hwan94877103-cloud/Re-Cell/images/process/공정1_팩입고_최종.png

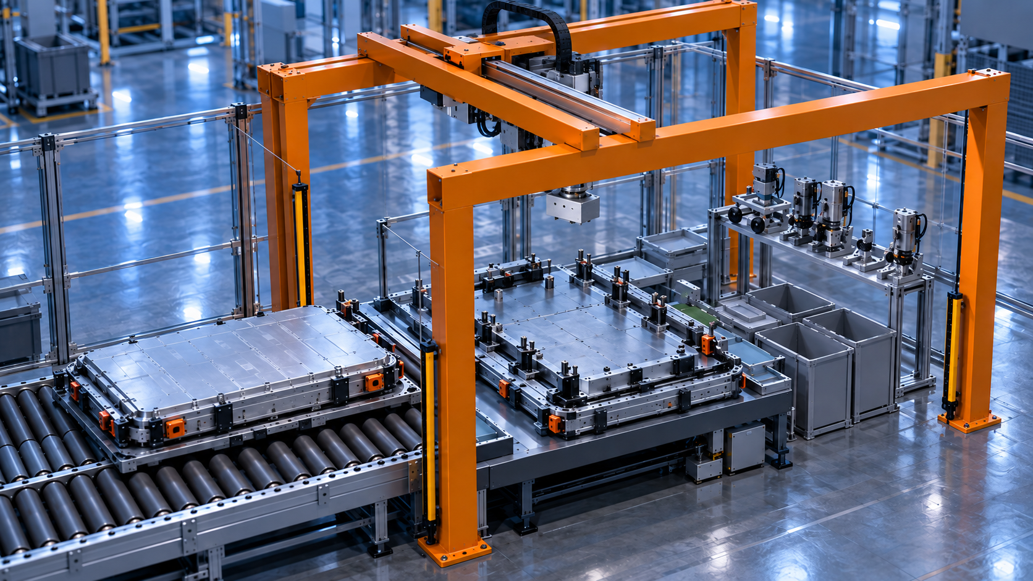
images/process/공정1_팩입고_최종.png
