hwan94877103-cloud/Re-Cell/images/process/공정2_커버제거_최종.png

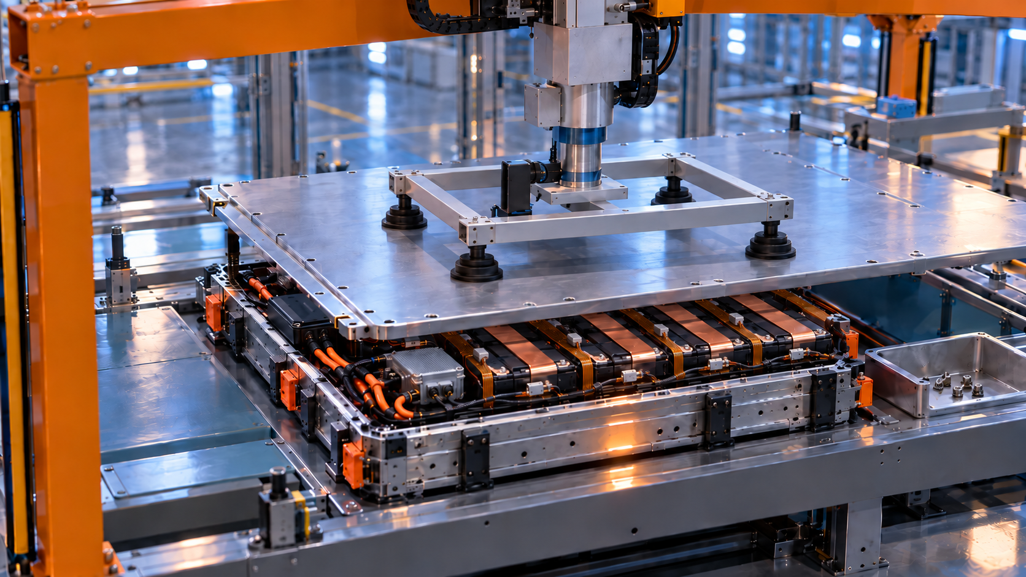
images/process/공정2_커버제거_최종.png
