hwan94877103-cloud/Re-Cell/images/process/공정3_버스바절단_최종.png

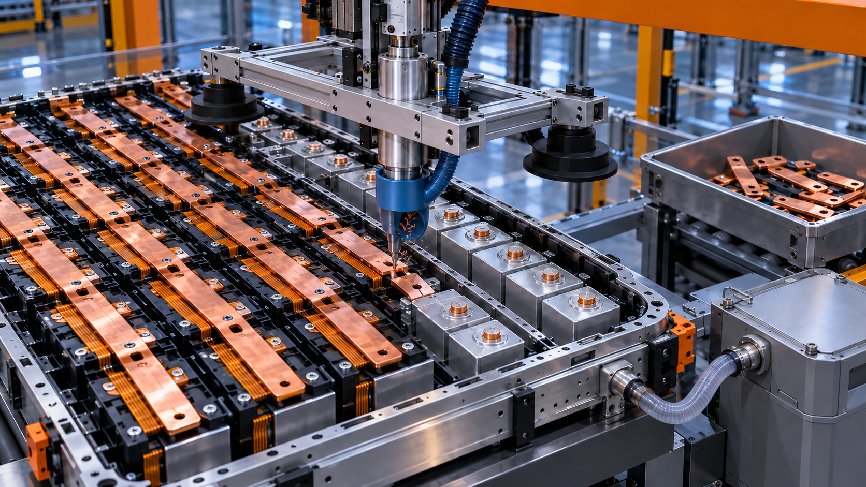
images/process/공정3_버스바절단_최종.png
