hwan94877103-cloud/Re-Cell/images/process/공정4_구역가열_최종.png

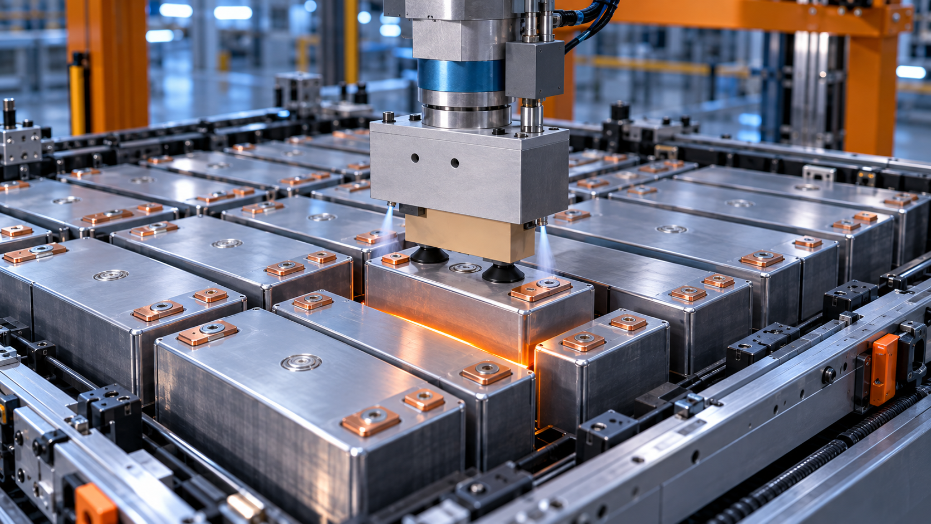
images/process/공정4_구역가열_최종.png
