hwan94877103-cloud/Re-Cell/images/process/공정5_셀들기_최종.png

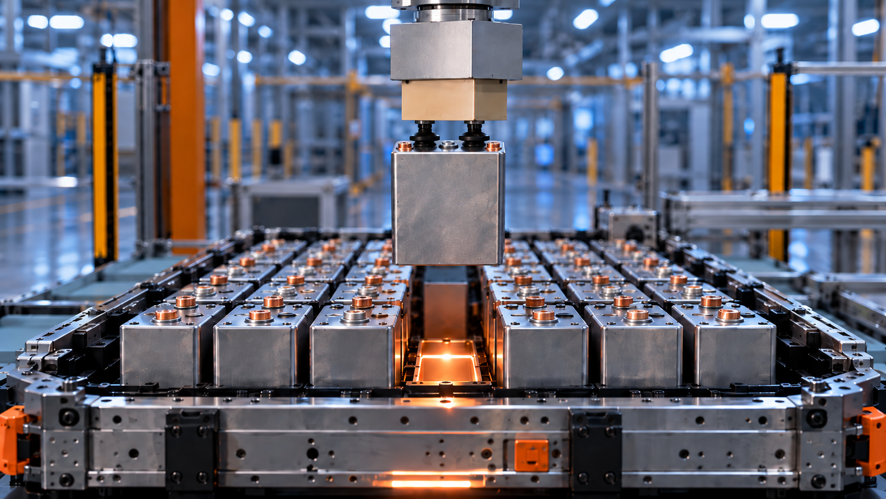
images/process/공정5_셀들기_최종.png
