hwan94877103-cloud/Re-Cell/images/process/공정6_측정분류_최종.png

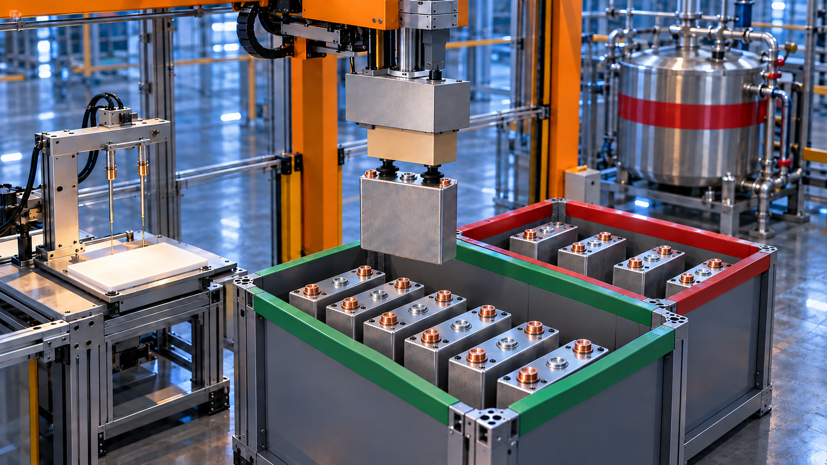
images/process/공정6_측정분류_최종.png
