hwan94877103-cloud/Re-Cell/images/renders/TOOL02_tool02_below.png

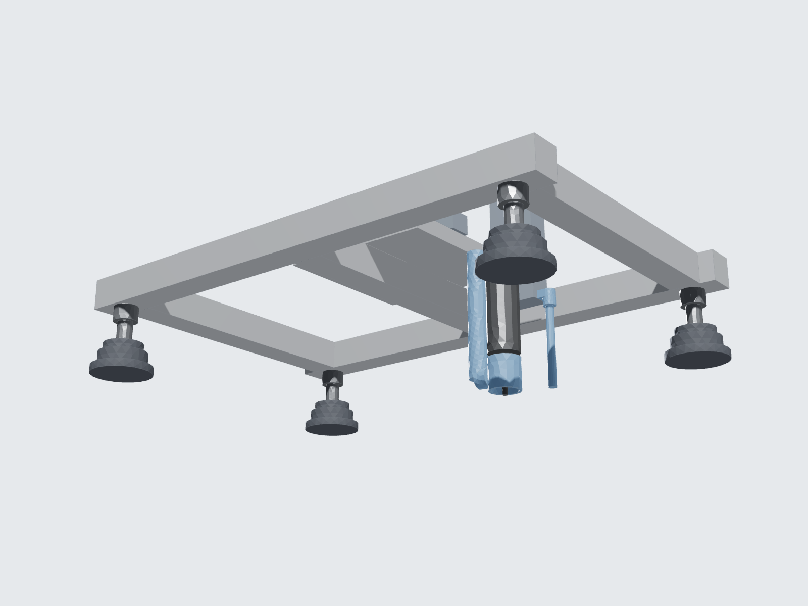
images/renders/TOOL02_tool02_below.png
