hwan94877103-cloud/Re-Cell/images/renders/TOOL03_등각_가장자리음영_크롭.png

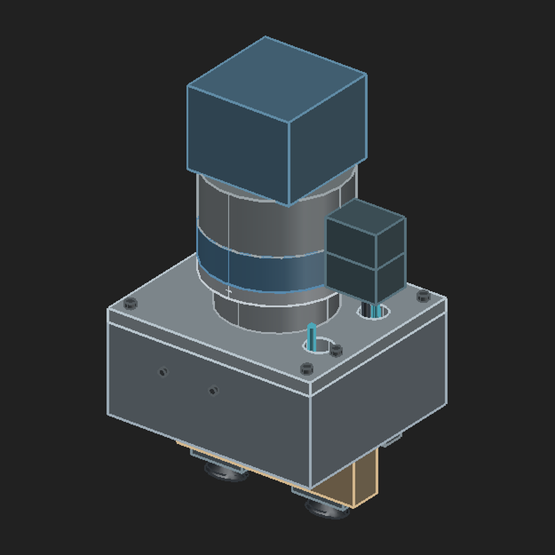
images/renders/TOOL03_등각_가장자리음영_크롭.png
