hwan94877103-cloud/Re-Cell/images/renders/TOOL03_아래에서_현실적_크롭.png

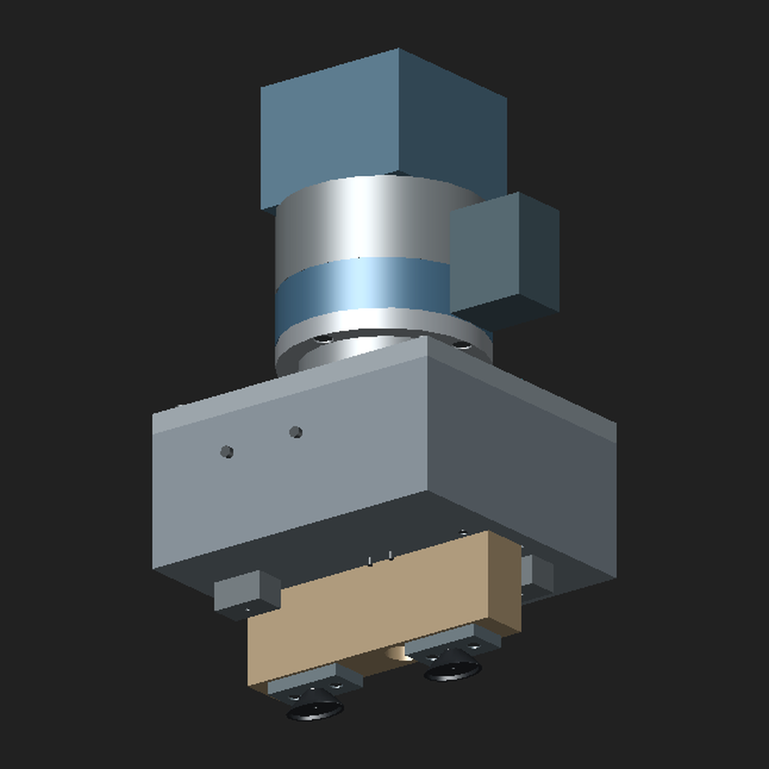
images/renders/TOOL03_아래에서_현실적_크롭.png
