hwan94877103-cloud/Re-Cell/3d/TOOL03_R03_assembly.step

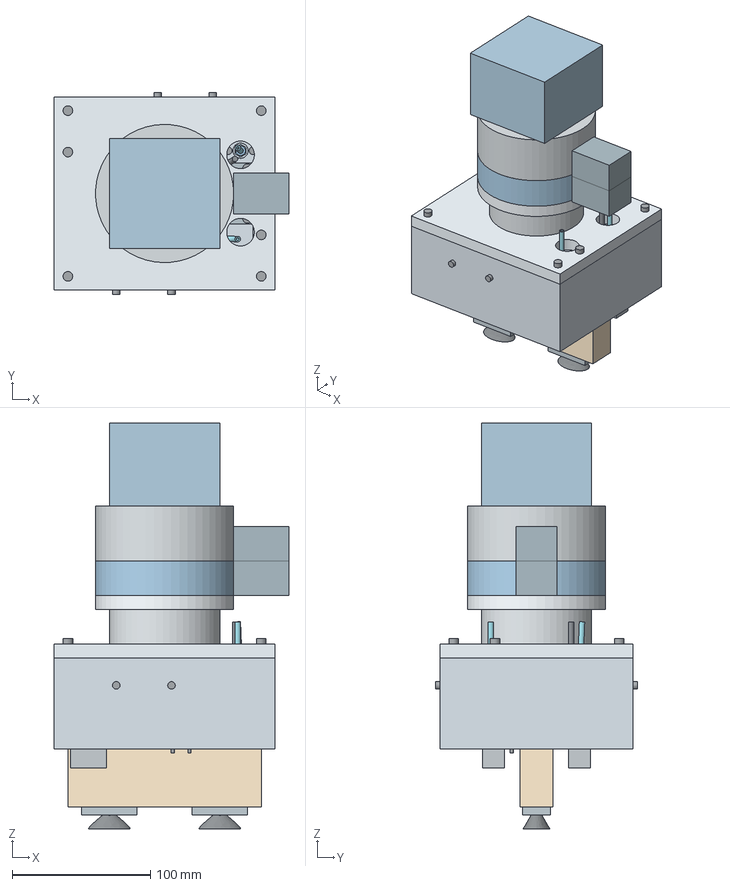
[picture p28: CAD file, 2026-10-16]
3d/TOOL03_R03_assembly.step
170.0 x 146.0 x 294.0 mm
000_03-001_nose_PEEK
001_03-002_housing_body
002_03-003_top_plate_t10
003_03-004_retainer_front
004_03-005_retainer_rear_left
005_03-006_retainer_rear_right
006_03-007_cup_bracket
007_03-102_cup_nipple_M5
008_03-103_nut_M5_thin
009_03-101_oval_cup_30x20
010_03-206_insert_M3_PEEK
011_03-205_SHCS_M3x8_cup
012_03-206_insert_M3_PEEK
013_03-205_SHCS_M3x8_cup
014_03-301_vacuum_hose_OD4
015_03-007_cup_bracket
016_03-102_cup_nipple_M5
017_03-103_nut_M5_thin
018_03-101_oval_cup_30x20
019_03-206_insert_M3_PEEK
020_03-205_SHCS_M3x8_cup
021_03-206_insert_M3_PEEK
022_03-205_SHCS_M3x8_cup
023_03-301_vacuum_hose_OD4
024_03-104_IR_sensor_D18x40
025_03-008_IR_clamp_rear
026_03-009_IR_clamp_front
027_03-204_SHCS_M3x30
028_03-204_SHCS_M3x30
029_03-203_SHCS_M3x25
030_03-203_SHCS_M3x25
031_03-105_IR_cable
032_03-201_SHCS_M4x18_retainer
033_03-201_SHCS_M4x18_retainer
034_03-201_SHCS_M4x18_retainer
035_03-201_SHCS_M4x18_retainer
036_03-207_SHCS_M3x12
037_03-207_SHCS_M3x12
038_03-010_nozzle_block
039_03-213_O_ring_P6
040_03-106_push_in_fitting_M5
041_03-207_SHCS_M3x12
042_03-207_SHCS_M3x12
043_03-010_nozzle_block
044_03-213_O_ring_P6
045_03-106_push_in_fitting_M5
046_03-302_cooling_air_hose_OD4
047_03-302_cooling_air_hose_OD4
048_03-107_vacuum_unit
049_03-212_SHCS_M3x8_unit
050_03-212_SHCS_M3x8_unit
051_03-107_vacuum_unit
052_03-212_SHCS_M3x8_unit
053_03-212_SHCS_M3x8_unit
054_03-208_SHCS_M4x20
055_03-208_SHCS_M4x20
056_03-208_SHCS_M4x20
057_03-208_SHCS_M4x20
058_03-208_SHCS_M4x20
059_03-208_SHCS_M4x20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
