hwan94877103-cloud/Re-Cell/3d/BENCH_block_2x12_assembly.step

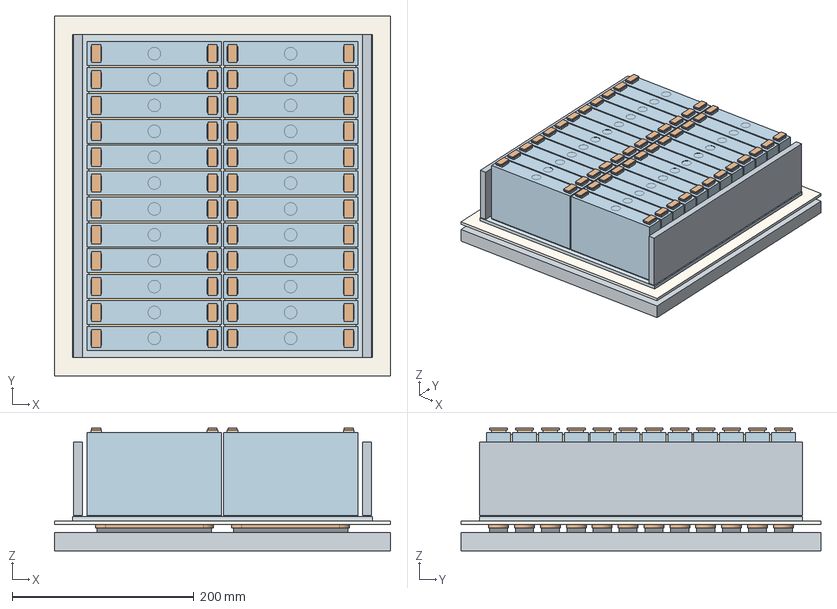
[picture p29: CAD file, 2026-10-16]
3d/BENCH_block_2x12_assembly.step
370.0 x 396.0 x 135.0 mm
000_cell_A-6
001_terminal_A-6
002_busbar_residue_A-6
003_terminal_A-6
004_busbar_residue_A-6
005_adhesive_layer_A-6
006_compression_pad_A-6
007_coil_A-6
008_ferrite_A-6
009_temp_sensor_A-6
010_cell_A-5
011_terminal_A-5
012_busbar_residue_A-5
013_terminal_A-5
014_busbar_residue_A-5
015_adhesive_layer_A-5
016_compression_pad_A-5
017_coil_A-5
018_ferrite_A-5
019_temp_sensor_A-5
020_cell_A-4
021_terminal_A-4
022_busbar_residue_A-4
023_terminal_A-4
024_busbar_residue_A-4
025_adhesive_layer_A-4
026_compression_pad_A-4
027_coil_A-4
028_ferrite_A-4
029_temp_sensor_A-4
030_cell_A-3
031_terminal_A-3
032_busbar_residue_A-3
033_terminal_A-3
034_busbar_residue_A-3
035_adhesive_layer_A-3
036_compression_pad_A-3
037_coil_A-3
038_ferrite_A-3
039_temp_sensor_A-3
040_cell_A-2
041_terminal_A-2
042_busbar_residue_A-2
043_terminal_A-2
044_busbar_residue_A-2
045_adhesive_layer_A-2
046_compression_pad_A-2
047_coil_A-2
048_ferrite_A-2
049_temp_sensor_A-2
050_cell_A-1
051_terminal_A-1
052_busbar_residue_A-1
053_terminal_A-1
054_busbar_residue_A-1
055_adhesive_layer_A-1
056_compression_pad_A-1
057_coil_A-1
058_ferrite_A-1
059_temp_sensor_A-1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
