hwan94877103-cloud/Re-Cell/3d/CTP_R03_complete_assembly_working_pose.step

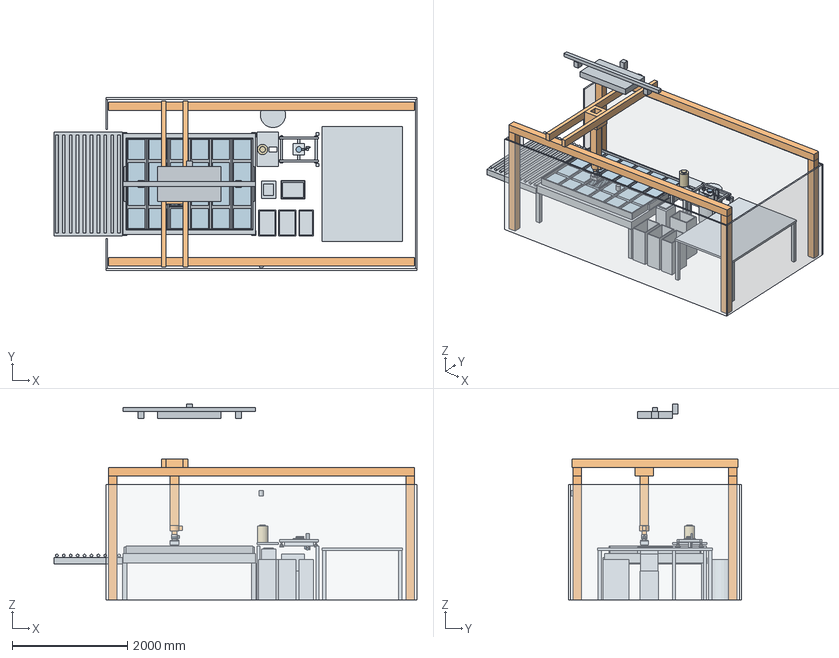
[picture p30: CAD file, 2026-10-16]
3d/CTP_R03_complete_assembly_working_pose.step
6300.0 x 3000.0 x 3400.0 mm
000_fence_safety_fence
001_fence_safety_fence
002_fence_safety_fence
003_fence_safety_fence
004_fence_safety_fence
005_conveyor_intake_conveyor
006_conveyor_roller
007_conveyor_roller
008_conveyor_roller
009_conveyor_roller
010_conveyor_roller
011_conveyor_roller
012_conveyor_roller
013_conveyor_roller
014_conveyor_roller
015_conveyor_roller
016_bench_heating_bench_coil_zone
017_bench_leg
018_bench_leg
019_bench_leg
020_bench_leg
021_bench_pack_clamp
022_bench_pack_clamp
023_pack_frame
024_pack_frame
025_pack_frame
026_pack_frame
027_pack_cooling_plate
028_pack_cell_block_2x12
029_pack_cell_block_2x12
030_pack_cell_block_2x12
031_pack_cell_block_2x12
032_pack_cell_block_2x12
033_pack_cell_block_2x12
034_pack_cell_block_2x12
035_pack_cell_block_2x12
036_pack_cell_block_2x12
037_pack_cell_block_2x12
038_pack_cell_block_2x12
039_pack_cell_block_2x12
040_pack_cell_block_2x12
041_pack_cell_block_2x12
042_pack_cell_block_2x12
043_pack_cell_block_2x12
044_pack_cell_block_2x12
045_pack_cell_block_2x12
046_pack_cell_block_2x12
047_pack_cell_block_2x12
048_pack_cell_block_2x12
049_pack_cell_block_2x12
050_pack_cell_block_2x12
051_pack_block_end_member
052_pack_block_end_member
053_pack_block_end_member
054_pack_block_end_member
055_pack_block_end_member
056_gantry_column
057_gantry_column
058_gantry_column
059_gantry_column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
