hwan94877103-cloud/Re-Cell/3d/TOOL02_R03_outline_assembly.step

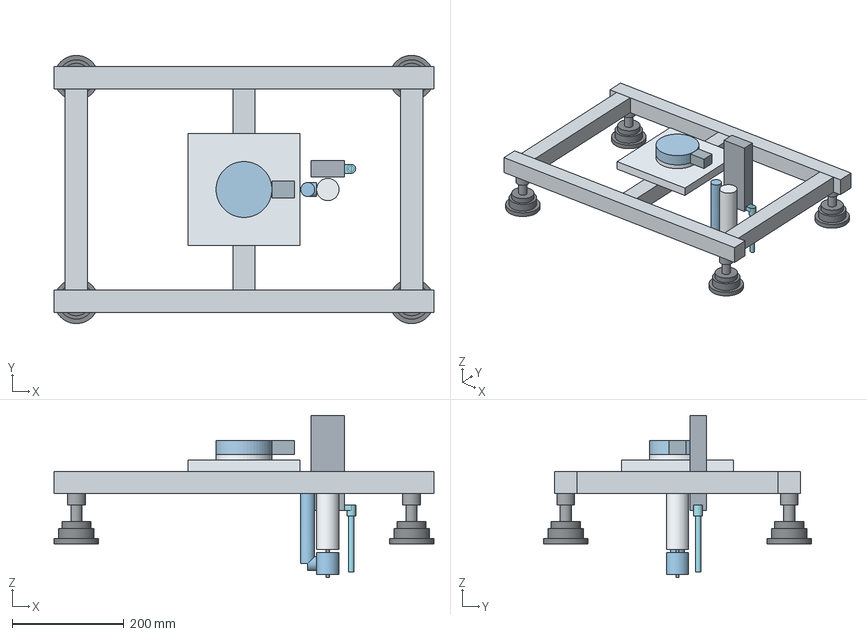
[picture p31: CAD file, 2026-10-16]
3d/TOOL02_R03_outline_assembly.step
680.0 x 480.0 x 290.0 mm
000_suction_cup_D80
001_cup_spring_holder
002_suction_cup_D80
003_cup_spring_holder
004_suction_cup_D80
005_cup_spring_holder
006_suction_cup_D80
007_cup_spring_holder
008_frame_profile_40x40
009_frame_profile_40x40
010_frame_profile_40x40
011_frame_profile_40x40
012_frame_profile_40x40
013_hub_plate
014_adapter_plate
015_changer_tool_plate_D100
016_pass_through_module_tool_side
017_pneumatic_slide_stroke80
018_cutting_spindle_D40
019_end_mill_D6
020_chip_suction_hood_D40
021_chip_suction_hose_D25
022_coolant_suction_nozzle_D10
