hwan94877103-cloud/Re-Cell/drawings/dxf/D-04_R03_2of5.dxf

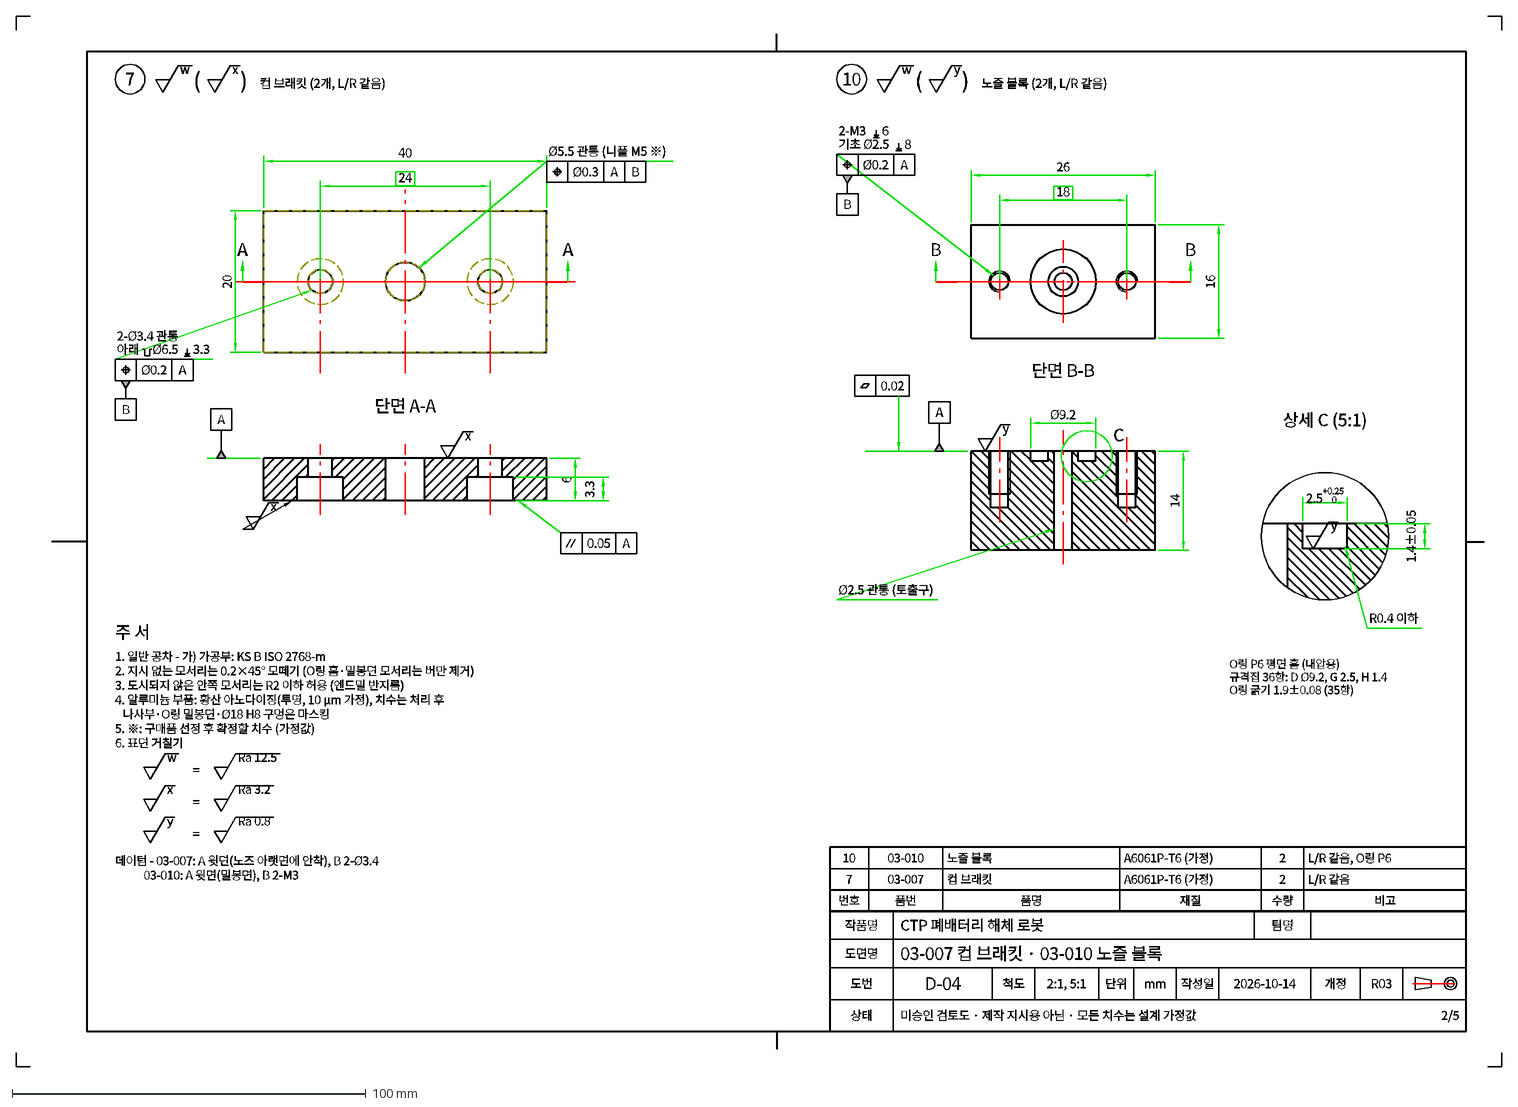
[picture p32: CAD file, 2026-10-16]
drawings/dxf/D-04_R03_2of5.dxf
작품명
CTP 폐배터리 해체 로봇
팀명
도면명
03-007 컵 브래킷 · 03-010 노즐 블록
도번
D-04
척도
2:1, 5:1
단위
mm
작성일
2026-10-14
개정
R03
상태
미승인 검토도 · 제작 지시용 아님 · 모든 치수는 설계 가정값
2/5
A
단면 A-A
40
24
20
6
3.3
아래
Ø6.5
2-Ø3.4 관통
Ø0.2
B
Ø5.5 관통 (니플 M5 ※)
Ø0.3
x
0.05
7
w
(
)
컵 브래킷 (2개, L/R 같음)
단면 B-B
26
18
16
14
Ø9.2
기초 Ø2.5
8
2-M3
Ø2.5 관통 (토출구)
0.02
y
C
상세 C (5:1)
2.5+0.25^ 0
1.4±0.05
R0.4 이하
O링 P6 평면 홈 (내압용)
규격집 36항: D Ø9.2, G 2.5, H 1.4
O링 굵기 1.9±0.08 (35항)
10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
