hwan94877103-cloud/Re-Cell/3d/TOOL03_machined_parts_in_place.step

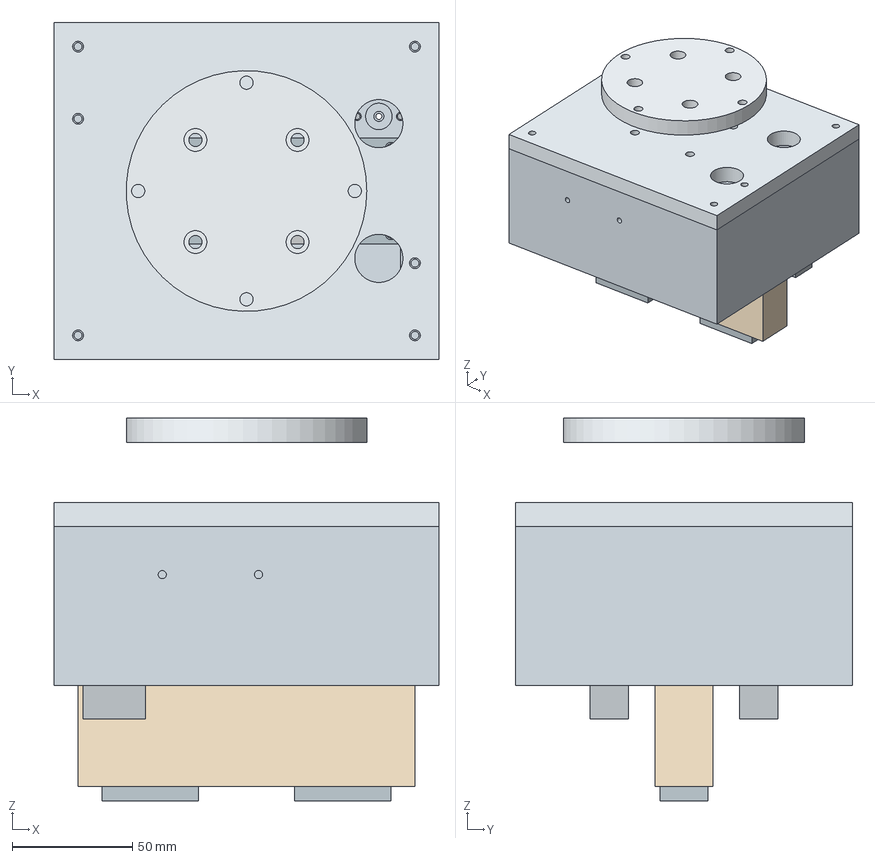
[picture p33: CAD file, 2026-10-16]
3d/TOOL03_machined_parts_in_place.step
160.0 x 140.0 x 159.0 mm
000_03-001_nose_PEEK
001_03-002_housing_body
002_03-003_top_plate_t10
003_03-004_retainer_front
004_03-005_retainer_rear_left
005_03-006_retainer_rear_right
006_03-007_cup_bracket
007_03-007_cup_bracket
008_03-008_IR_clamp_rear
009_03-009_IR_clamp_front
010_03-010_nozzle_block
011_03-010_nozzle_block
012_03-011_loadcell_adapter_plate
