hwan94877103-cloud/Re-Cell/drawings/dxf/D-02_R03_3of3.dxf

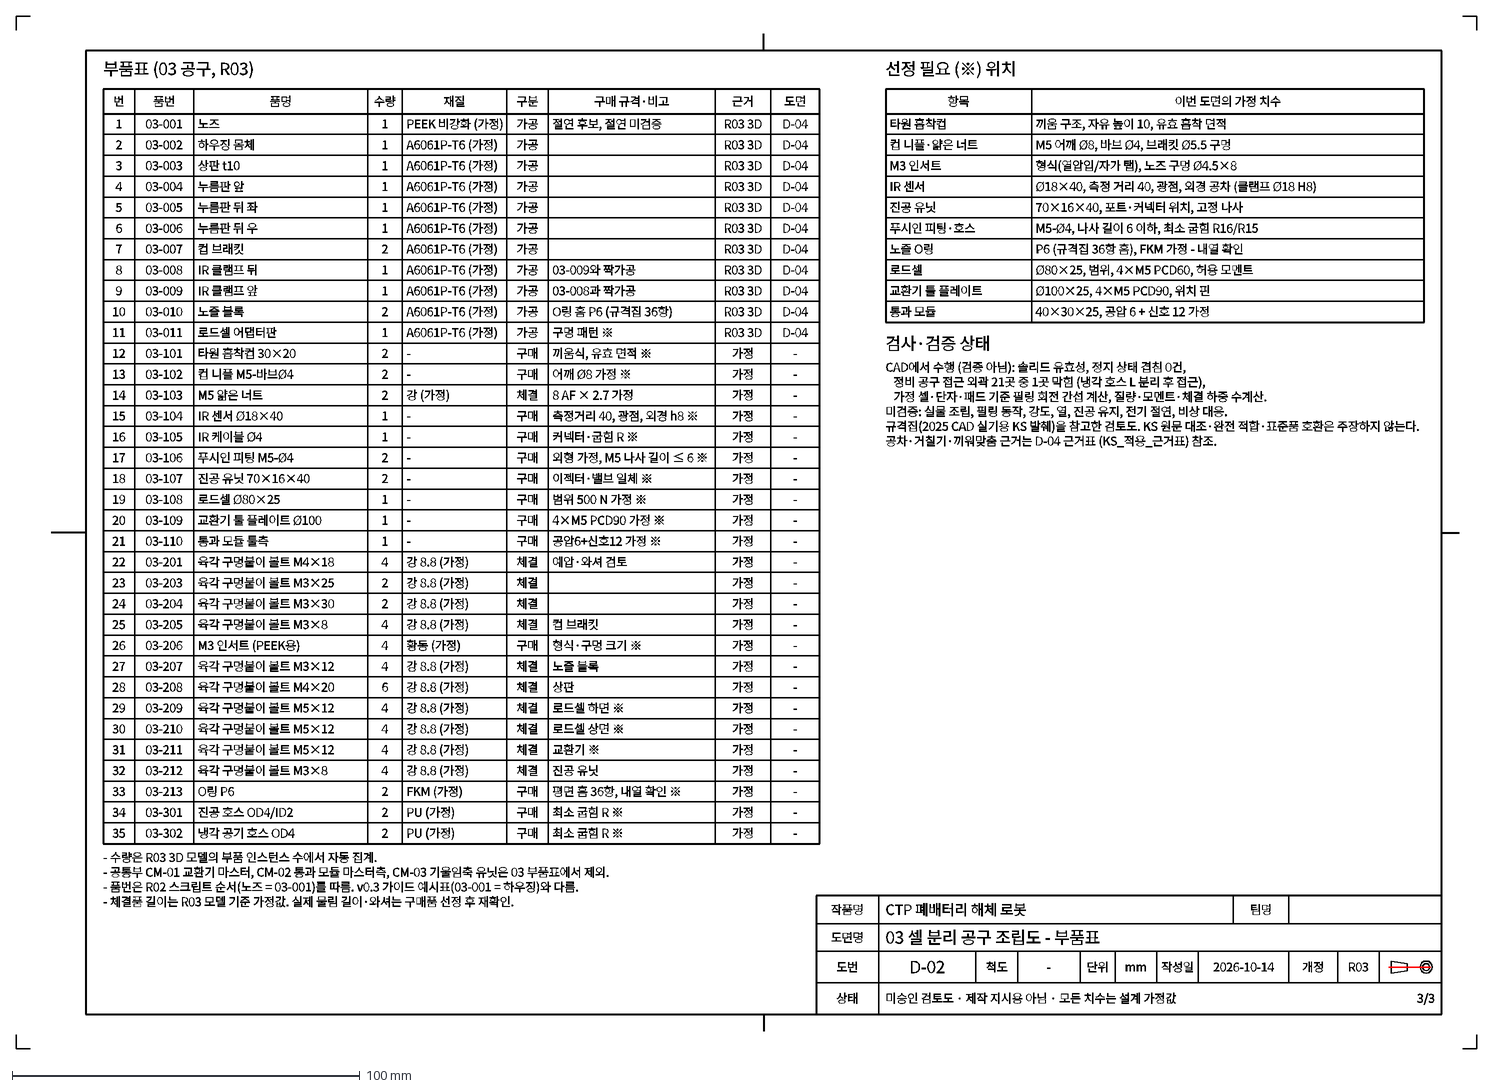
[picture p34: CAD file, 2026-10-16]
drawings/dxf/D-02_R03_3of3.dxf
작품명
CTP 폐배터리 해체 로봇
팀명
도면명
03 셀 분리 공구 조립도 - 부품표
도번
D-02
척도
-
단위
mm
작성일
2026-10-14
개정
R03
상태
미승인 검토도 · 제작 지시용 아님 · 모든 치수는 설계 가정값
3/3
부품표 (03 공구, R03)
번
품번
품명
수량
재질
구분
구매 규격·비고
근거
도면
1
03-001
노즈
PEEK 비강화 (가정)
가공
절연 후보, 절연 미검증
R03 3D
D-04
2
03-002
하우징 몸체
A6061P-T6 (가정)
3
03-003
상판 t10
4
03-004
누름판 앞
5
03-005
누름판 뒤 좌
6
03-006
누름판 뒤 우
7
03-007
컵 브래킷
8
03-008
IR 클램프 뒤
03-009와 짝가공
9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
