hwan94877103-cloud/Re-Cell/3d/BENCH_with_TOOL03_working_pose.step

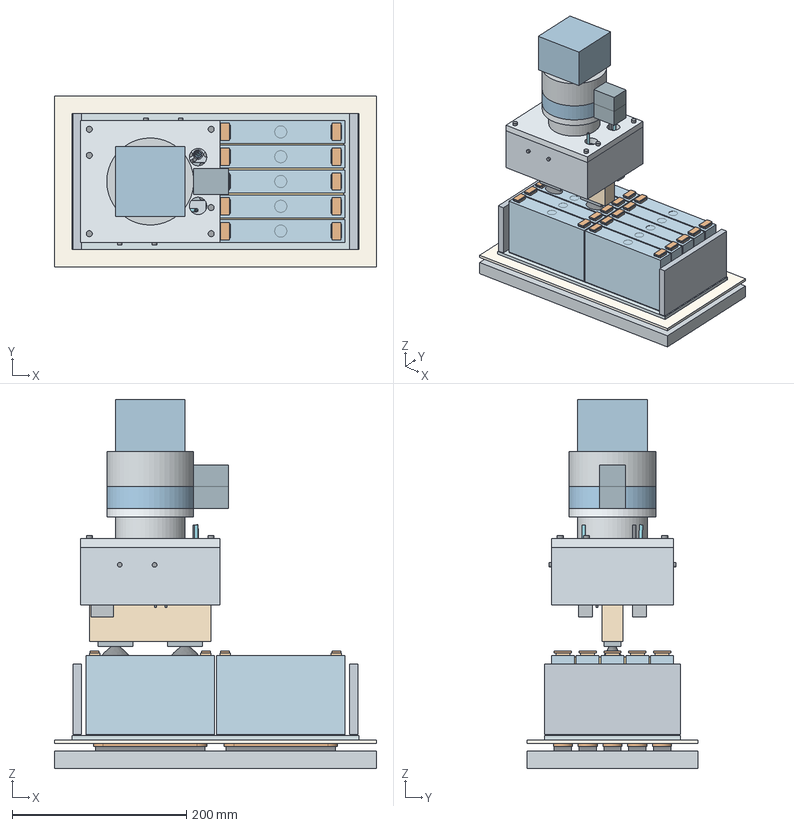
[picture p35: CAD file, 2026-10-16]
3d/BENCH_with_TOOL03_working_pose.step
370.0 x 196.5 x 424.0 mm
000_cell_A-2
001_terminal_A-2
002_busbar_residue_A-2
003_terminal_A-2
004_busbar_residue_A-2
005_adhesive_layer_A-2
006_compression_pad_A-2
007_coil_A-2
008_ferrite_A-2
009_temp_sensor_A-2
010_cell_A-1
011_terminal_A-1
012_busbar_residue_A-1
013_terminal_A-1
014_busbar_residue_A-1
015_adhesive_layer_A-1
016_compression_pad_A-1
017_coil_A-1
018_ferrite_A-1
019_temp_sensor_A-1
020_cell_A+0
021_terminal_A+0
022_busbar_residue_A+0
023_terminal_A+0
024_busbar_residue_A+0
025_adhesive_layer_A+0
026_compression_pad_A+0
027_coil_A+0
028_ferrite_A+0
029_temp_sensor_A+0
030_cell_A+1
031_terminal_A+1
032_busbar_residue_A+1
033_terminal_A+1
034_busbar_residue_A+1
035_adhesive_layer_A+1
036_compression_pad_A+1
037_coil_A+1
038_ferrite_A+1
039_temp_sensor_A+1
040_cell_A+2
041_terminal_A+2
042_busbar_residue_A+2
043_terminal_A+2
044_busbar_residue_A+2
045_adhesive_layer_A+2
046_coil_A+2
047_ferrite_A+2
048_temp_sensor_A+2
049_cell_B-2
050_terminal_B-2
051_busbar_residue_B-2
052_terminal_B-2
053_busbar_residue_B-2
054_adhesive_layer_B-2
055_compression_pad_B-2
056_coil_B-2
057_ferrite_B-2
058_temp_sensor_B-2
059_cell_B-1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
