hwan94877103-cloud/Re-Cell/drawings/dxf/D-04_R03_5of5.dxf

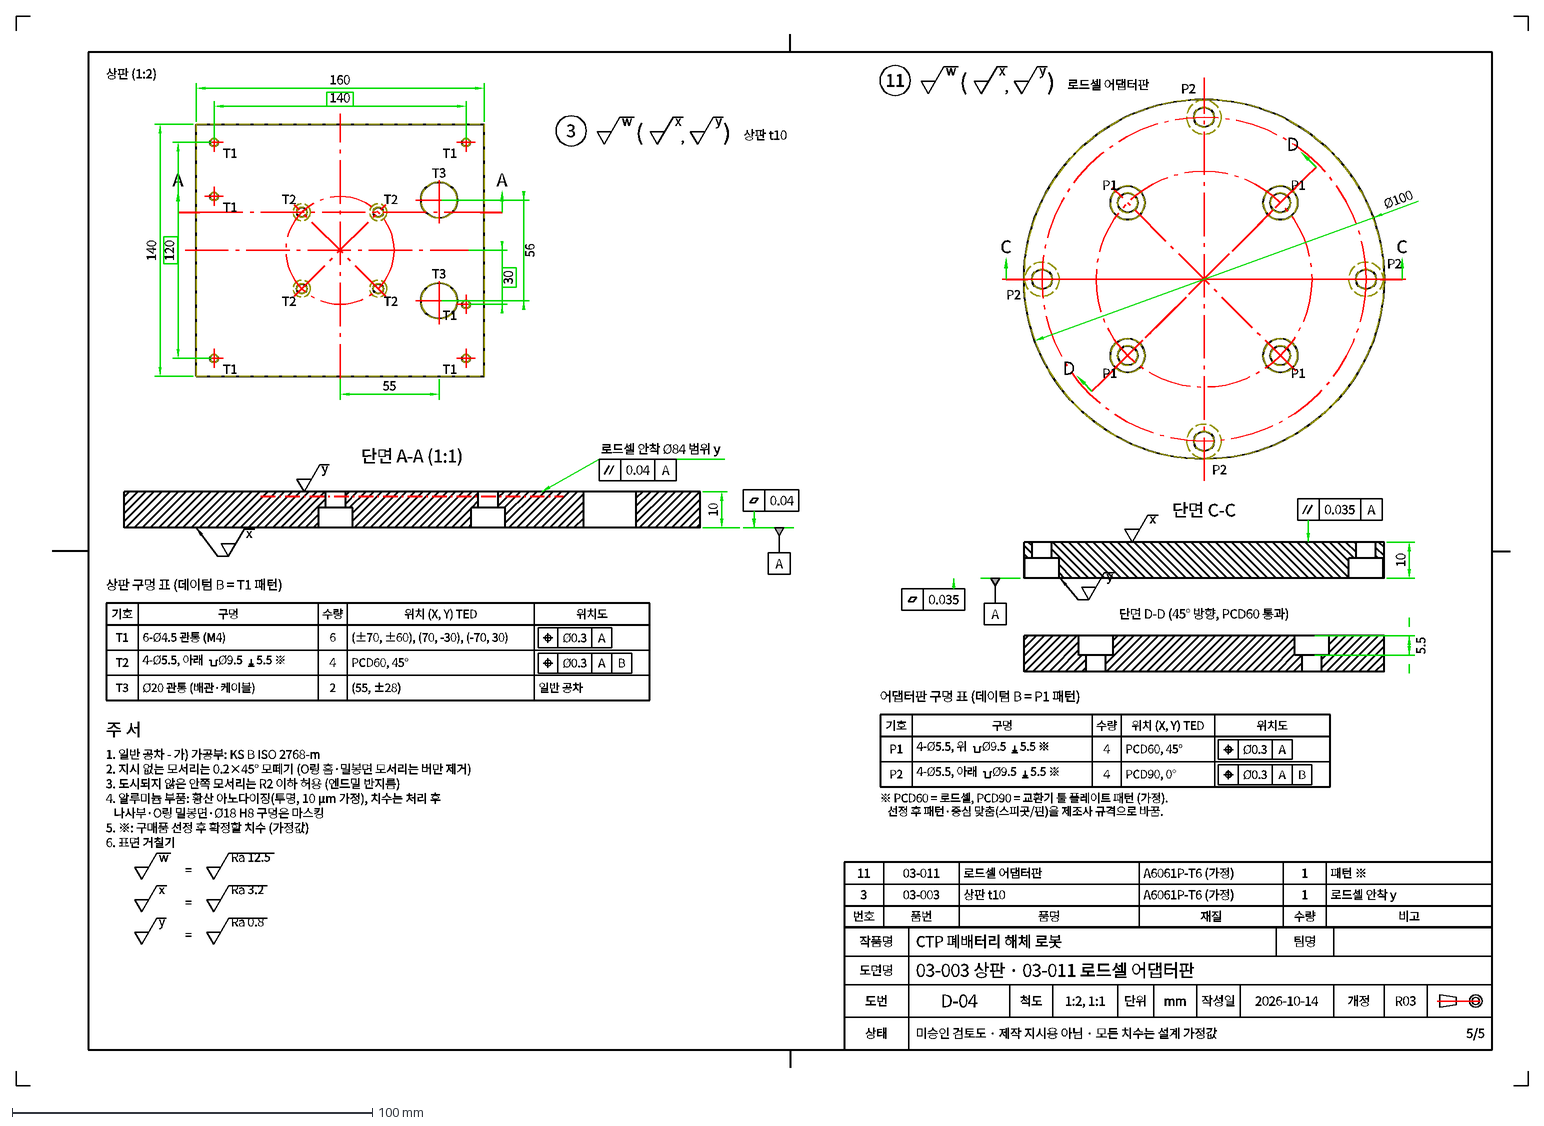
[picture p36: CAD file, 2026-10-16]
drawings/dxf/D-04_R03_5of5.dxf
작품명
CTP 폐배터리 해체 로봇
팀명
도면명
03-003 상판 · 03-011 로드셀 어댑터판
도번
D-04
척도
1:2, 1:1
단위
mm
작성일
2026-10-14
개정
R03
상태
미승인 검토도 · 제작 지시용 아님 · 모든 치수는 설계 가정값
5/5
A
상판 (1:2)
단면 A-A (1:1)
160
140
120
30
56
55
10
T1
T2
T3
0.04
x
y
로드셀 안착 Ø84 범위 y
상판 구멍 표 (데이텀 B = T1 패턴)
기호
구멍
수량
위치 (X, Y) TED
위치도
6-Ø4.5 관통 (M4)
6
(±70, ±60), (70, -30), (-70, 30)
4-Ø5.5, 아래
Ø9.5
5.5 ※
4
PCD60, 45°
Ø20 관통 (배관·케이블)
2
(55, ±28)
일반 공차
Ø0.3
B
3
w
(
,
)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
