hwan94877103-cloud/Re-Cell/drawings/dxf/D-04_R03_4of5.dxf

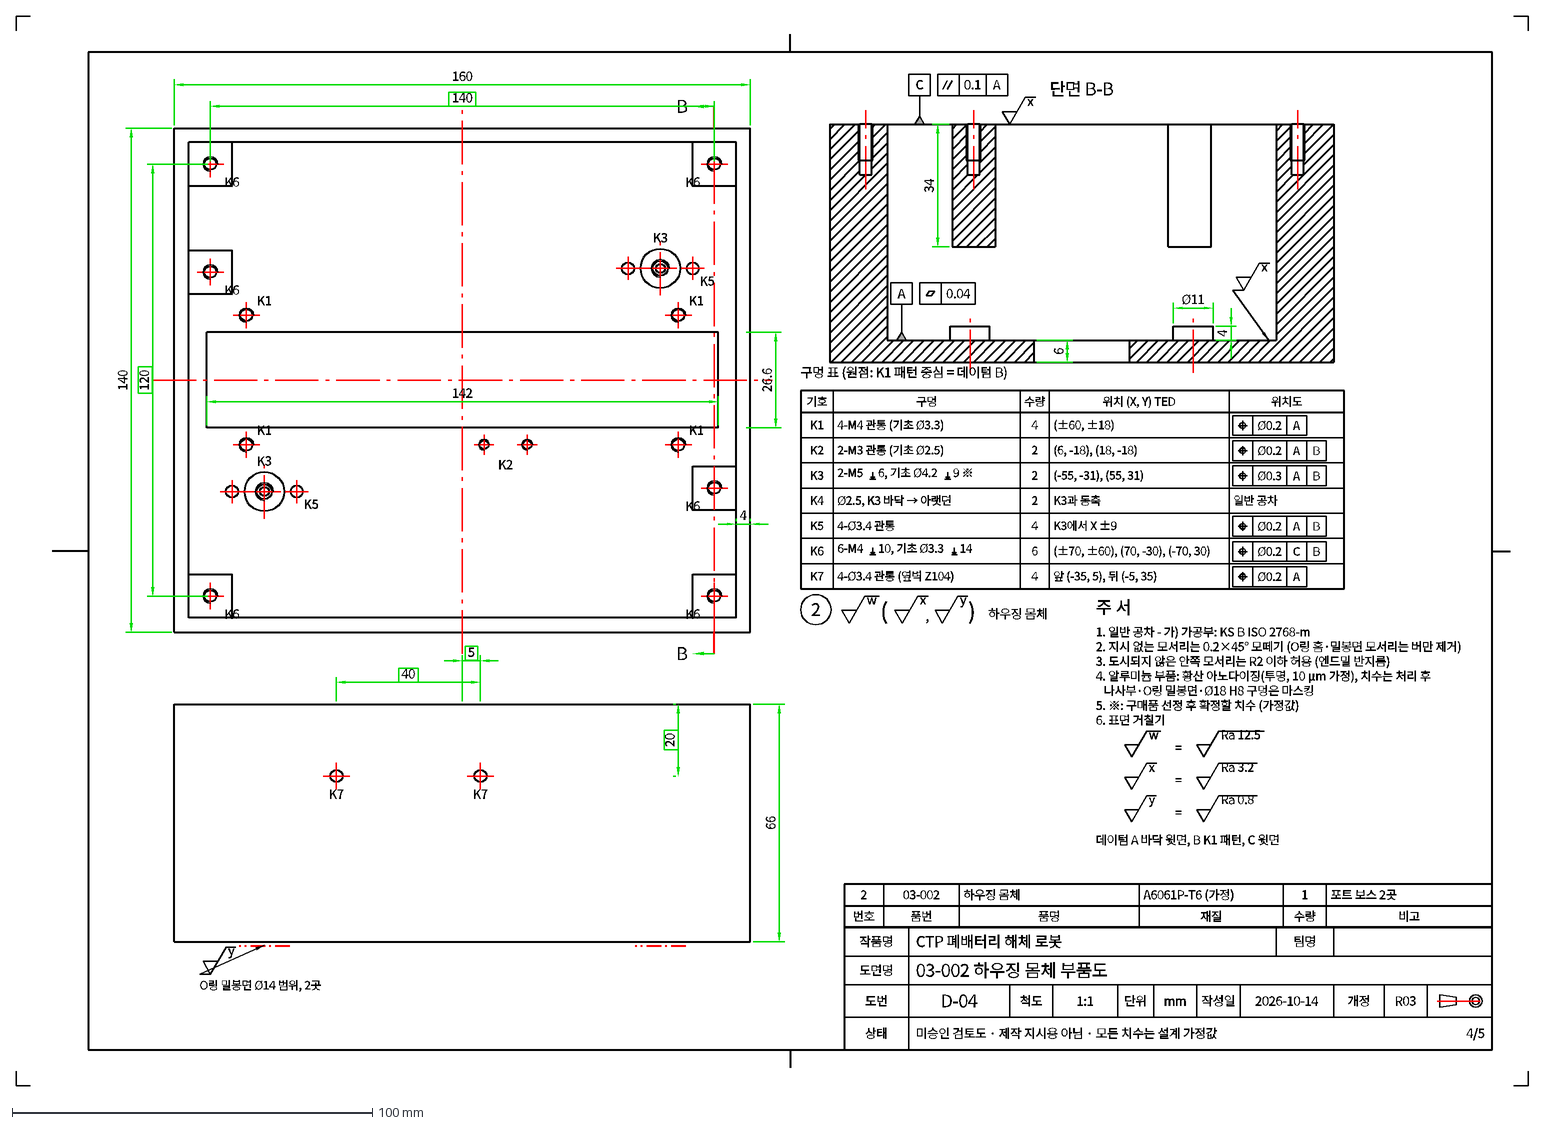
[picture p37: CAD file, 2026-10-16]
drawings/dxf/D-04_R03_4of5.dxf
작품명
CTP 폐배터리 해체 로봇
팀명
도면명
03-002 하우징 몸체 부품도
도번
D-04
척도
1:1
단위
mm
작성일
2026-10-14
개정
R03
상태
미승인 검토도 · 제작 지시용 아님 · 모든 치수는 설계 가정값
4/5
B
단면 B-B
160
140
120
142
26.6
4
66
40
5
20
34
6
Ø11
A
0.04
C
0.1
x
y
O링 밀봉면 Ø14 범위, 2곳
K1
K2
K3
K5
K6
K7
구멍 표 (원점: K1 패턴 중심 = 데이텀 B)
기호
구멍
수량
위치 (X, Y) TED
위치도
4-M4 관통 (기초 Ø3.3)
(±60, ±18)
2-M3 관통 (기초 Ø2.5)
2
(6, -18), (18, -18)
2-M5
6, 기초 Ø4.2
9 ※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
