hwan94877103-cloud/Re-Cell/drawings/dxf/D-09_R03_1of1.dxf

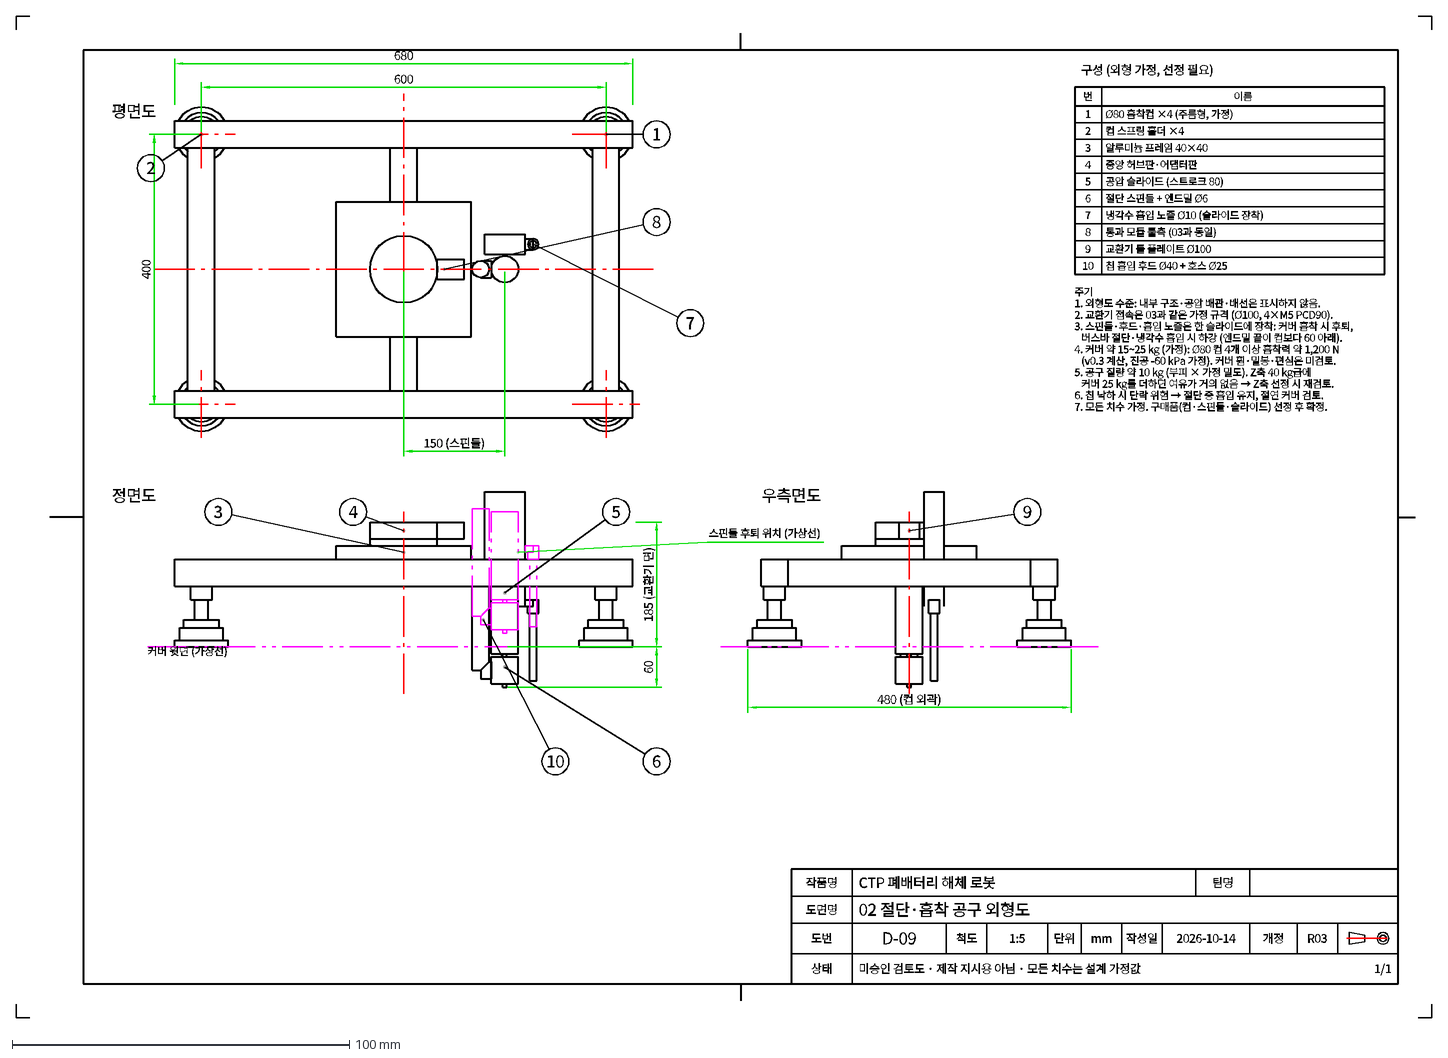
[picture p38: CAD file, 2026-10-16]
drawings/dxf/D-09_R03_1of1.dxf
작품명
CTP 폐배터리 해체 로봇
팀명
도면명
02 절단·흡착 공구 외형도
도번
D-09
척도
1:5
단위
mm
작성일
2026-10-14
개정
R03
상태
미승인 검토도 · 제작 지시용 아님 · 모든 치수는 설계 가정값
1/1
커버 윗면 (가상선)
스핀들 후퇴 위치 (가상선)
600
680
400
150 (스핀들)
185 (교환기 면)
60
480 (컵 외곽)
평면도
정면도
우측면도
1
2
3
4
5
6
7
8
9
10
구성 (외형 가정, 선정 필요)
번
이름
Ø80 흡착컵 ×4 (주름형, 가정)
컵 스프링 홀더 ×4
알루미늄 프레임 40×40
중앙 허브판·어댑터판
공압 슬라이드 (스트로크 80)
절단 스핀들 + 엔드밀 Ø6
냉각수 흡입 노즐 Ø10 (슬라이드 장착)
통과 모듈 툴측 (03과 동일)
교환기 툴 플레이트 Ø100
칩 흡입 후드 Ø40 + 호스 Ø25
주기
1. 외형도 수준: 내부 구조·공압 배관·배선은 표시하지 않음.
2. 교환기 접속은 03과 같은 가정 규격 (Ø100, 4×M5 PCD90).
3. 스핀들·후드·흡입 노즐은 한 슬라이드에 장착: 커버 흡착 시 후퇴,
버스바 절단·냉각수 흡입 시 하강 (엔드밀 끝이 컵보다 60 아래).
4. 커버 약 15~25 kg (가정): Ø80 컵 4개 이상 흡착력 약 1,200 N
(v0.3 계산, 진공 -60 kPa 가정). 커버 휨·밀봉·편심은 미검토.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
