hwan94877103-cloud/Re-Cell/drawings/dxf/D-04_R03_3of5.dxf

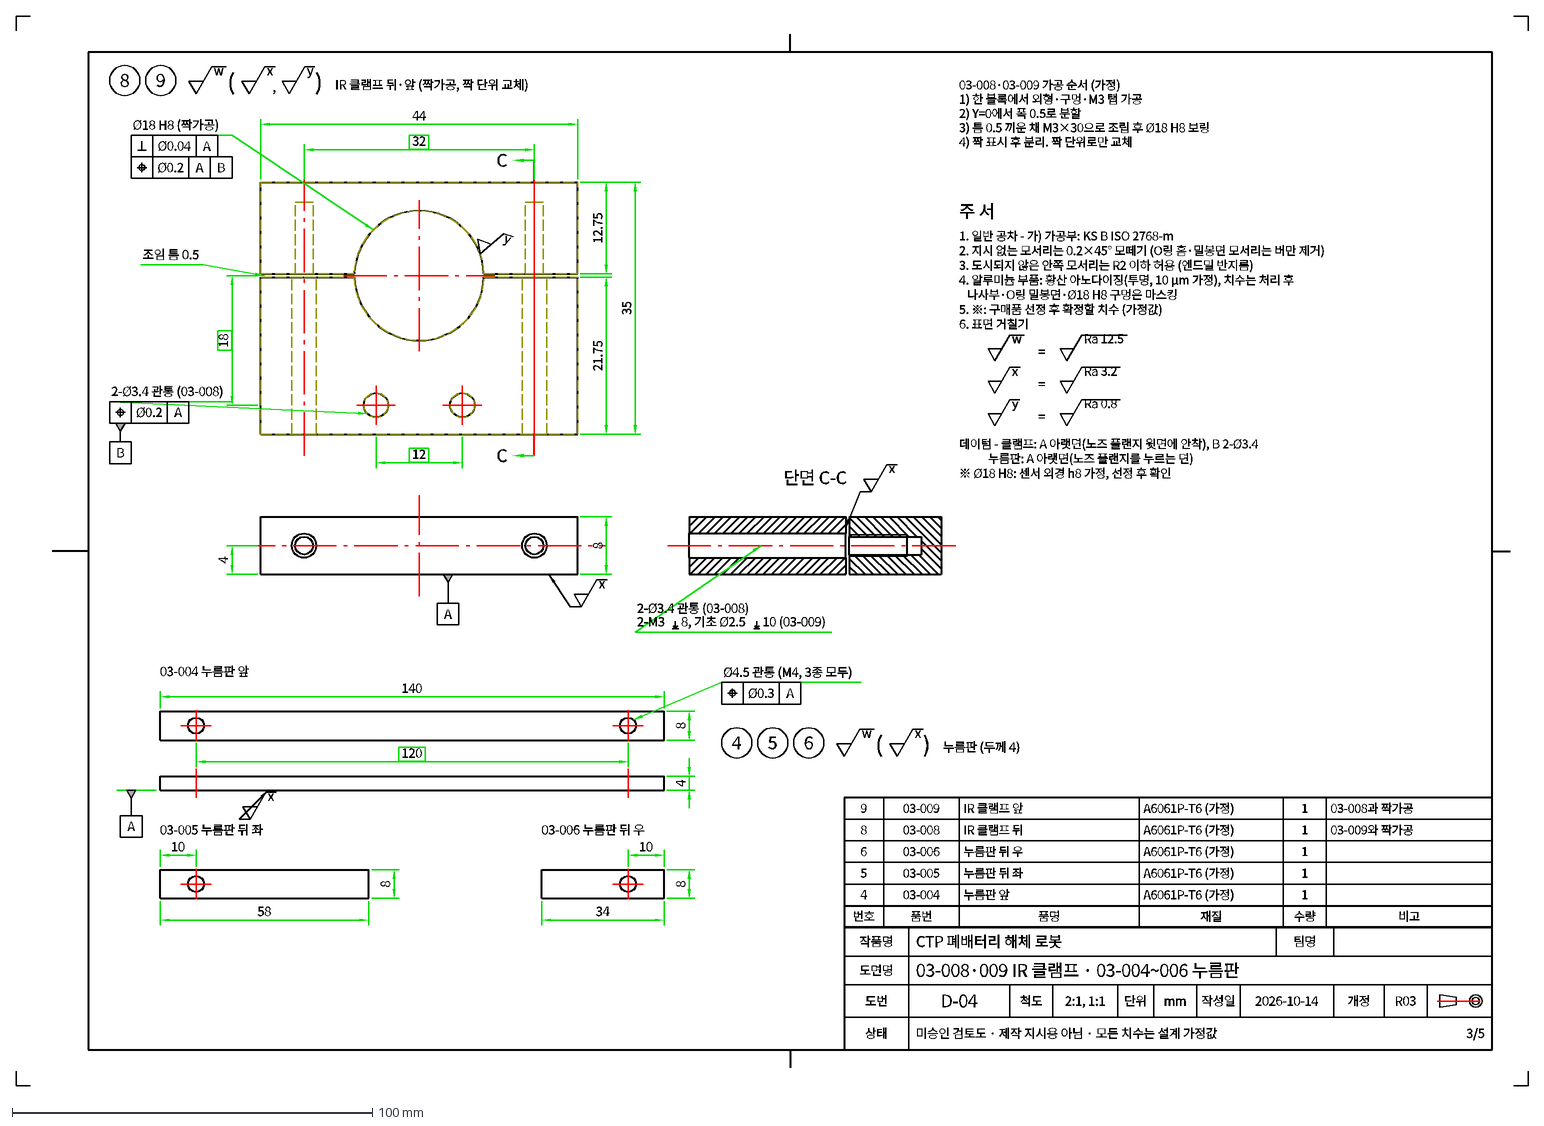
[picture p39: CAD file, 2026-10-16]
drawings/dxf/D-04_R03_3of5.dxf
작품명
CTP 폐배터리 해체 로봇
팀명
도면명
03-008·009 IR 클램프 · 03-004~006 누름판
도번
D-04
척도
2:1, 1:1
단위
mm
작성일
2026-10-14
개정
R03
상태
미승인 검토도 · 제작 지시용 아님 · 모든 치수는 설계 가정값
3/5
C
단면 C-C
44
32
35
21.75
12.75
12
18
8
4
Ø18 H8 (짝가공)
Ø0.04
A
Ø0.2
B
2-Ø3.4 관통 (03-008)
2-M3
8, 기초 Ø2.5
10 (03-009)
조임 틈 0.5
y
x
9
w
(
,
)
IR 클램프 뒤·앞 (짝가공, 짝 단위 교체)
03-008·03-009 가공 순서 (가정)
1) 한 블록에서 외형·구멍·M3 탭 가공
2) Y=0에서 폭 0.5로 분할
3) 틈 0.5 끼운 채 M3×30으로 조립 후 Ø18 H8 보링
4) 짝 표시 후 분리. 짝 단위로만 교체
03-004 누름판 앞
03-005 누름판 뒤 좌
03-006 누름판 뒤 우
140
120
58
10
34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
