hwan94877103-cloud/Re-Cell/drawings/dxf/D-03_R03_2of2.dxf

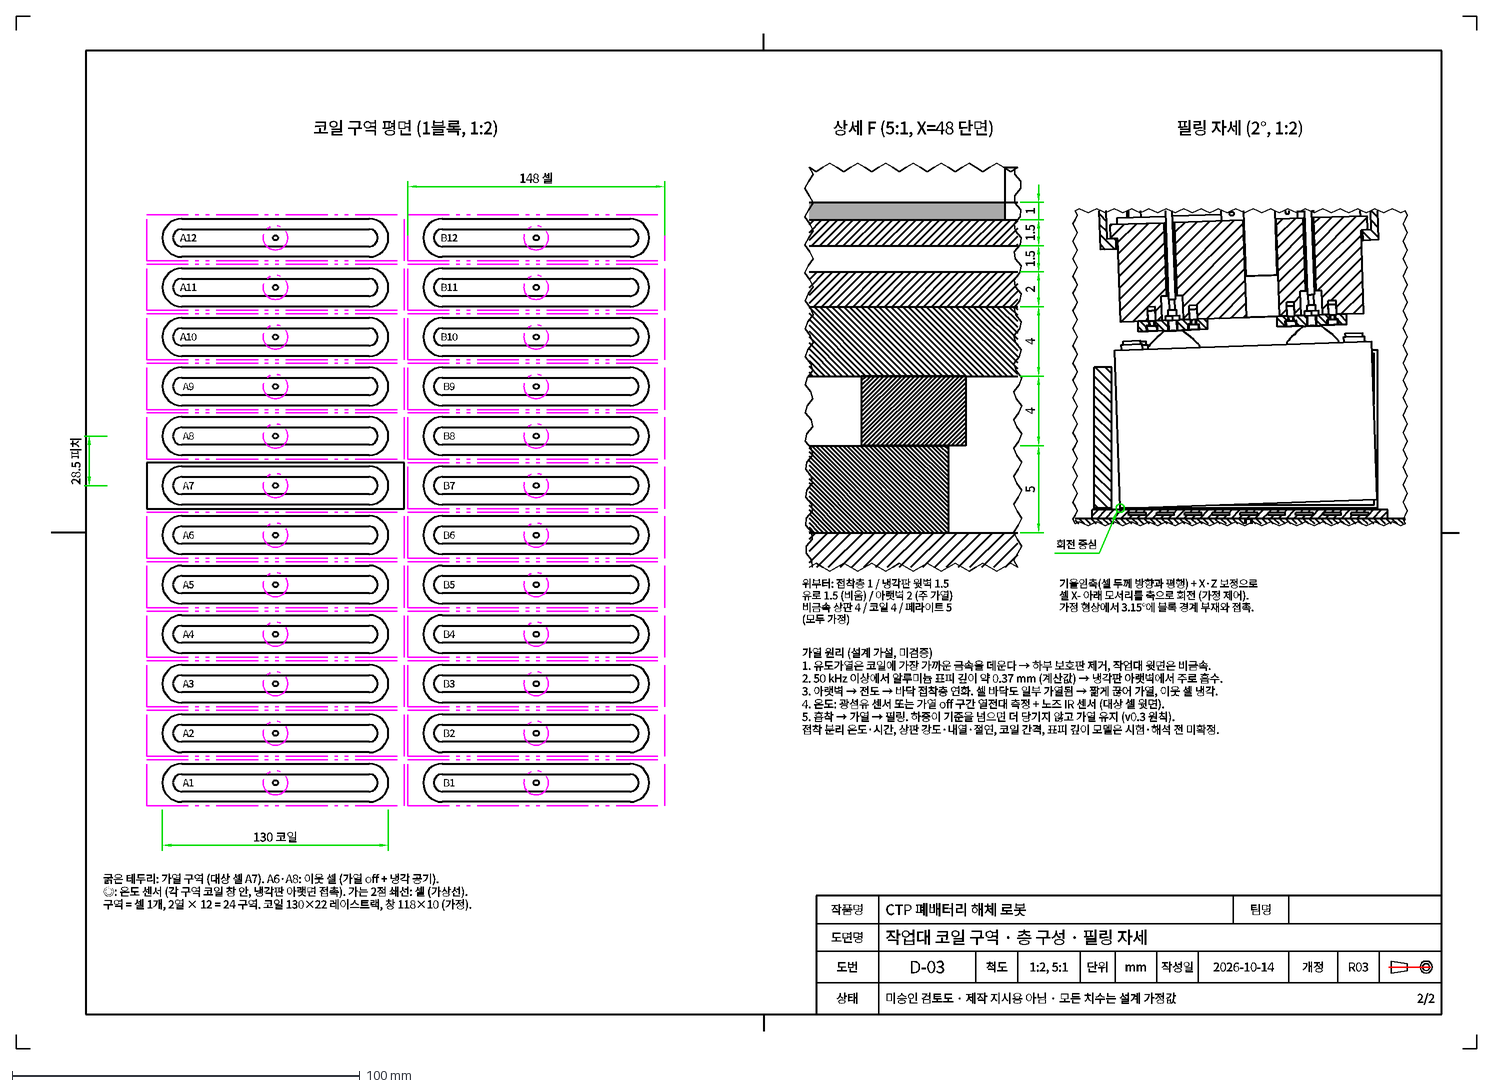
[picture p40: CAD file, 2026-10-16]
drawings/dxf/D-03_R03_2of2.dxf
작품명
CTP 폐배터리 해체 로봇
팀명
도면명
작업대 코일 구역 · 층 구성 · 필링 자세
도번
D-03
척도
1:2, 5:1
단위
mm
작성일
2026-10-14
개정
R03
상태
미승인 검토도 · 제작 지시용 아님 · 모든 치수는 설계 가정값
2/2
코일 구역 평면 (1블록, 1:2)
A1
A2
A3
A4
A5
A6
A7
A8
A9
A10
A11
A12
B1
B2
B3
B4
B5
B6
B7
B8
B9
B10
B11
B12
130 코일
148 셀
28.5 피치
굵은 테두리: 가열 구역 (대상 셀 A7). A6·A8: 이웃 셀 (가열 off + 냉각 공기).
◎: 온도 센서 (각 구역 코일 창 안, 냉각판 아랫면 접촉). 가는 2점 쇄선: 셀 (가상선).
구역 = 셀 1개, 2열 × 12 = 24 구역. 코일 130×22 레이스트랙, 창 118×10 (가정).
상세 F (5:1, X=48 단면)
1
1.5
2
4
5
위부터: 접착층 1 / 냉각판 윗벽 1.5
유로 1.5 (비움) / 아랫벽 2 (주 가열)
비금속 상판 4 / 코일 4 / 페라이트 5
(모두 가정)
필링 자세 (2°, 1:2)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
