hwan94877103-cloud/Re-Cell/drawings/dxf/D-02_R03_2of3.dxf

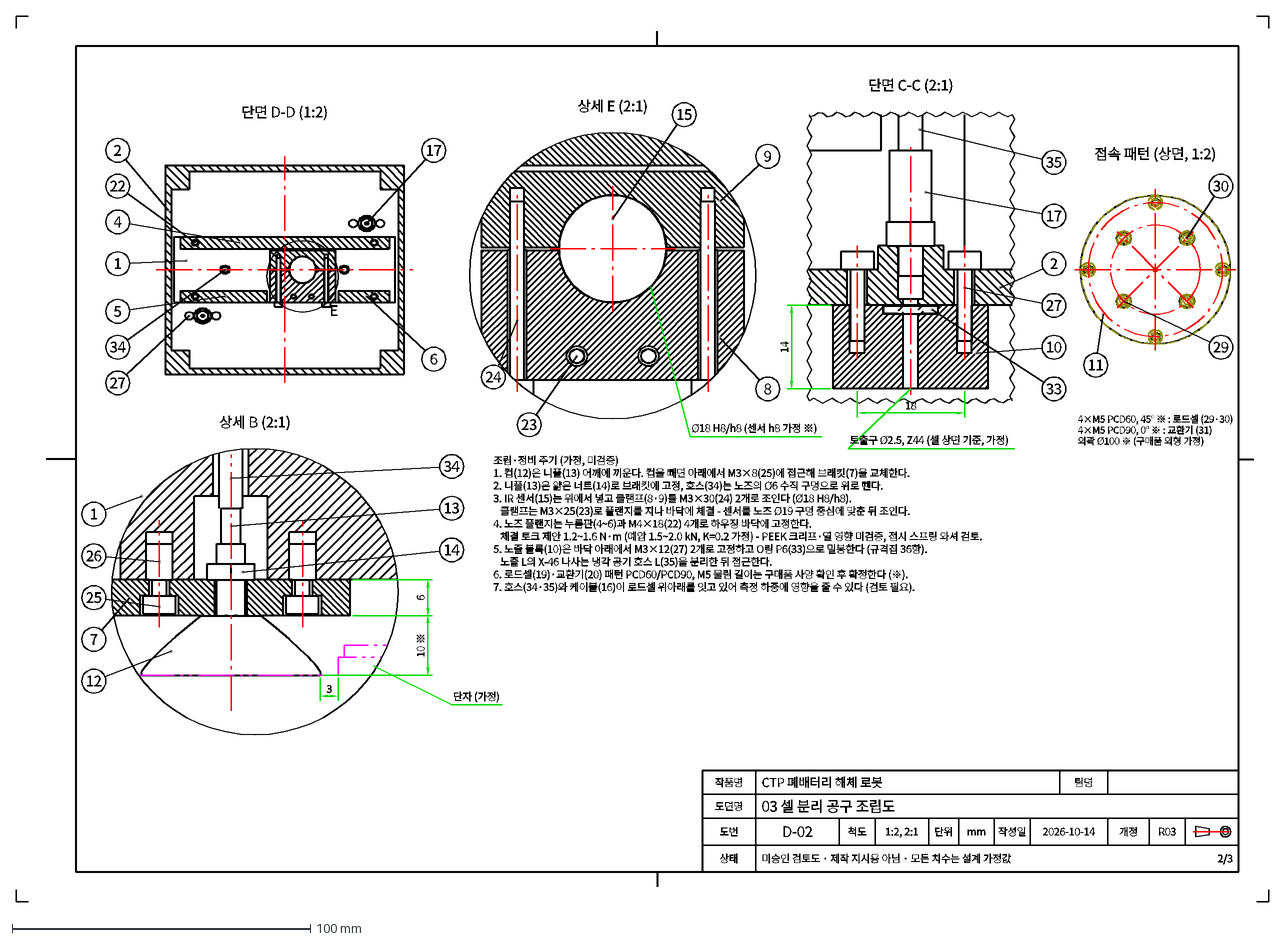
[picture p41: CAD file, 2026-10-16]
drawings/dxf/D-02_R03_2of3.dxf
작품명
CTP 폐배터리 해체 로봇
팀명
도면명
03 셀 분리 공구 조립도
도번
D-02
척도
1:2, 2:1
단위
mm
작성일
2026-10-14
개정
R03
상태
미승인 검토도 · 제작 지시용 아님 · 모든 치수는 설계 가정값
2/3
단면 D-D (1:2)
E
2
22
4
1
5
34
27
17
6
상세 E (2:1)
8
9
24
23
15
Ø18 H8/h8 (센서 h8 가정 ※)
단면 C-C (2:1)
14
18
10
35
33
토출구 Ø2.5, Z44 (셀 상면 기준, 가정)
접속 패턴 (상면, 1:2)
11
30
29
4×M5 PCD60, 45° ※ : 로드셀 (29·30)
4×M5 PCD90, 0° ※ : 교환기 (31)
외곽 Ø100 ※ (구매품 외형 가정)
상세 B (2:1)
10 ※
3
단자 (가정)
12
7
25
26
13
조립·정비 주기 (가정, 미검증)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
