hwan94877103-cloud/Re-Cell/drawings/dxf/D-02_R03_1of3.dxf

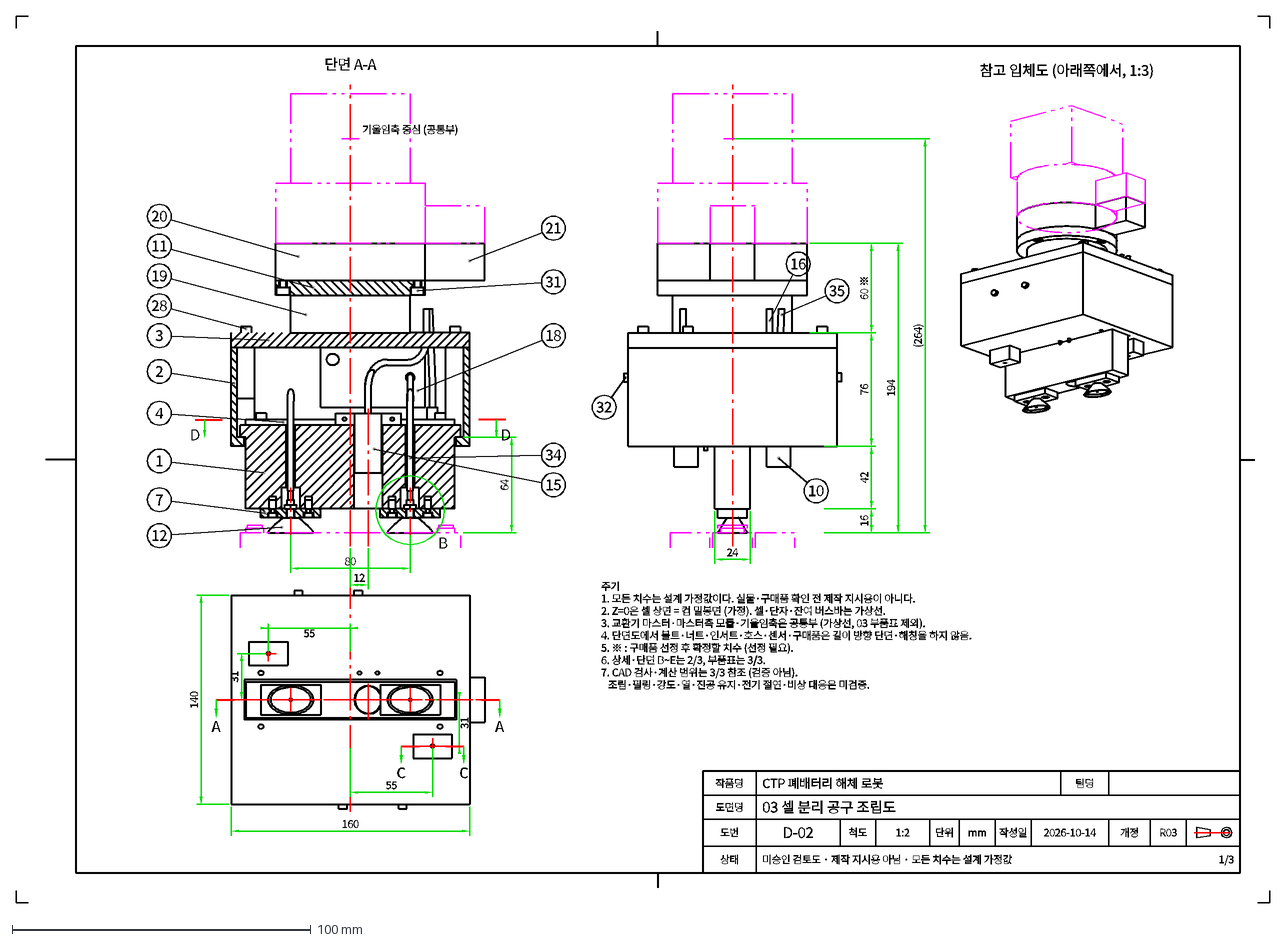
[picture p42: CAD file, 2026-10-16]
drawings/dxf/D-02_R03_1of3.dxf
작품명
CTP 폐배터리 해체 로봇
팀명
도면명
03 셀 분리 공구 조립도
도번
D-02
척도
1:2
단위
mm
작성일
2026-10-14
개정
R03
상태
미승인 검토도 · 제작 지시용 아님 · 모든 치수는 설계 가정값
1/3
기울임축 중심 (공통부)
단면 A-A
80
12
64
B
D
20
11
19
28
3
2
4
1
7
21
31
18
34
15
16
42
76
60 ※
194
(264)
24
10
32
35
160
140
55
A
C
참고 입체도 (아래쪽에서, 1:3)
주기
1. 모든 치수는 설계 가정값이다. 실물·구매품 확인 전 제작 지시용이 아니다.
2. Z=0은 셀 상면 = 컵 밀봉면 (가정). 셀·단자·잔여 버스바는 가상선.
3. 교환기 마스터·마스터측 모듈·기울임축은 공통부 (가상선, 03 부품표 제외).
4. 단면도에서 볼트·너트·인서트·호스·센서·구매품은 길이 방향 단면·해칭을 하지 않음.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
