hwan94877103-cloud/Re-Cell/drawings/dxf/D-04_R03_1of5.dxf

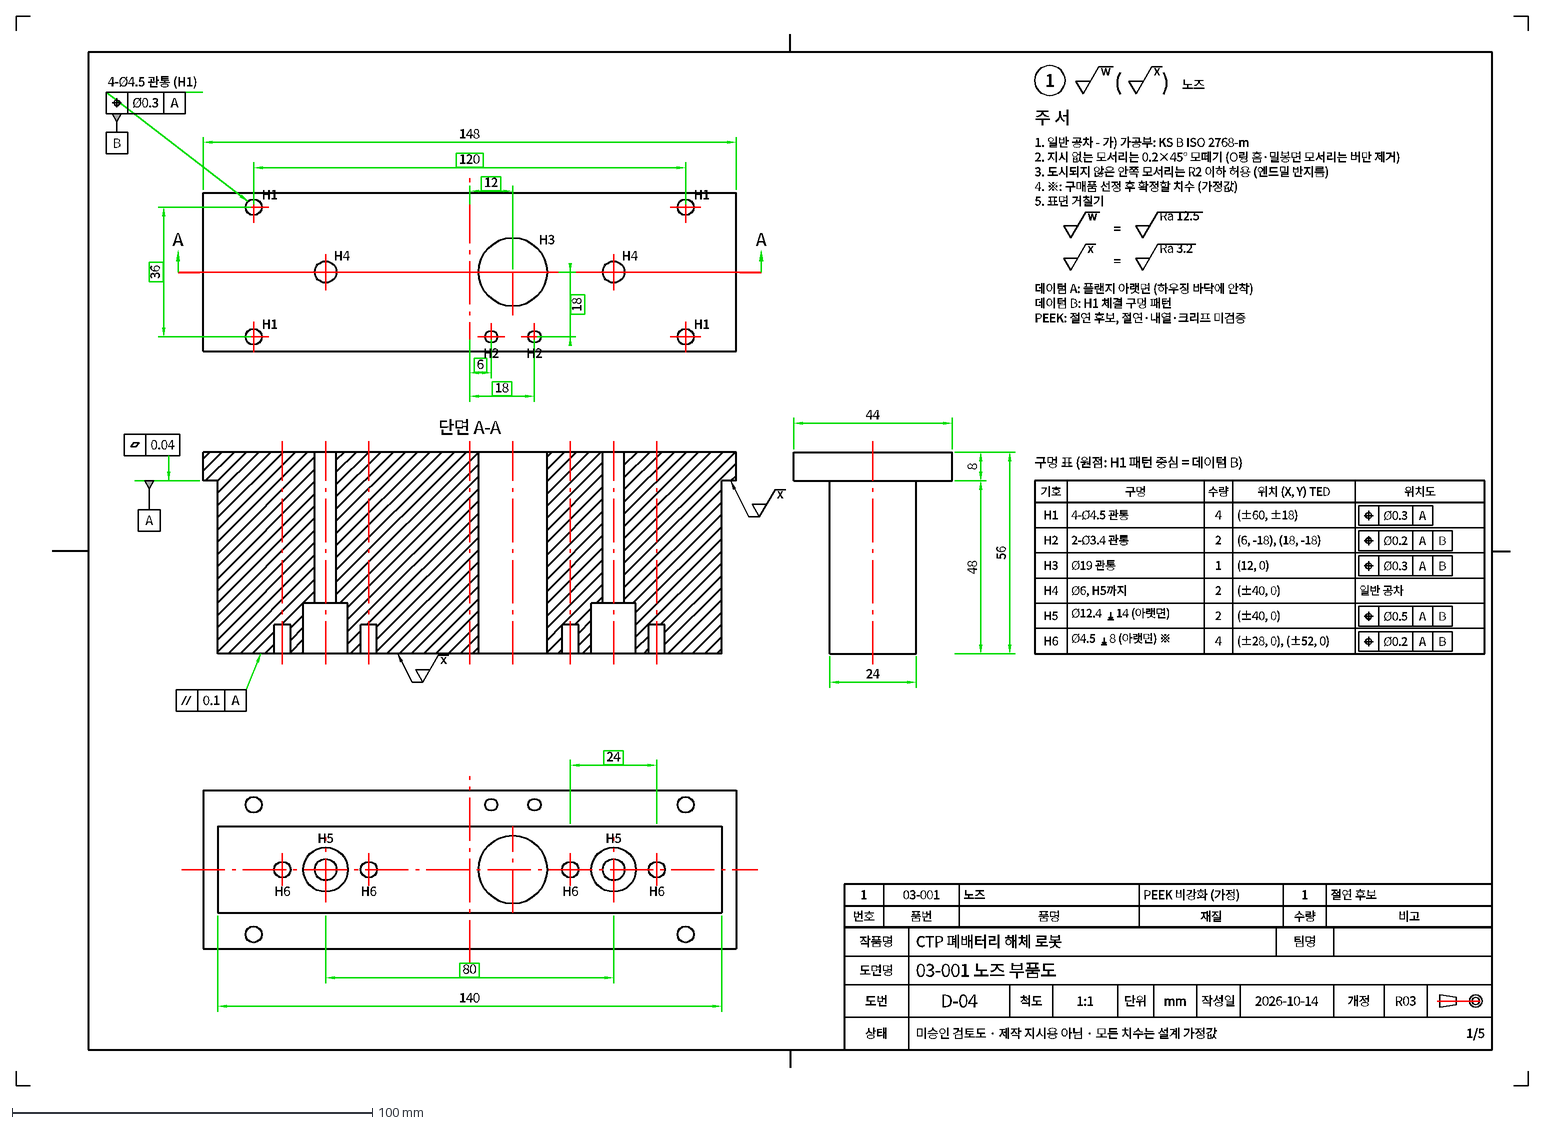
[picture p43: CAD file, 2026-10-16]
drawings/dxf/D-04_R03_1of5.dxf
작품명
CTP 폐배터리 해체 로봇
팀명
도면명
03-001 노즈 부품도
도번
D-04
척도
1:1
단위
mm
작성일
2026-10-14
개정
R03
상태
미승인 검토도 · 제작 지시용 아님 · 모든 치수는 설계 가정값
1/5
A
단면 A-A
148
120
12
36
6
18
140
80
24
44
48
8
56
H1
H2
H3
H4
H5
H6
0.04
x
4-Ø4.5 관통 (H1)
Ø0.3
B
0.1
구멍 표 (원점: H1 패턴 중심 = 데이텀 B)
기호
구멍
수량
위치 (X, Y) TED
위치도
4-Ø4.5 관통
4
(±60, ±18)
2-Ø3.4 관통
2
(6, -18), (18, -18)
Ø19 관통
1
(12, 0)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
