hwan94877103-cloud/Re-Cell/drawings/dxf/D-01_R03_1of1.dxf

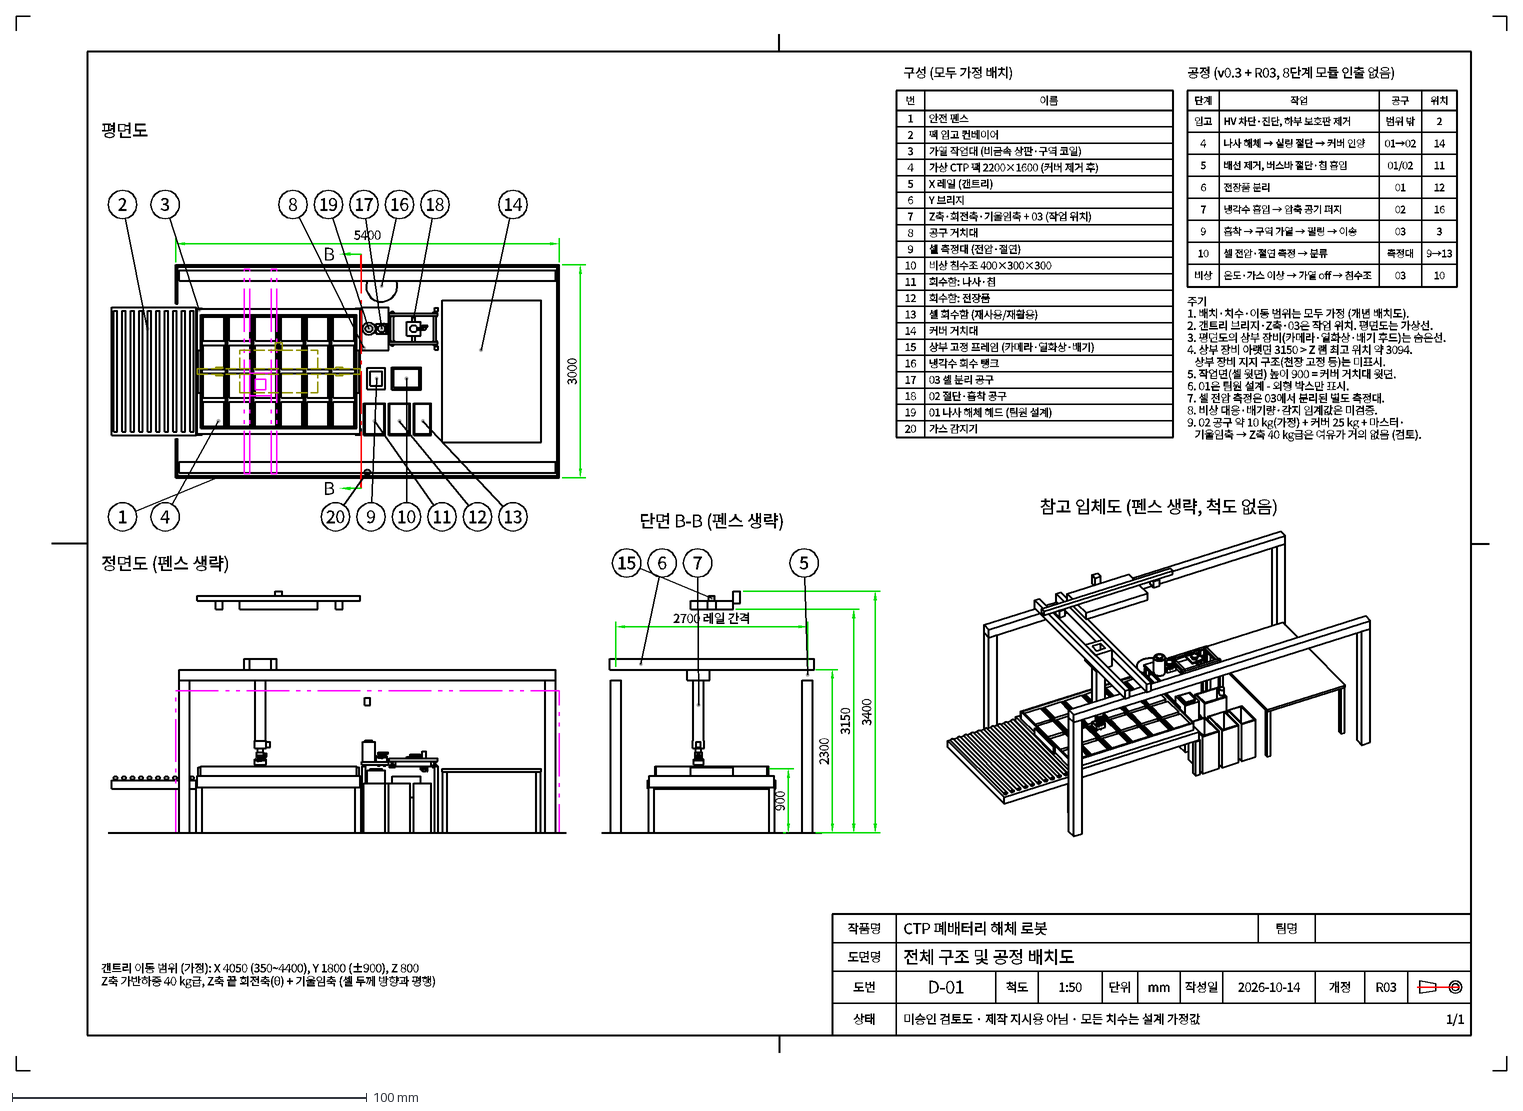
[picture p44: CAD file, 2026-10-16]
drawings/dxf/D-01_R03_1of1.dxf
작품명
CTP 폐배터리 해체 로봇
팀명
도면명
전체 구조 및 공정 배치도
도번
D-01
척도
1:50
단위
mm
작성일
2026-10-14
개정
R03
상태
미승인 검토도 · 제작 지시용 아님 · 모든 치수는 설계 가정값
1/1
평면도
정면도 (펜스 생략)
단면 B-B (펜스 생략)
B
5400
3000
900
2300
3150
3400
2700 레일 간격
참고 입체도 (펜스 생략, 척도 없음)
갠트리 이동 범위 (가정): X 4050 (350~4400), Y 1800 (±900), Z 800
Z축 가반하중 40 kg급, Z축 끝 회전축(θ) + 기울임축 (셀 두께 방향과 평행)
2
3
8
19
17
16
18
14
1
4
20
9
10
11
12
13
15
6
7
5
구성 (모두 가정 배치)
번
이름
안전 펜스
팩 입고 컨베이어
가열 작업대 (비금속 상판·구역 코일)
가상 CTP 팩 2200×1600 (커버 제거 후)
X 레일 (갠트리)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
