hwan94877103-cloud/Re-Cell/drawings/dxf/D-03_R03_1of2.dxf

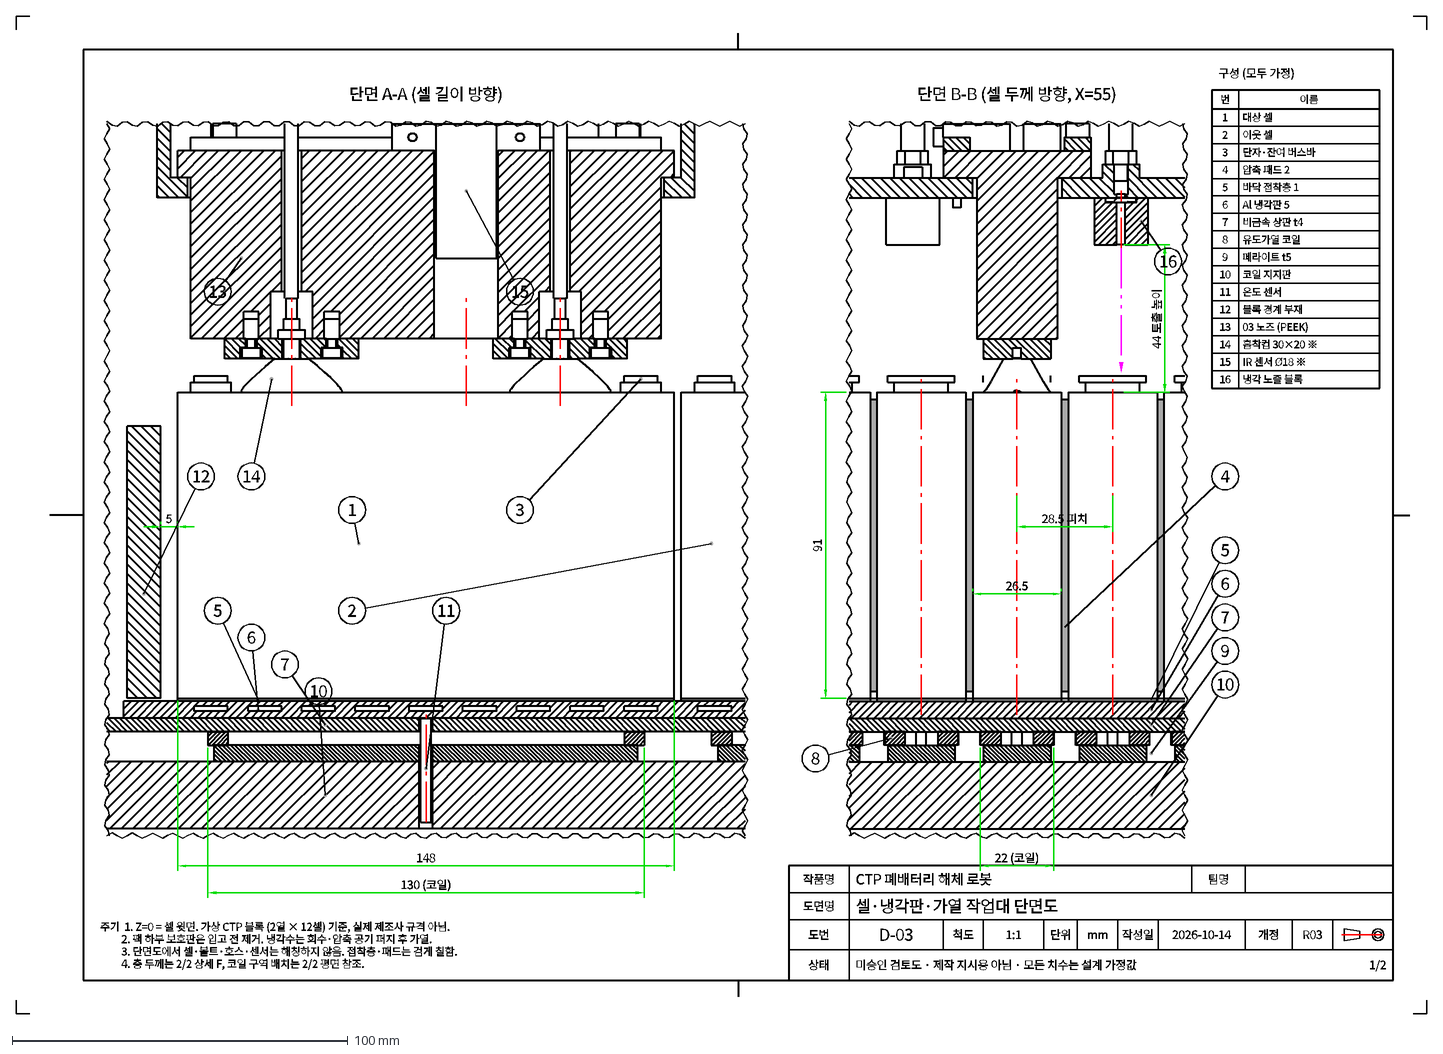
[picture p45: CAD file, 2026-10-16]
drawings/dxf/D-03_R03_1of2.dxf
작품명
CTP 폐배터리 해체 로봇
팀명
도면명
셀·냉각판·가열 작업대 단면도
도번
D-03
척도
1:1
단위
mm
작성일
2026-10-14
개정
R03
상태
미승인 검토도 · 제작 지시용 아님 · 모든 치수는 설계 가정값
1/2
단면 A-A (셀 길이 방향)
148
130 (코일)
5
1
2
3
6
7
10
11
12
13
14
15
단면 B-B (셀 두께 방향, X=55)
26.5
28.5 피치
91
22 (코일)
44 토출 높이
4
8
9
16
구성 (모두 가정)
번
이름
대상 셀
이웃 셀
단자·잔여 버스바
압축 패드 2
바닥 접착층 1
Al 냉각판 5
비금속 상판 t4
유도가열 코일
페라이트 t5
코일 지지판
온도 센서
블록 경계 부재
03 노즈 (PEEK)
흡착컵 30×20 ※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
