hwan94877103-cloud/Re-Cell/(list of files, cad)

Other CAD files:
drawings/dwg/ReCell_POBIG_도면_12장.dwg
3d/LAYOUT_R03_tools_parked.step
drawings/dwg/D-01_R03_1of1.dwg
drawings/dwg/D-02_R03_1of3.dwg
drawings/dwg/D-02_R03_2of3.dwg
drawings/dwg/D-02_R03_3of3.dwg
drawings/dwg/D-03_R03_1of2.dwg
drawings/dwg/D-03_R03_2of2.dwg
drawings/dwg/D-04_R03_1of5.dwg
drawings/dwg/D-04_R03_2of5.dwg
drawings/dwg/D-04_R03_3of5.dwg
drawings/dwg/D-04_R03_4of5.dwg
drawings/dwg/D-04_R03_5of5.dwg
drawings/dwg/D-09_R03_1of1.dwg
