hwan94877103-cloud/Re-Cell/drawings/pdf/CTP_R03_drawings_all_12_sheets.pdf

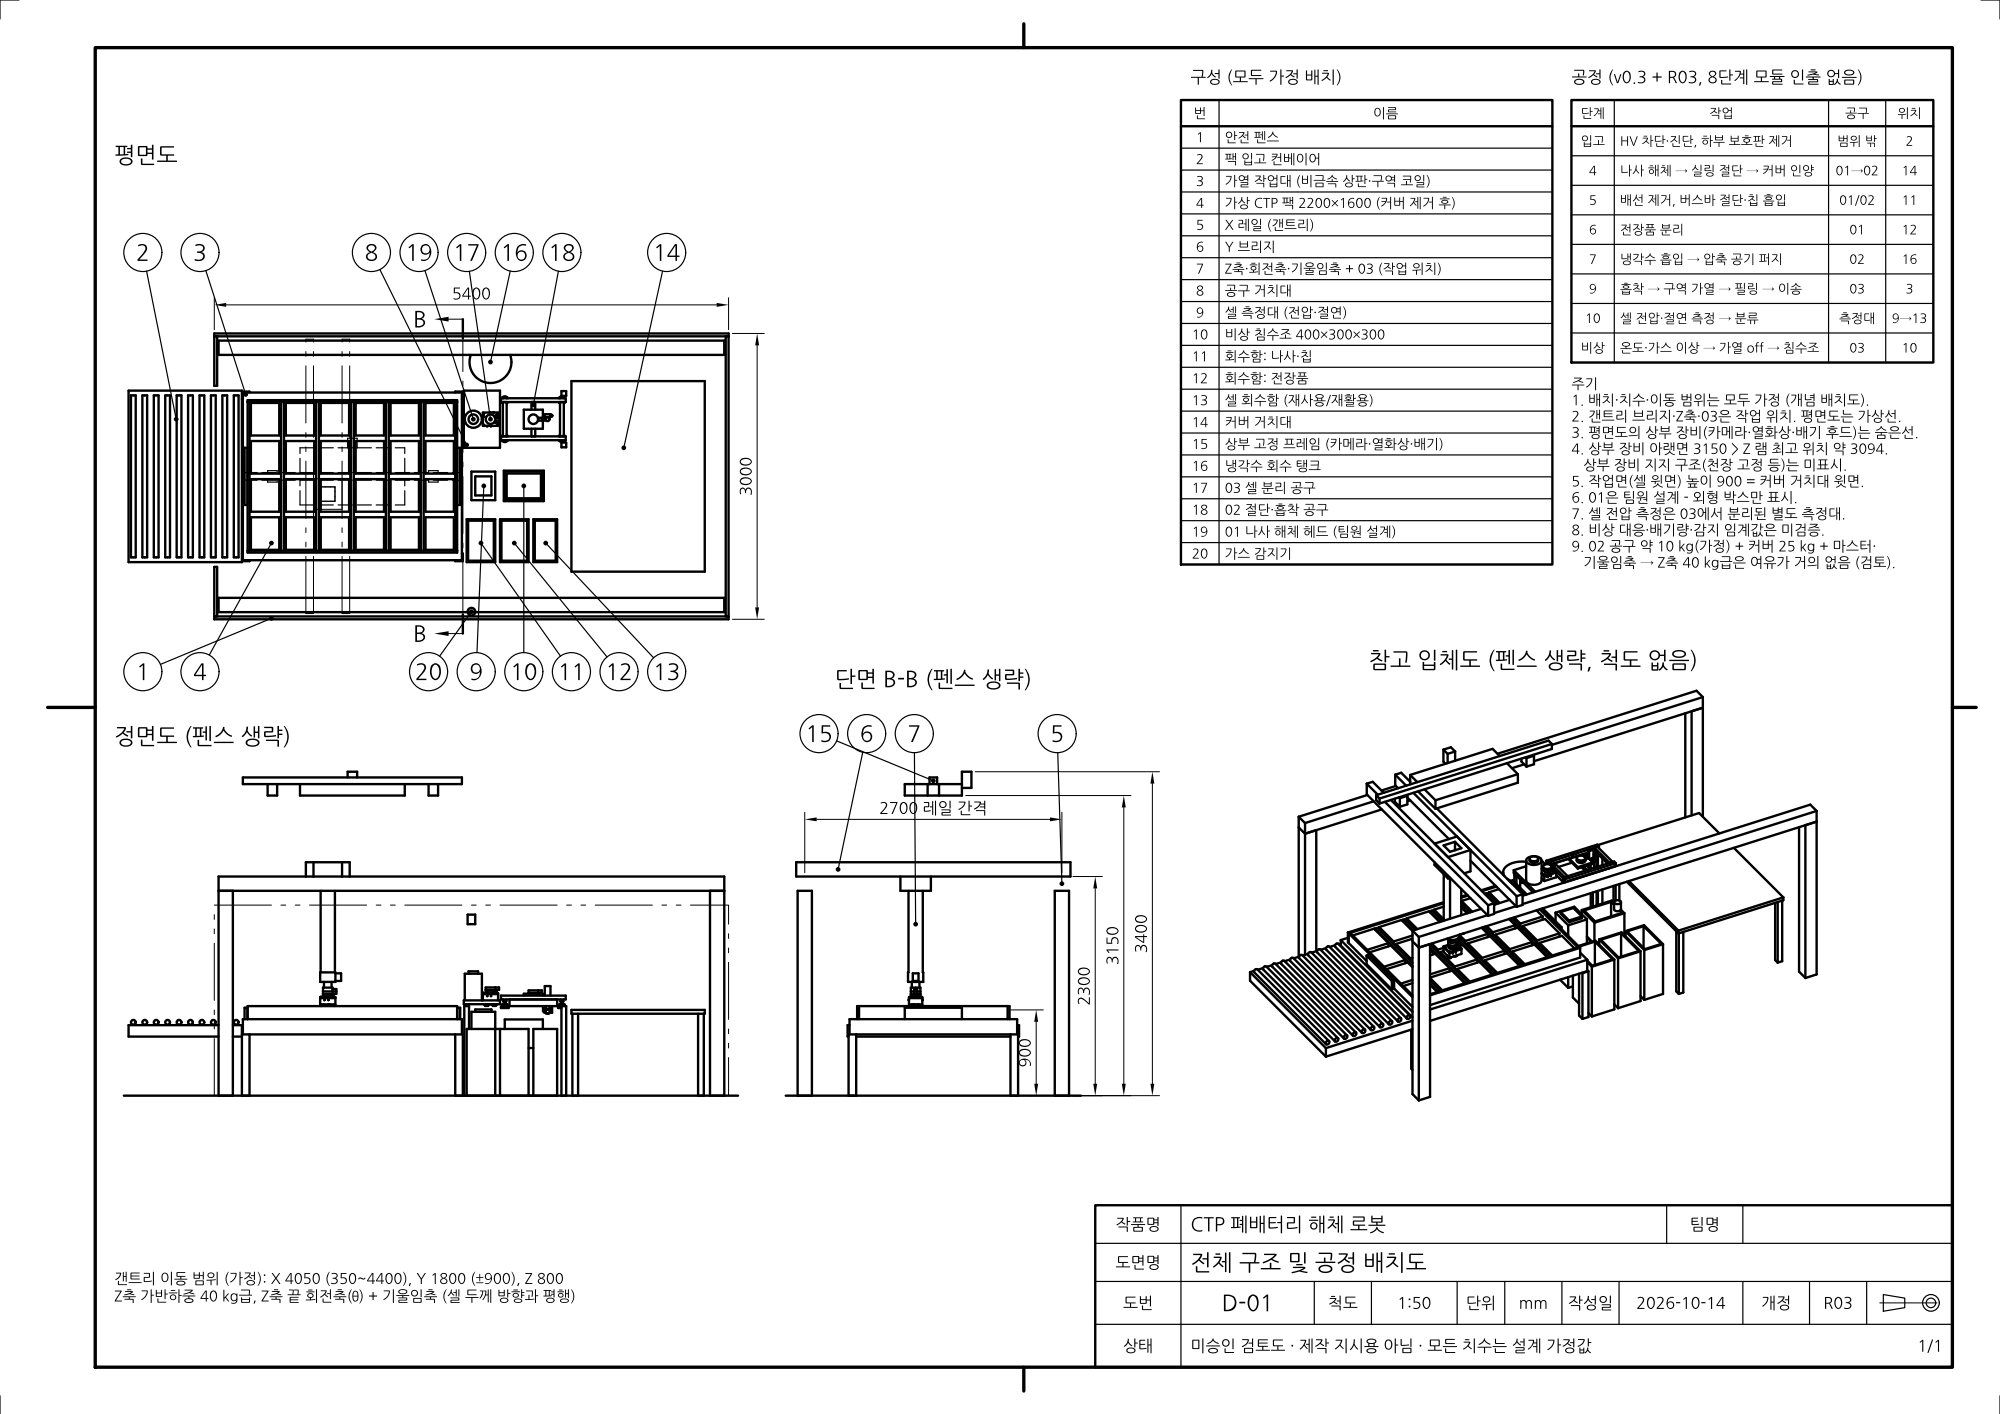
[picture p46: page 1]
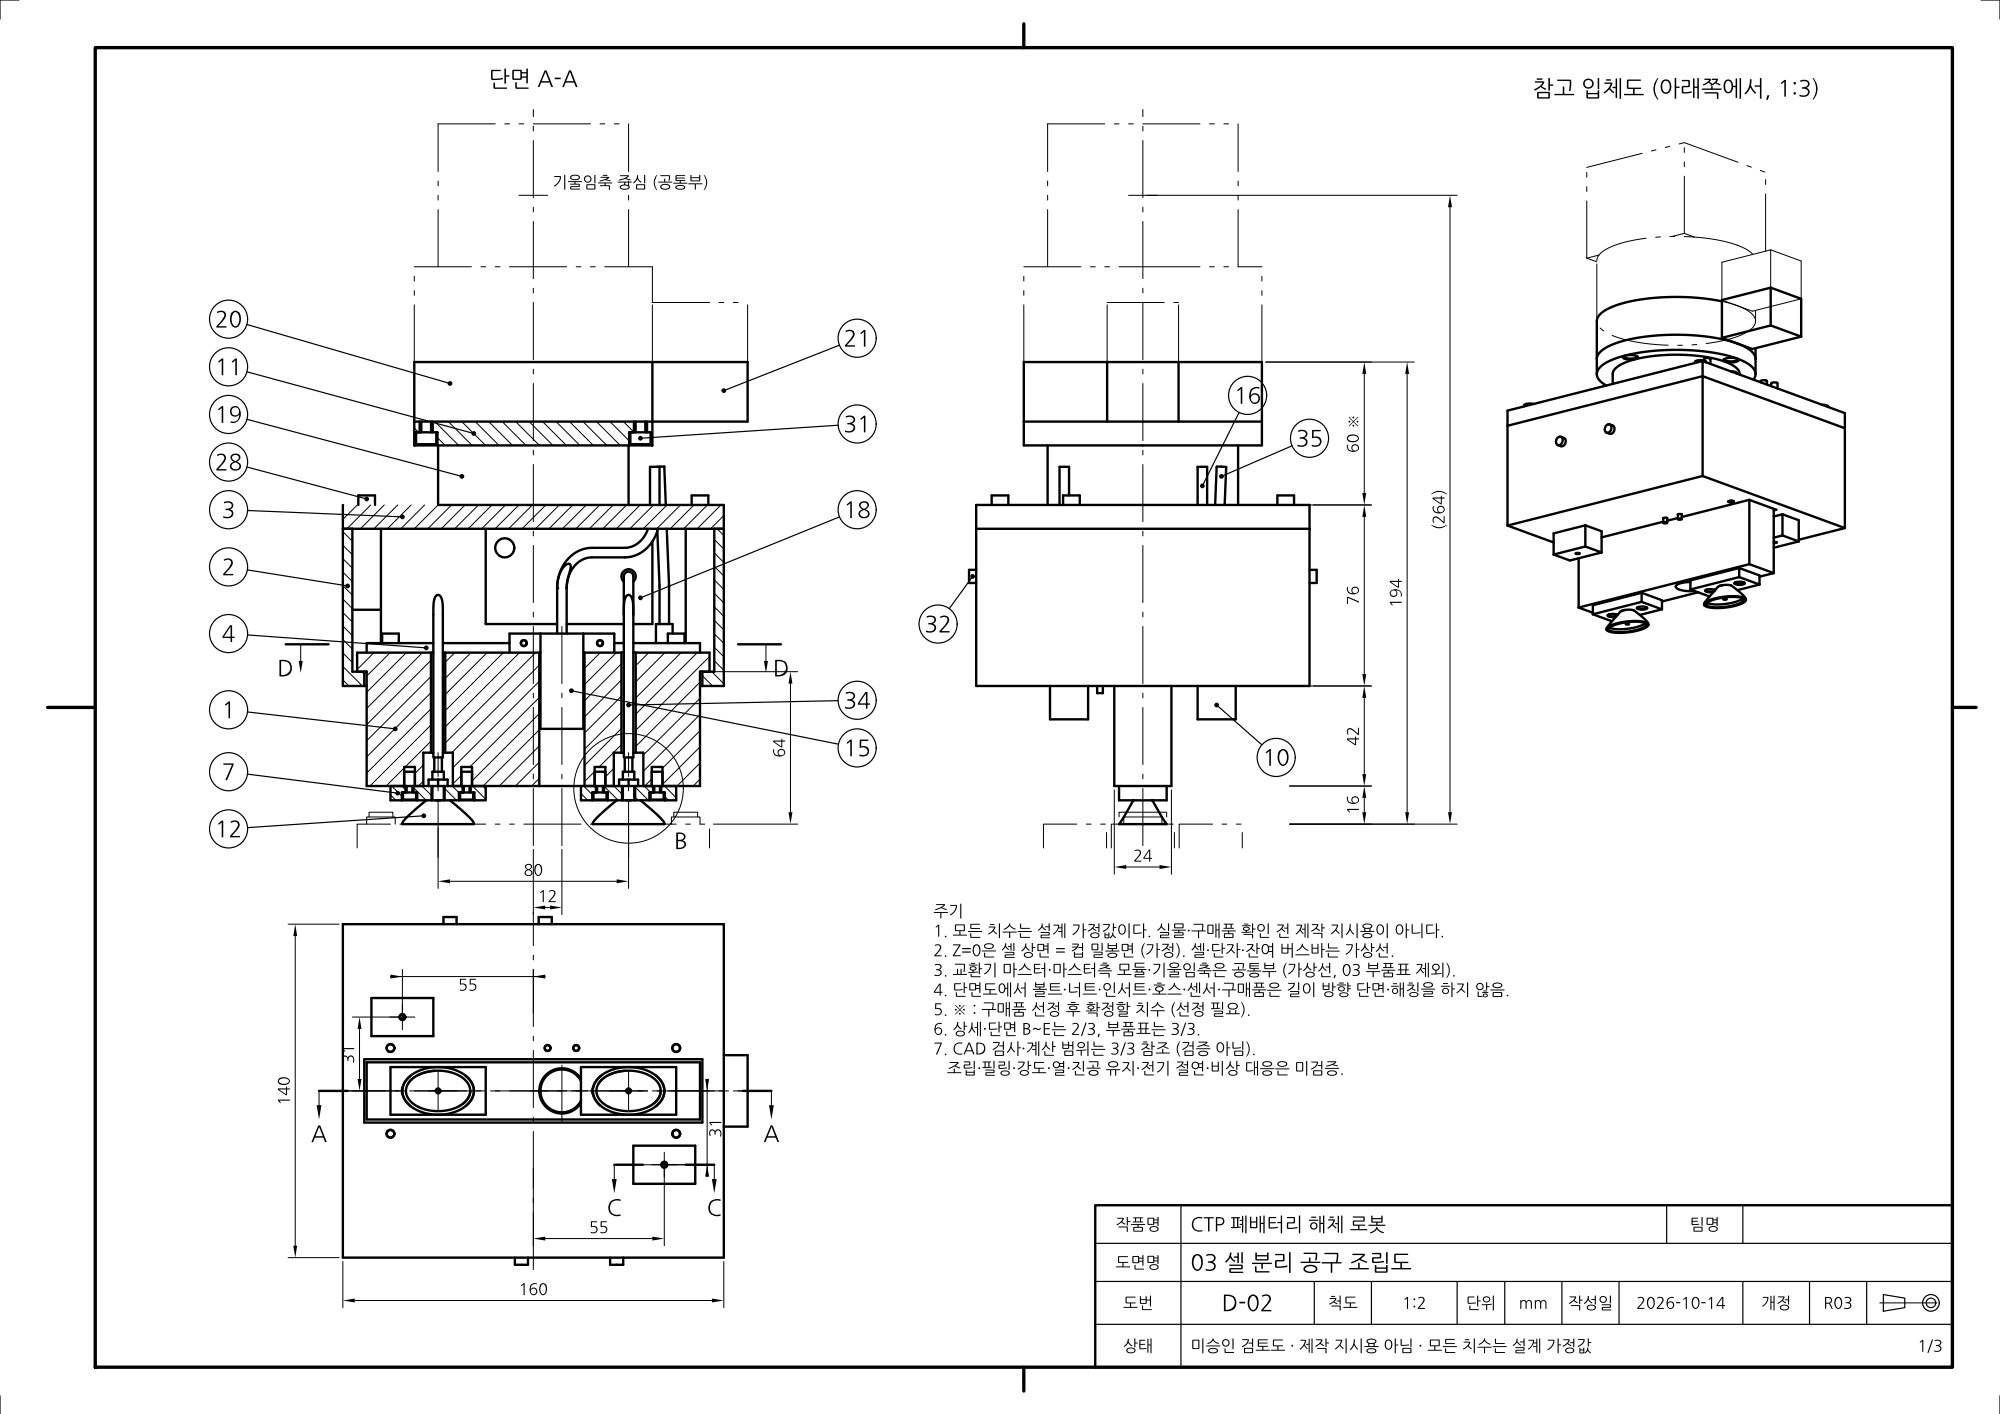
[picture p47: page 2]
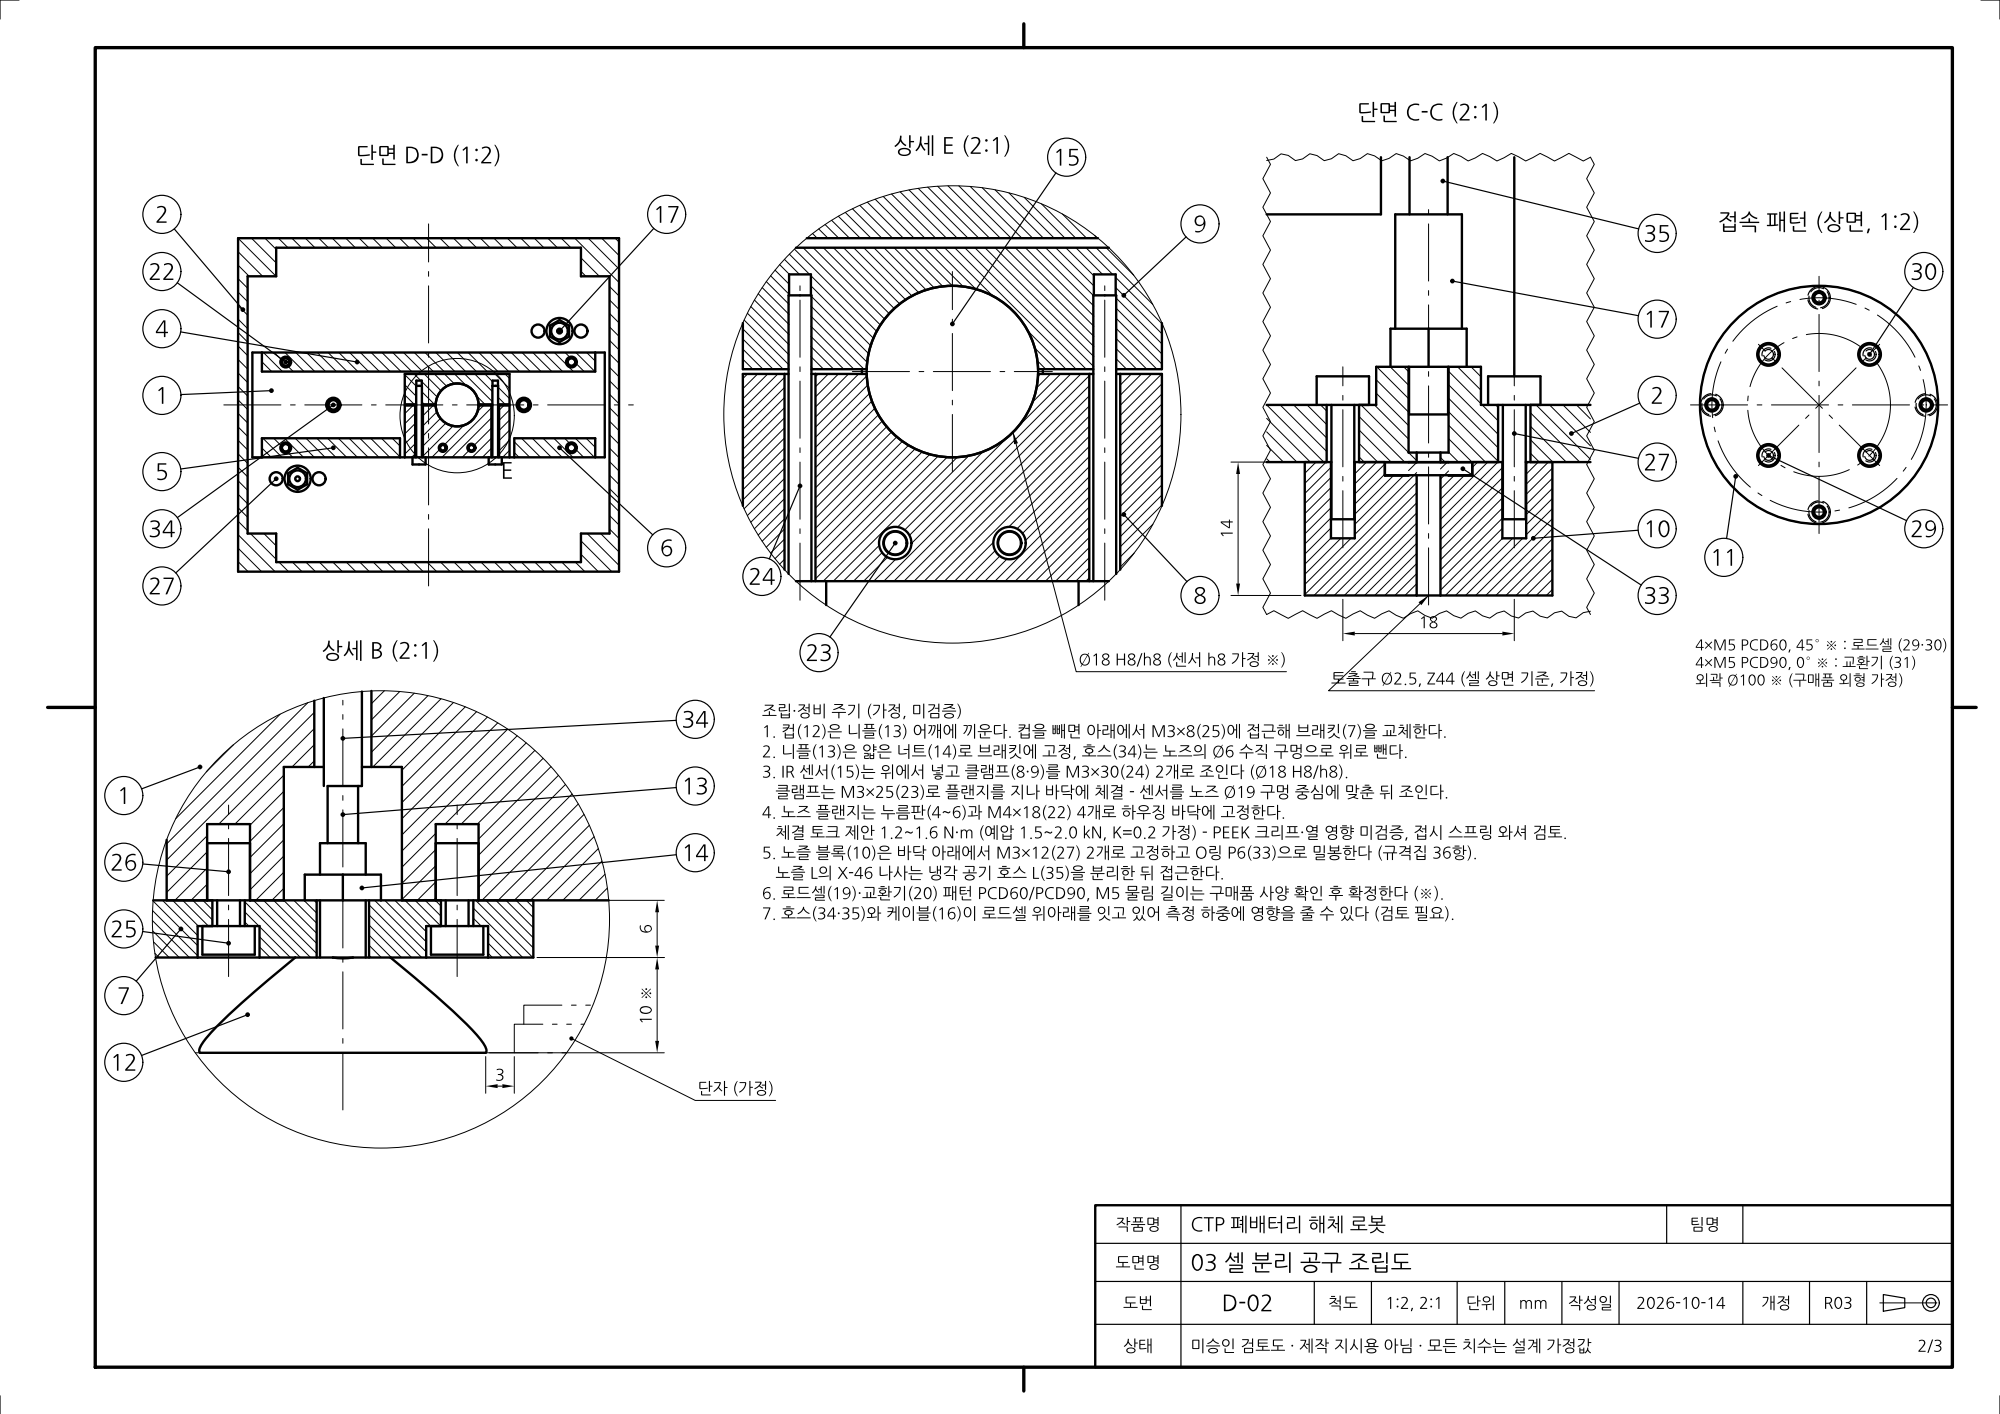
[picture p48: page 3]
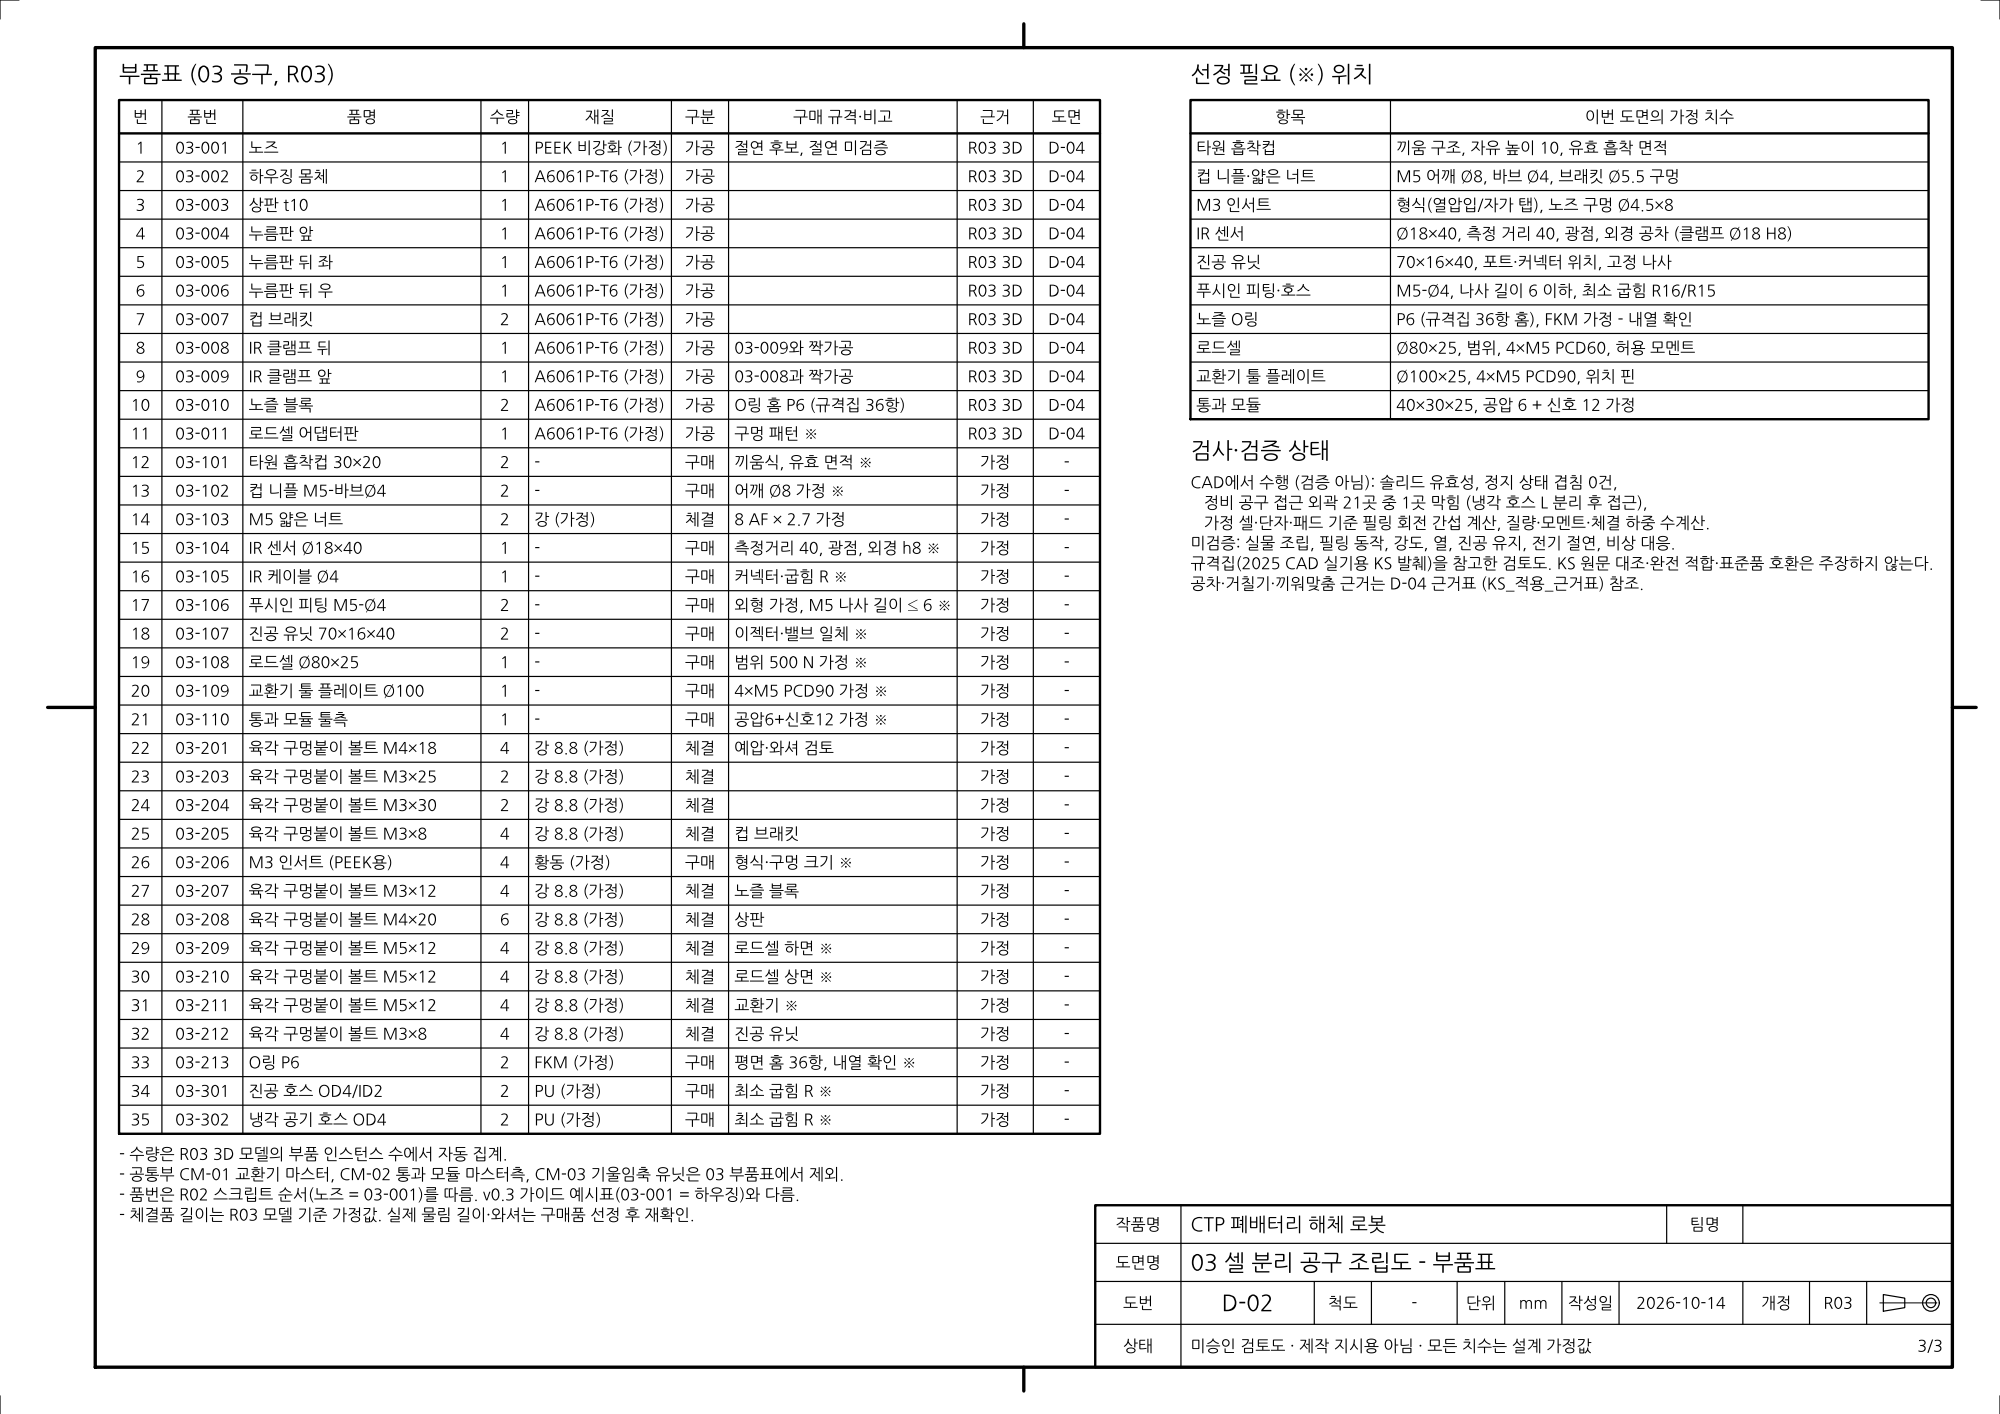
[picture p49: page 4]
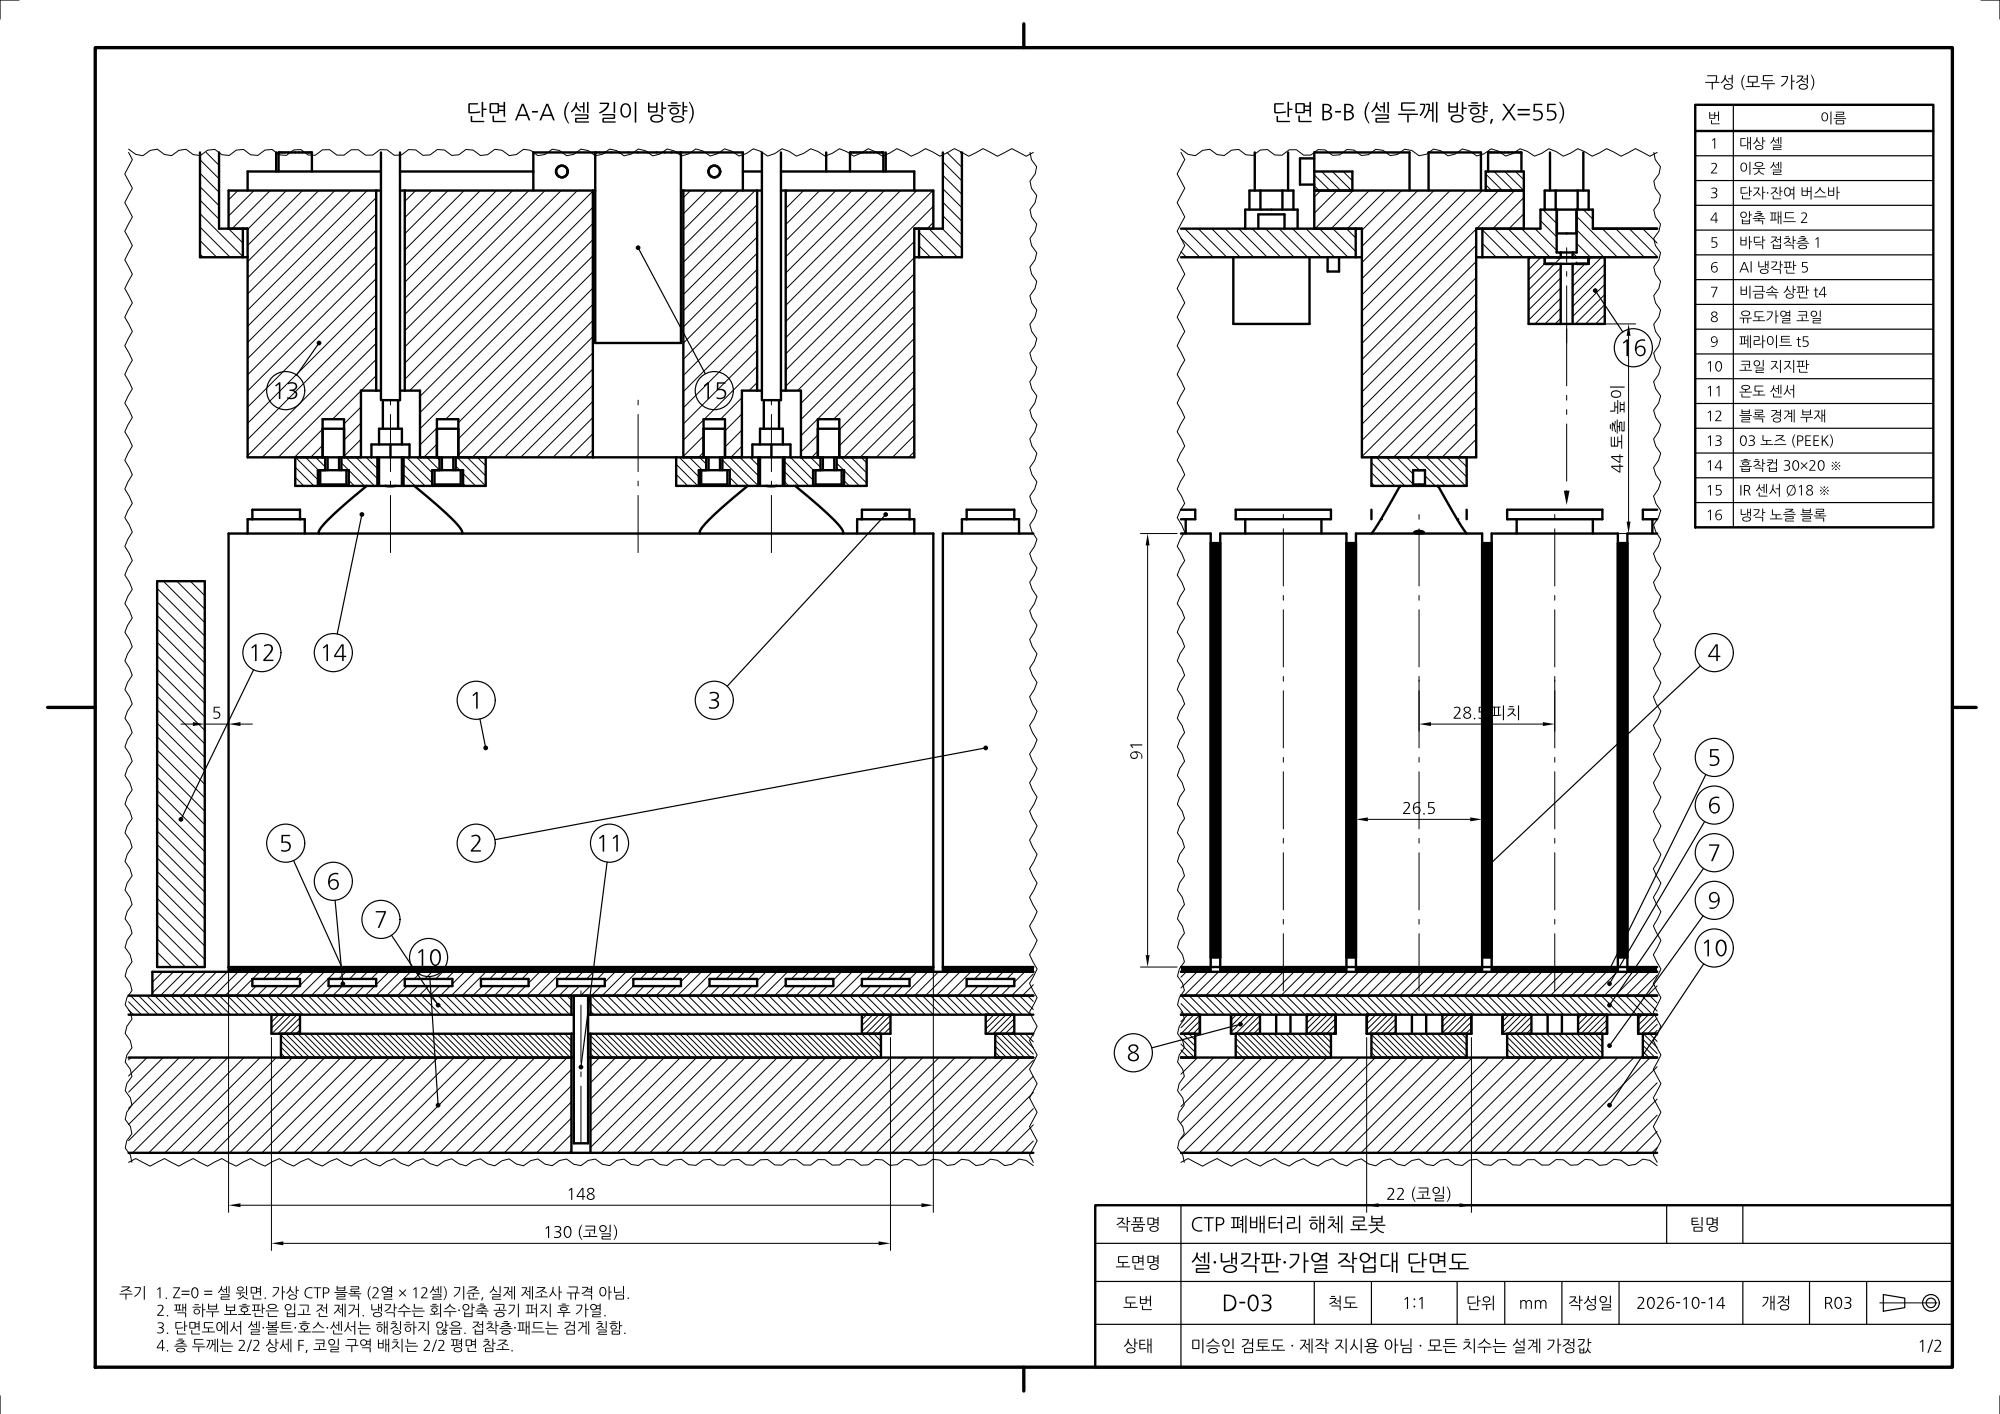
[picture p50: page 5]
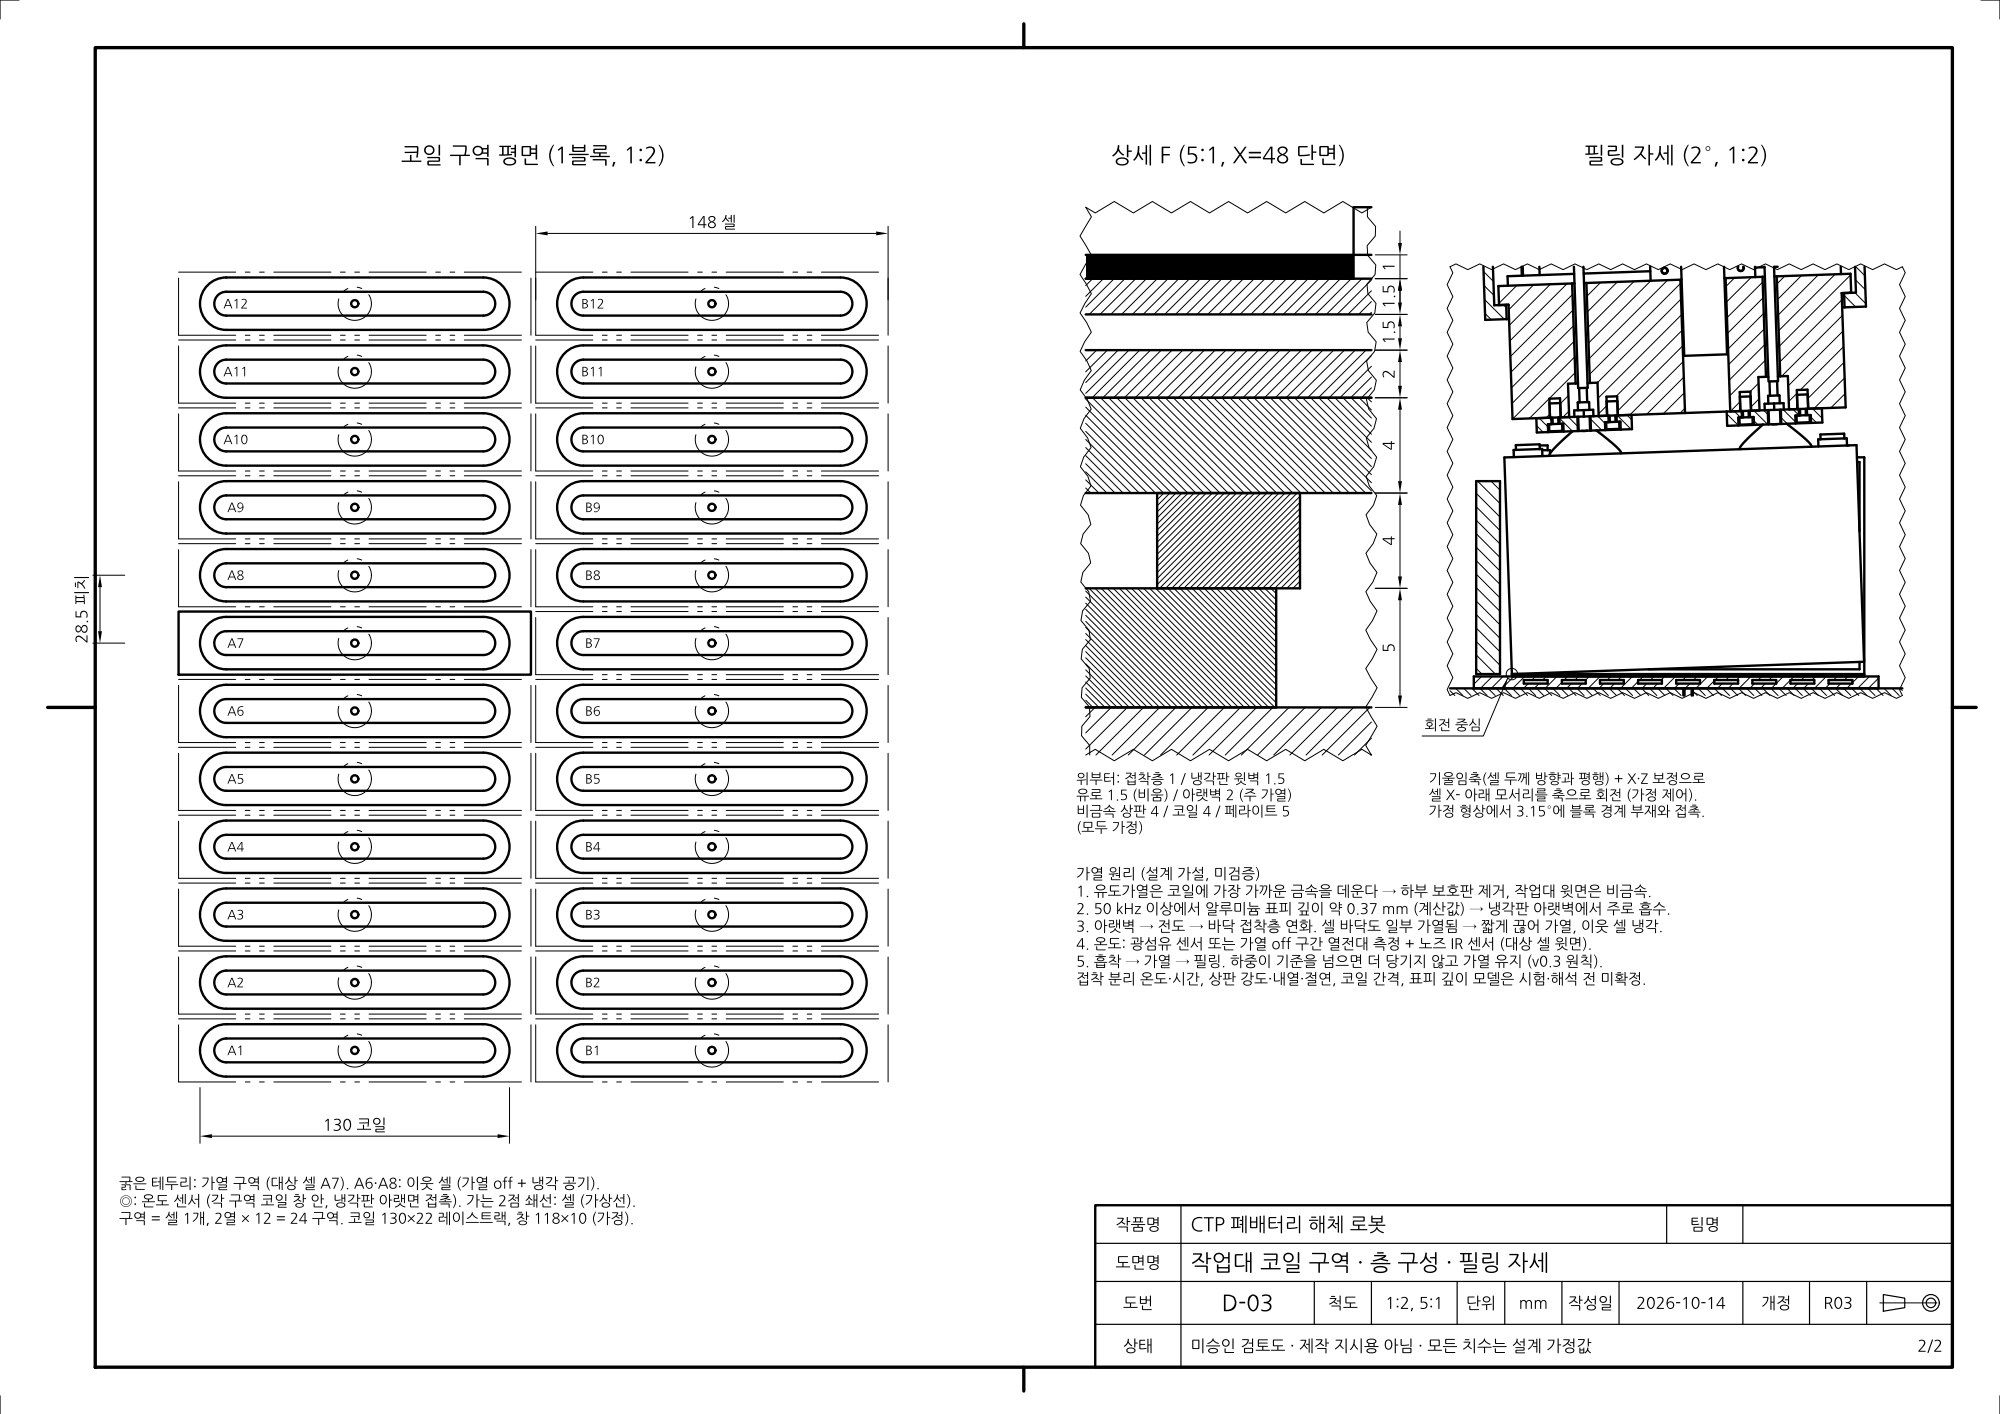
[picture p51: page 6]
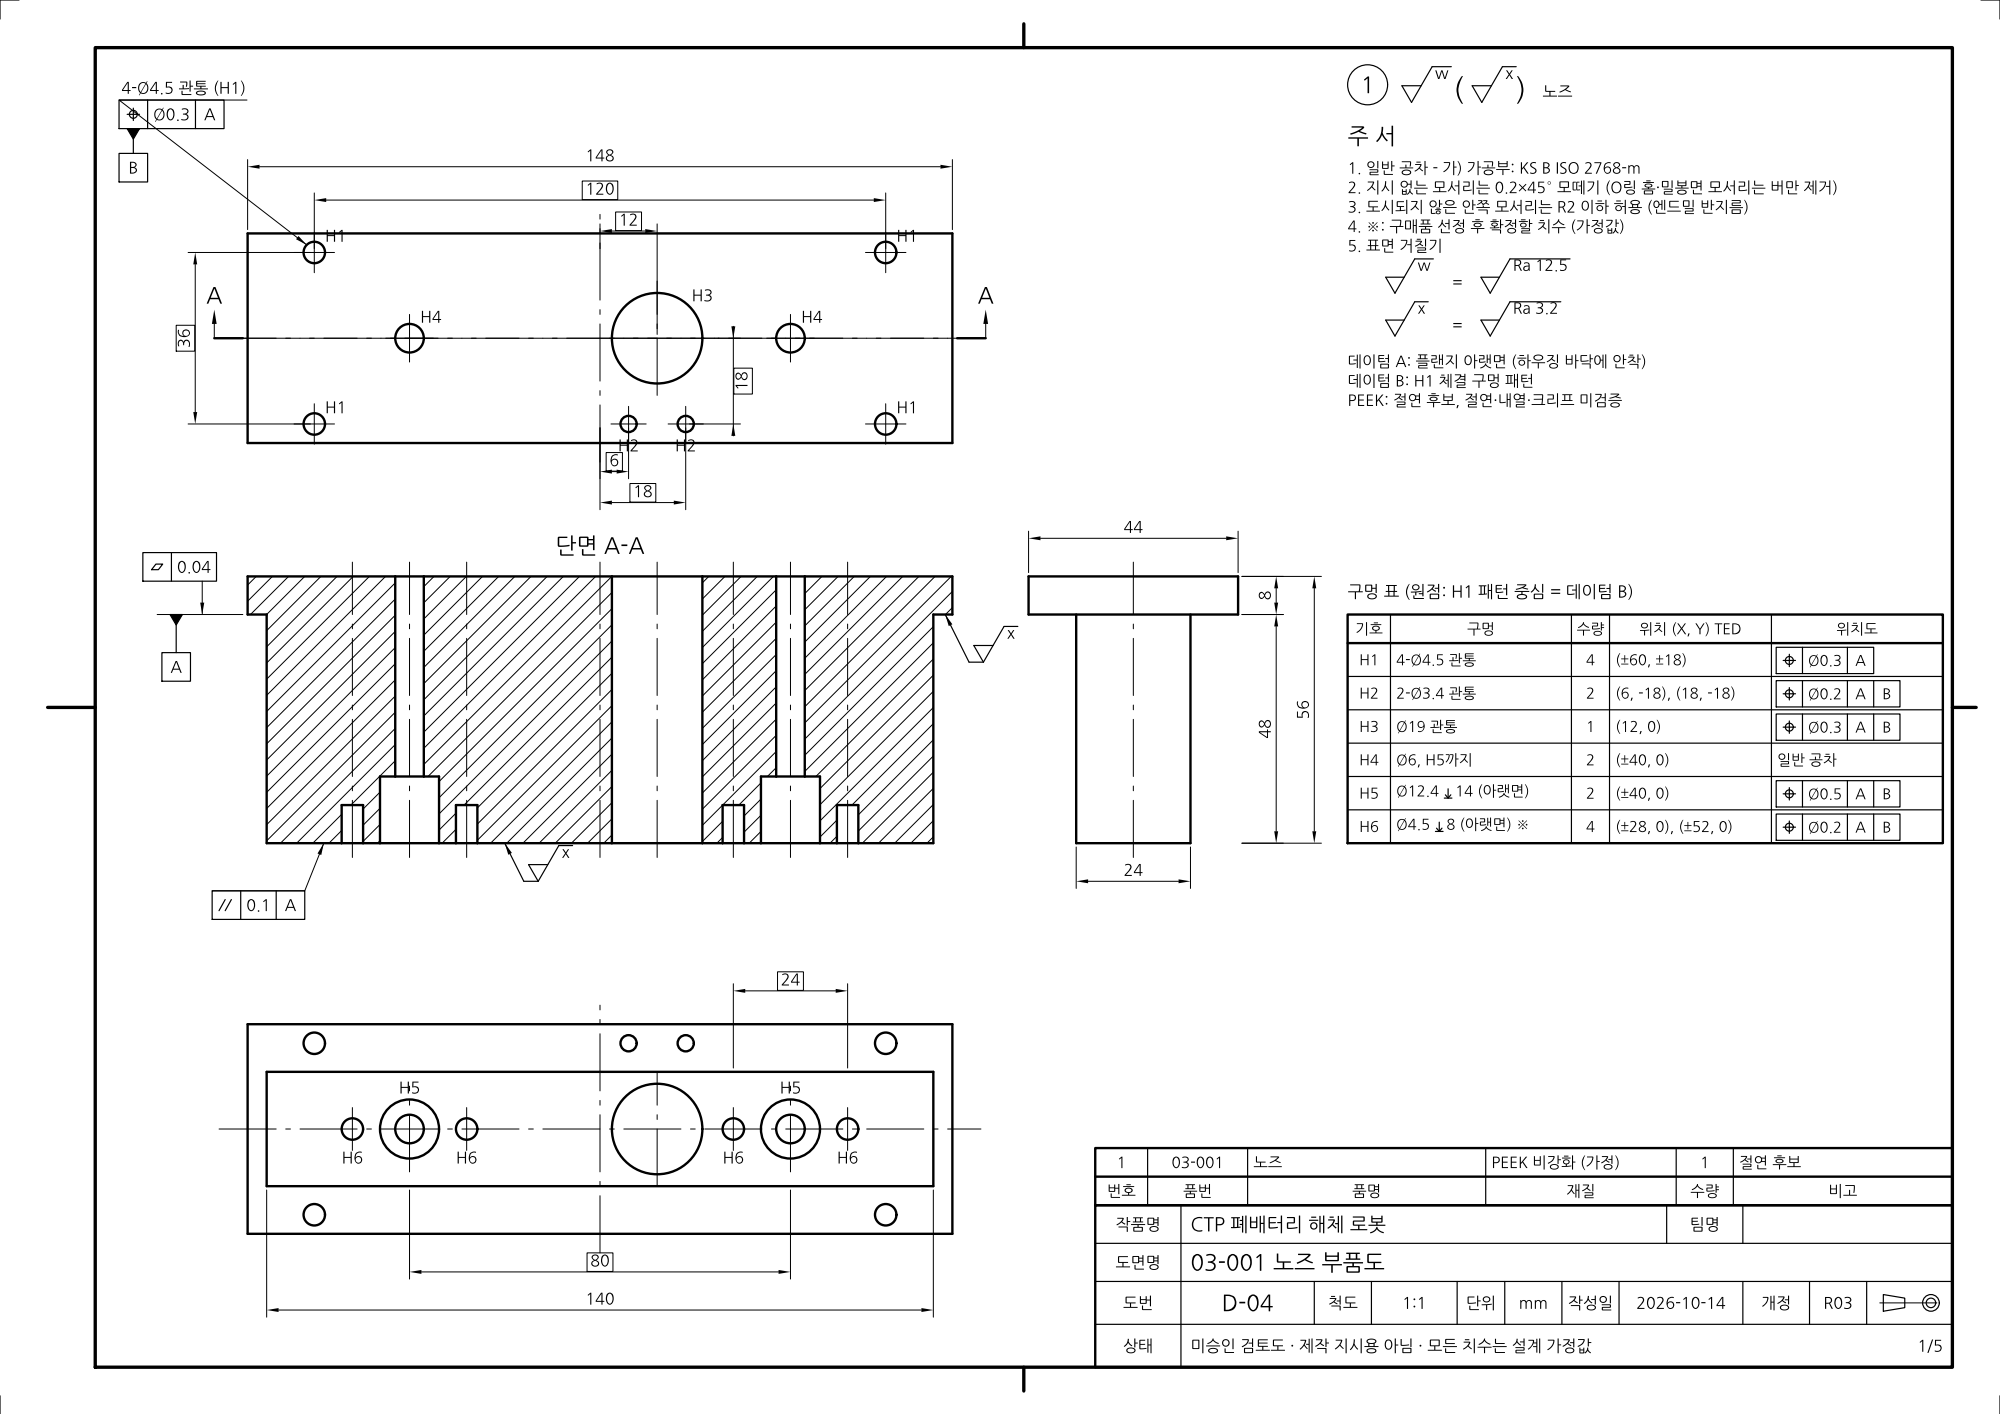
[picture p52: page 7]
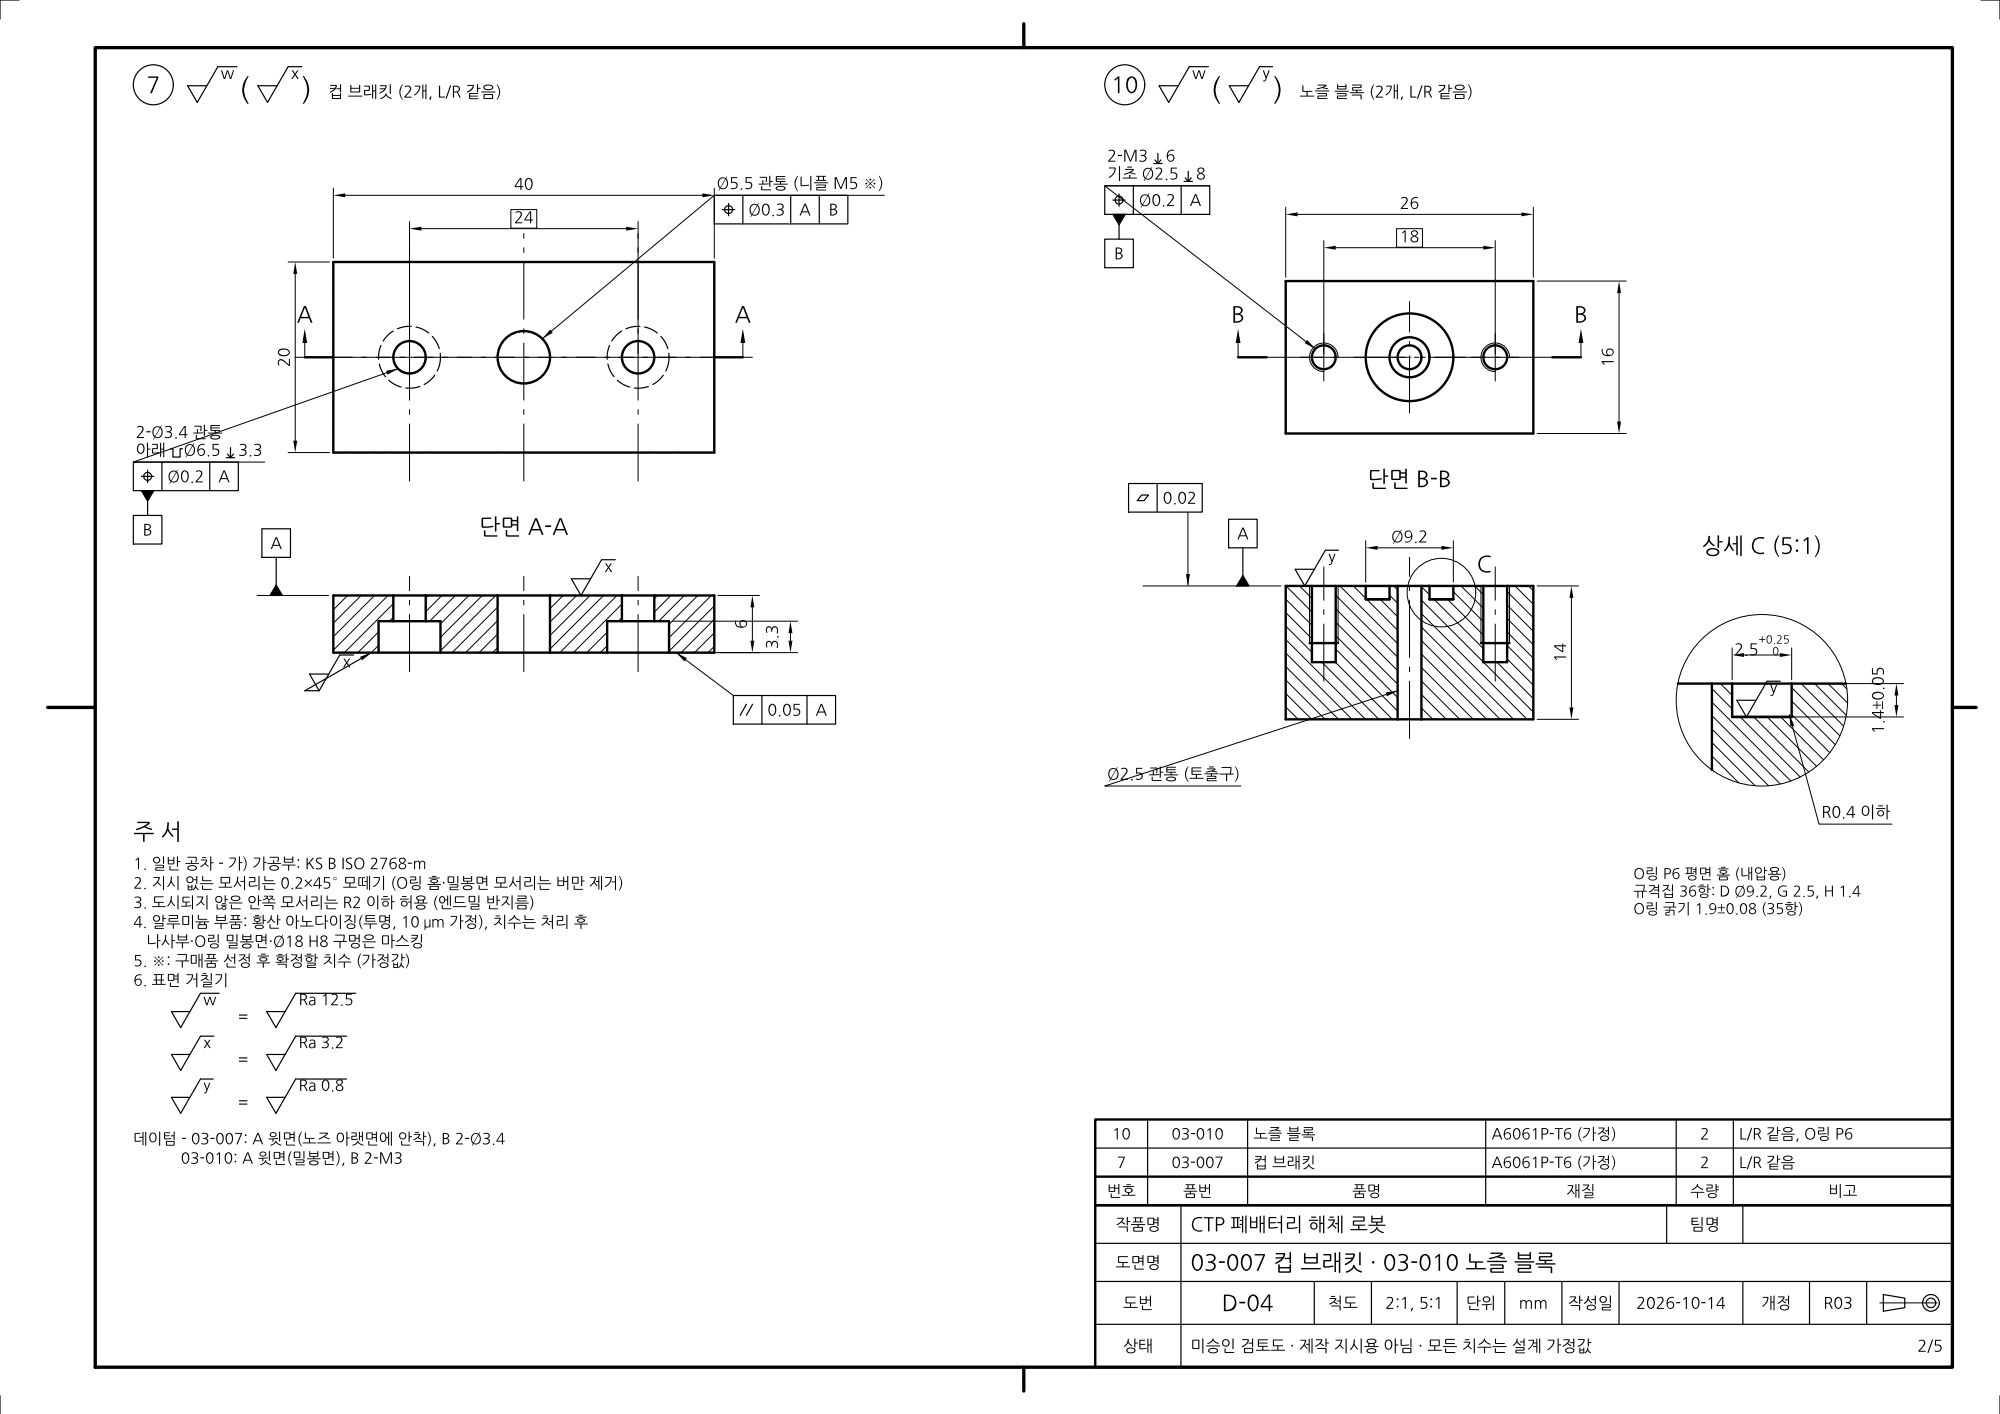
[picture p53: page 8]
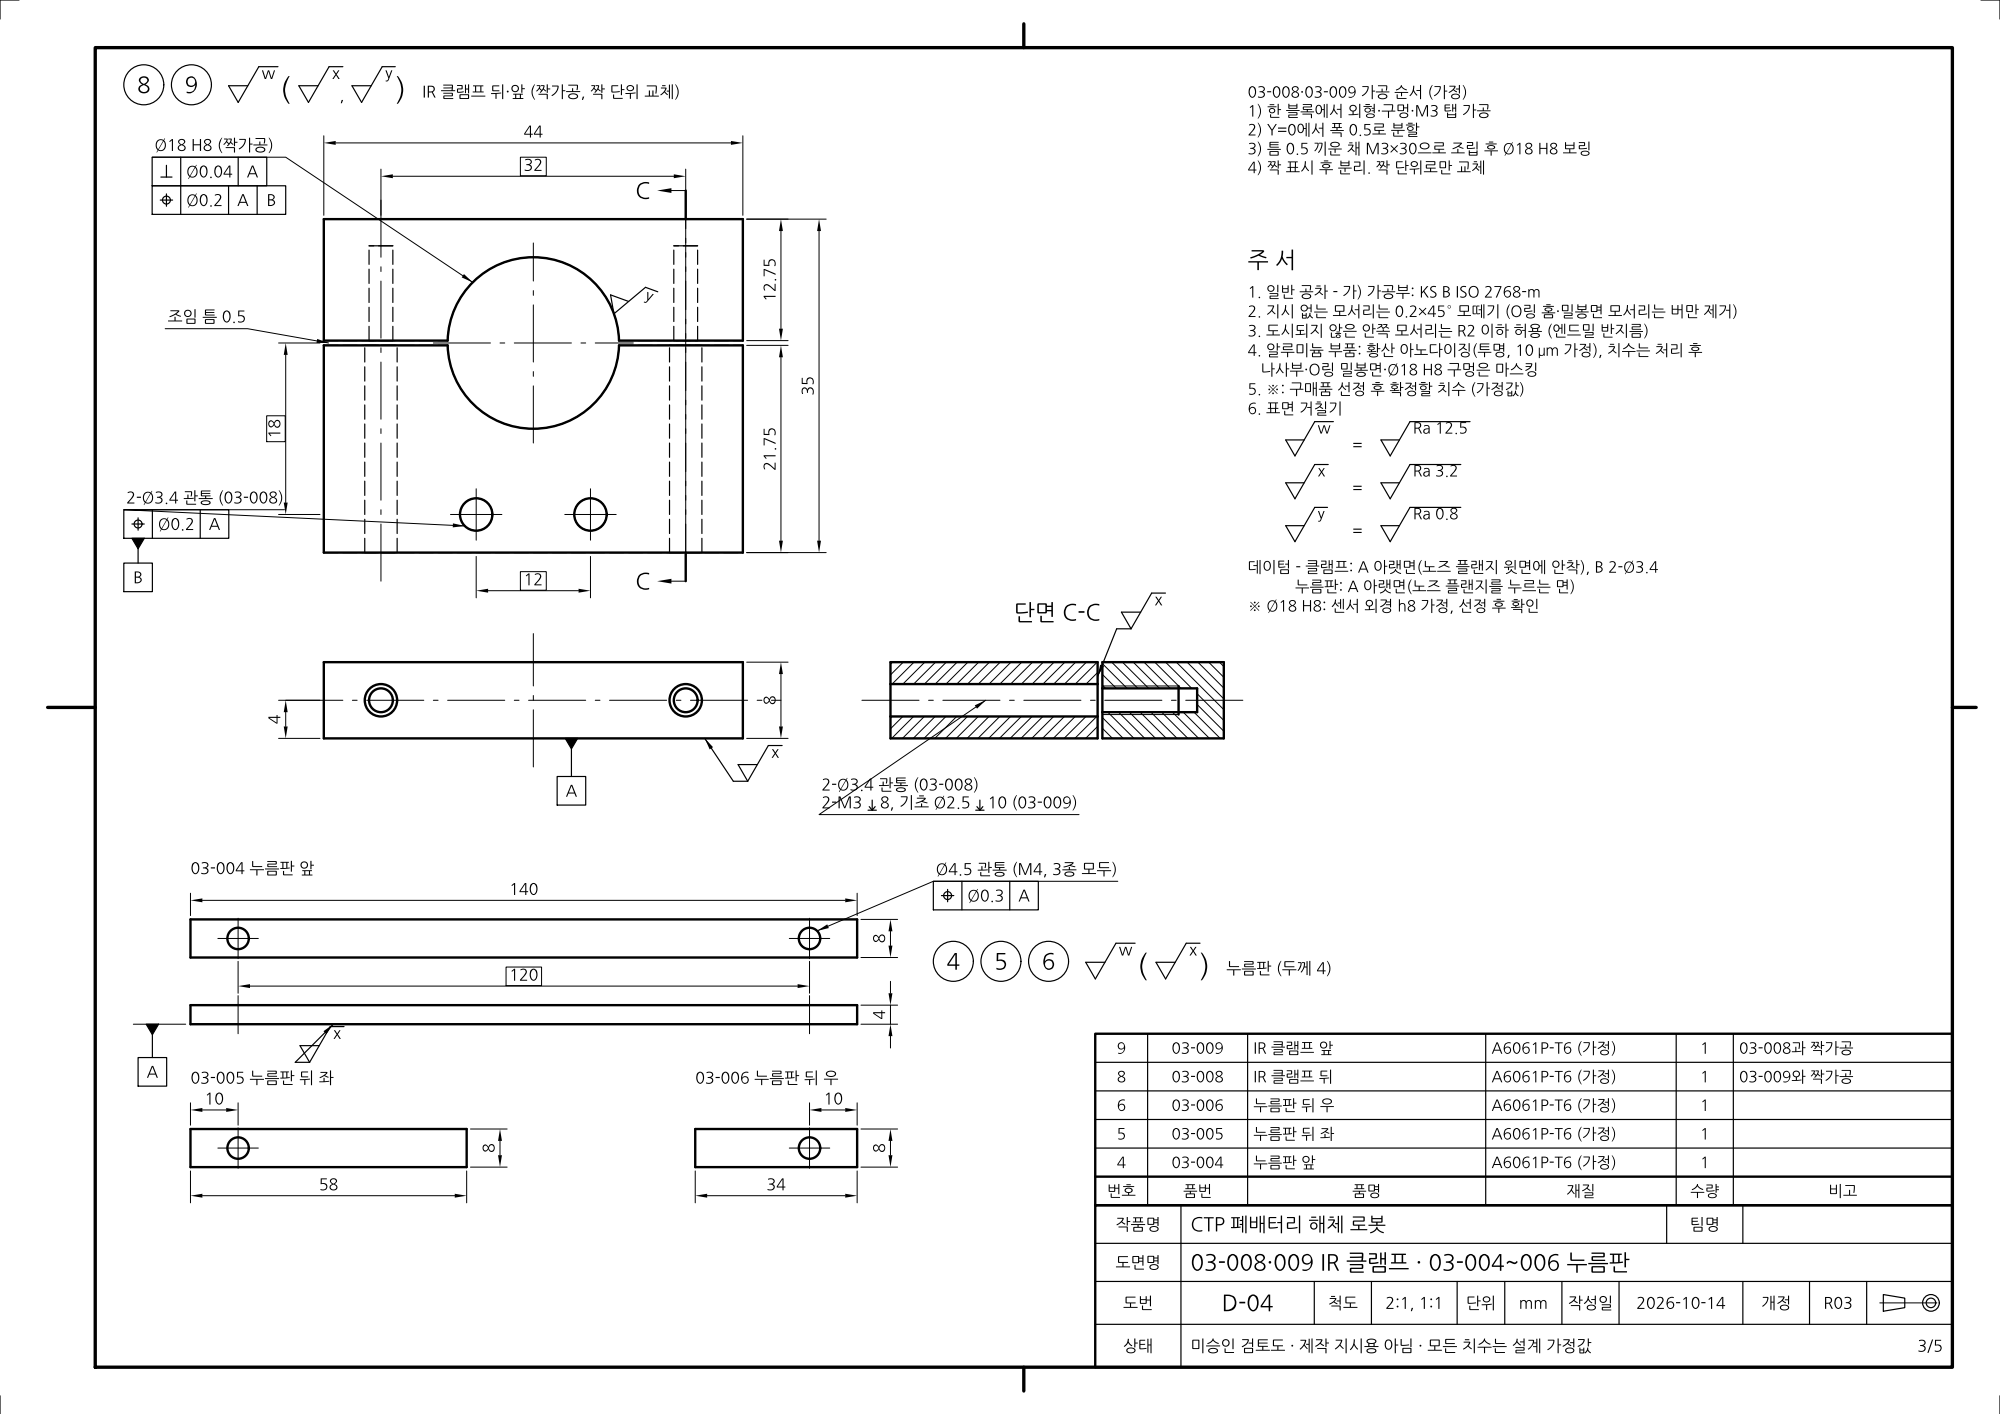
[picture p54: page 9]
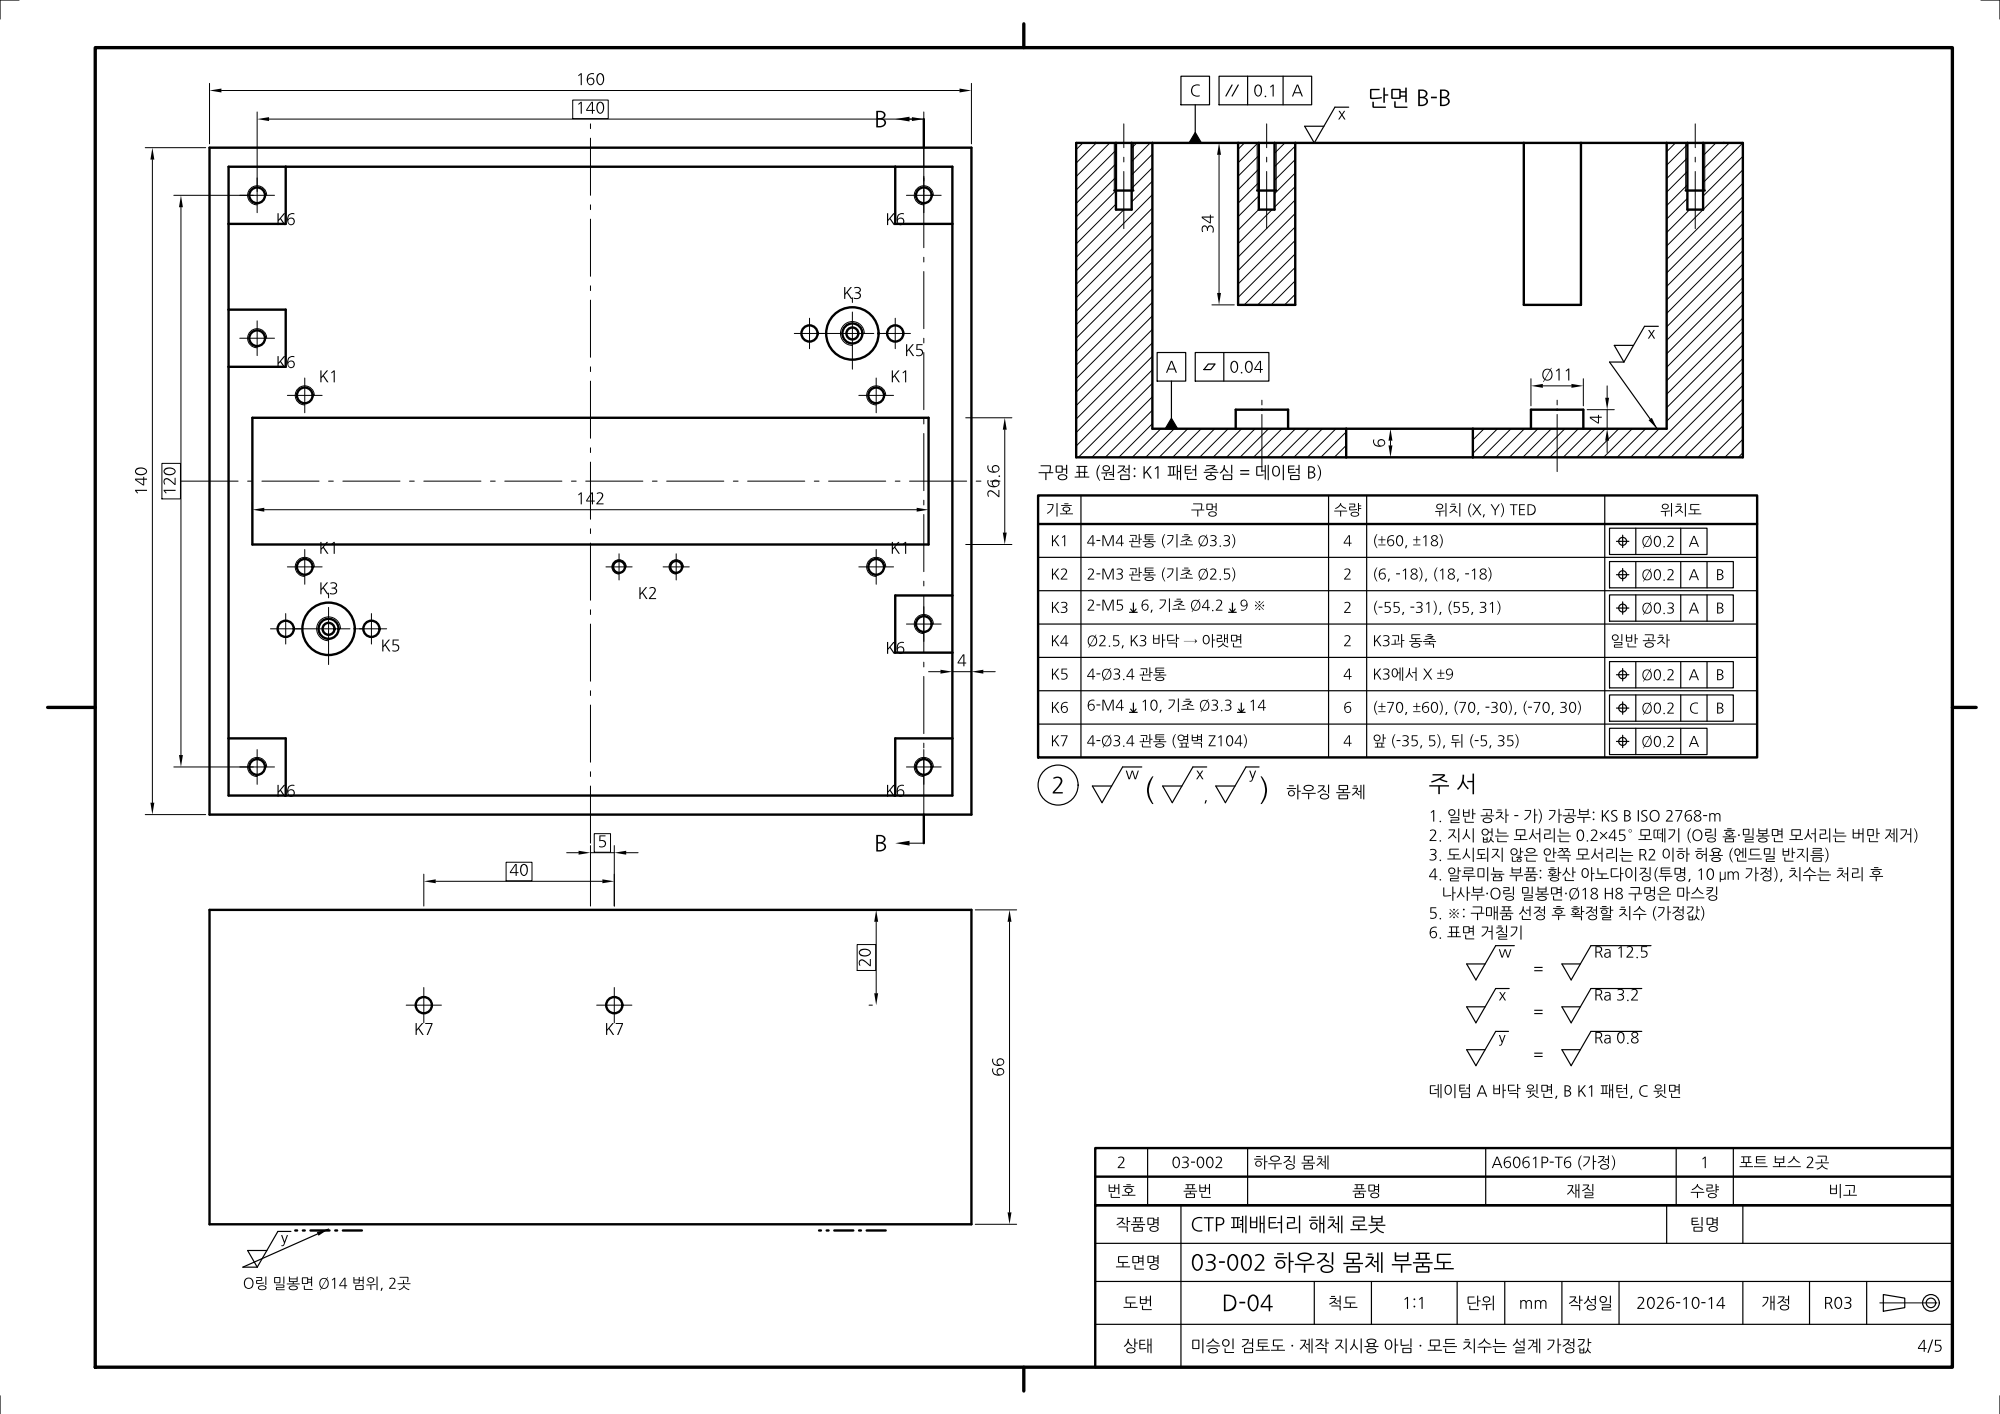
[picture p55: page 10]
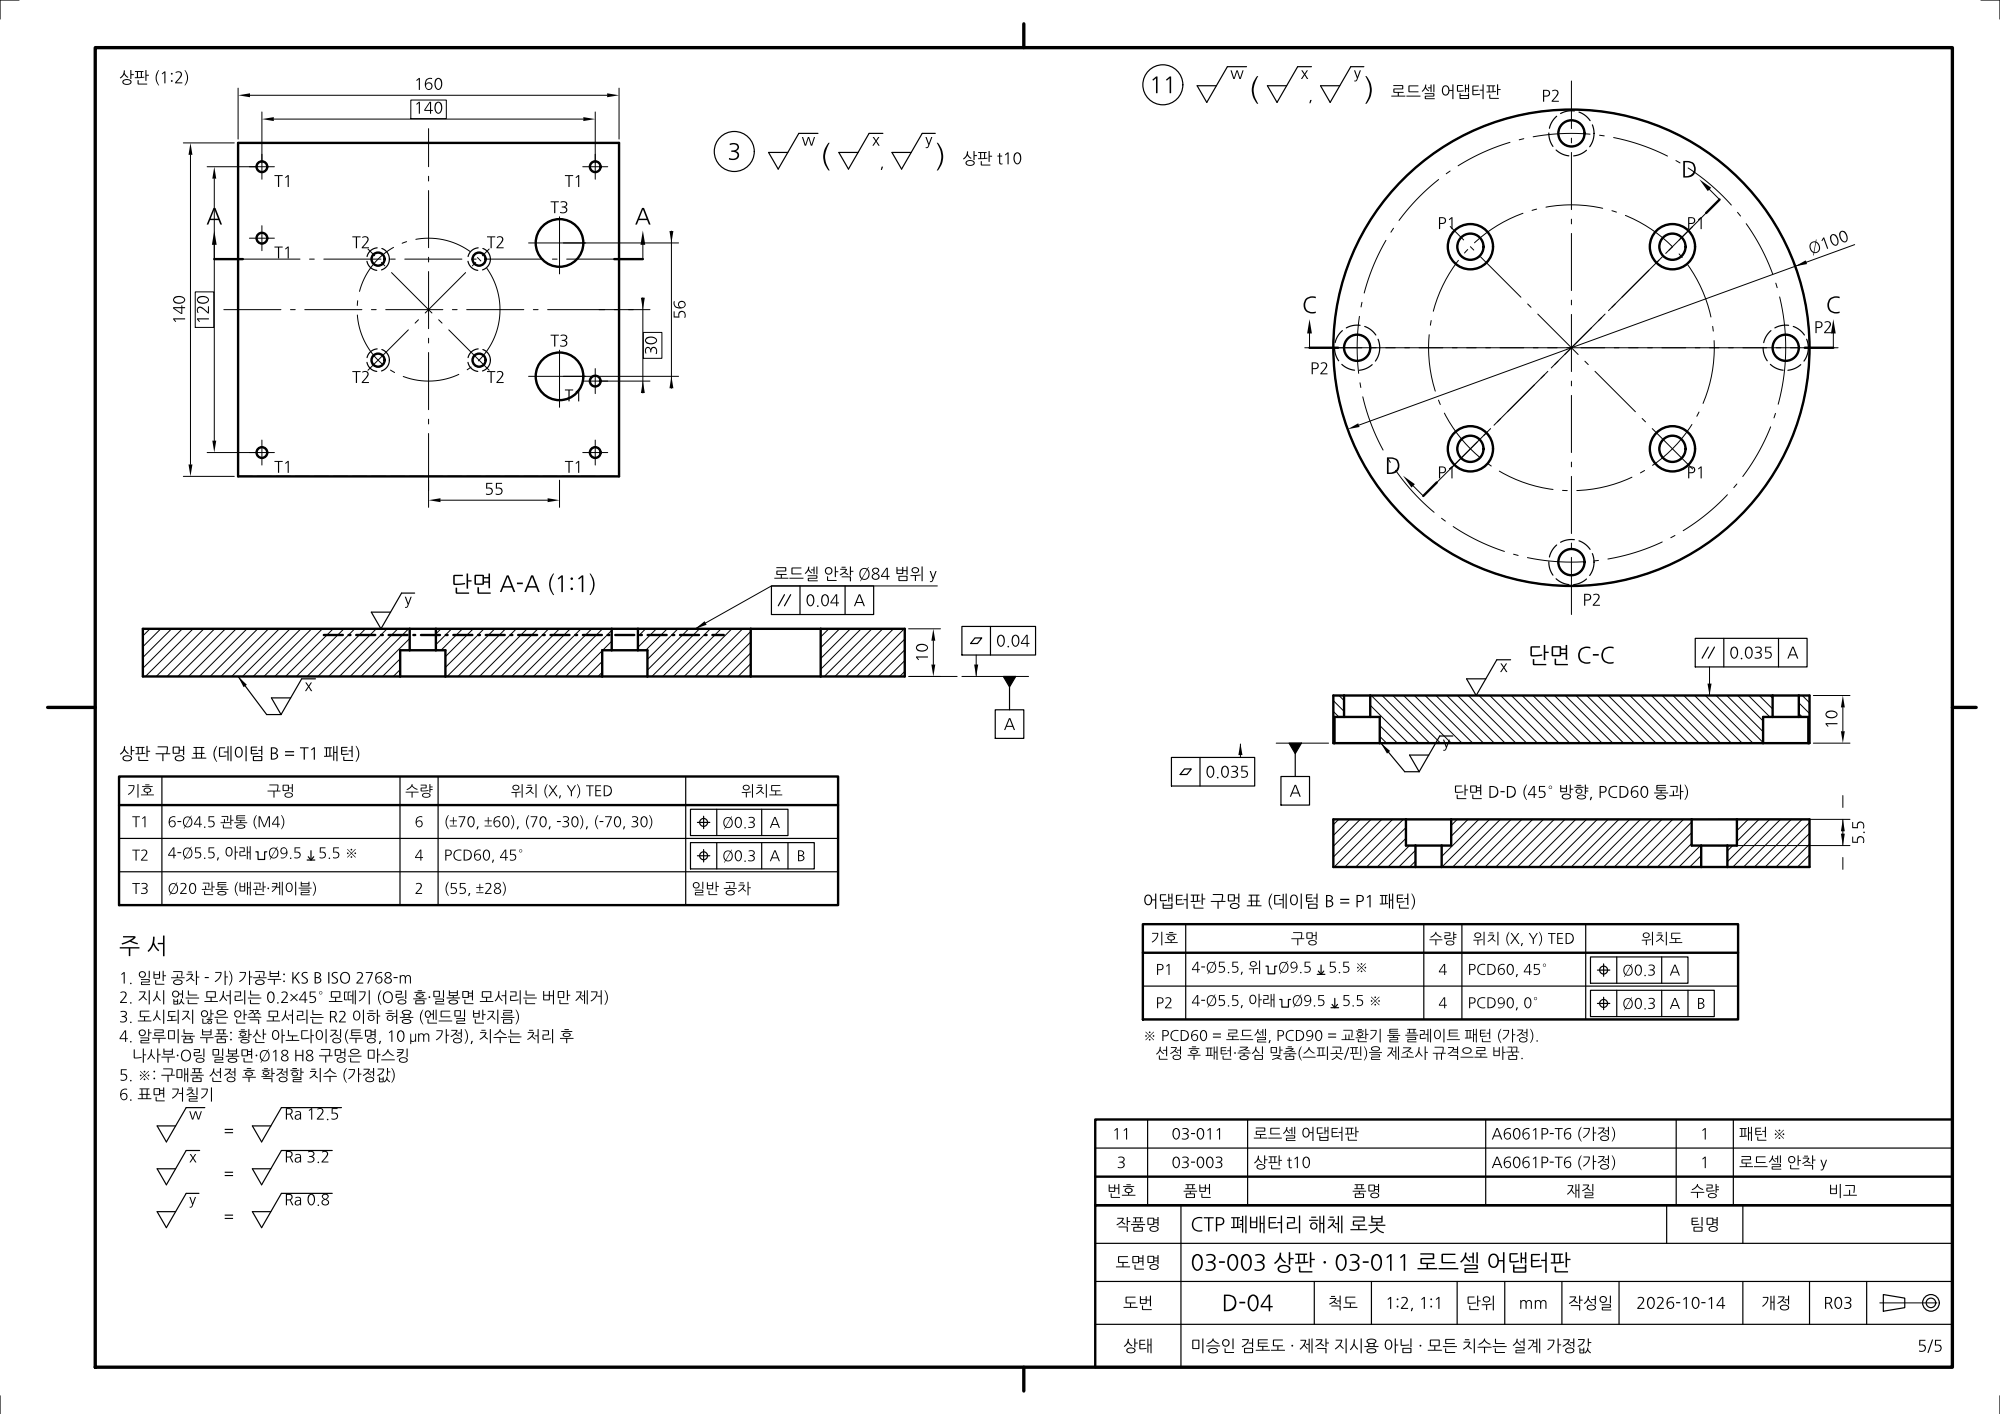
[picture p56: page 11]
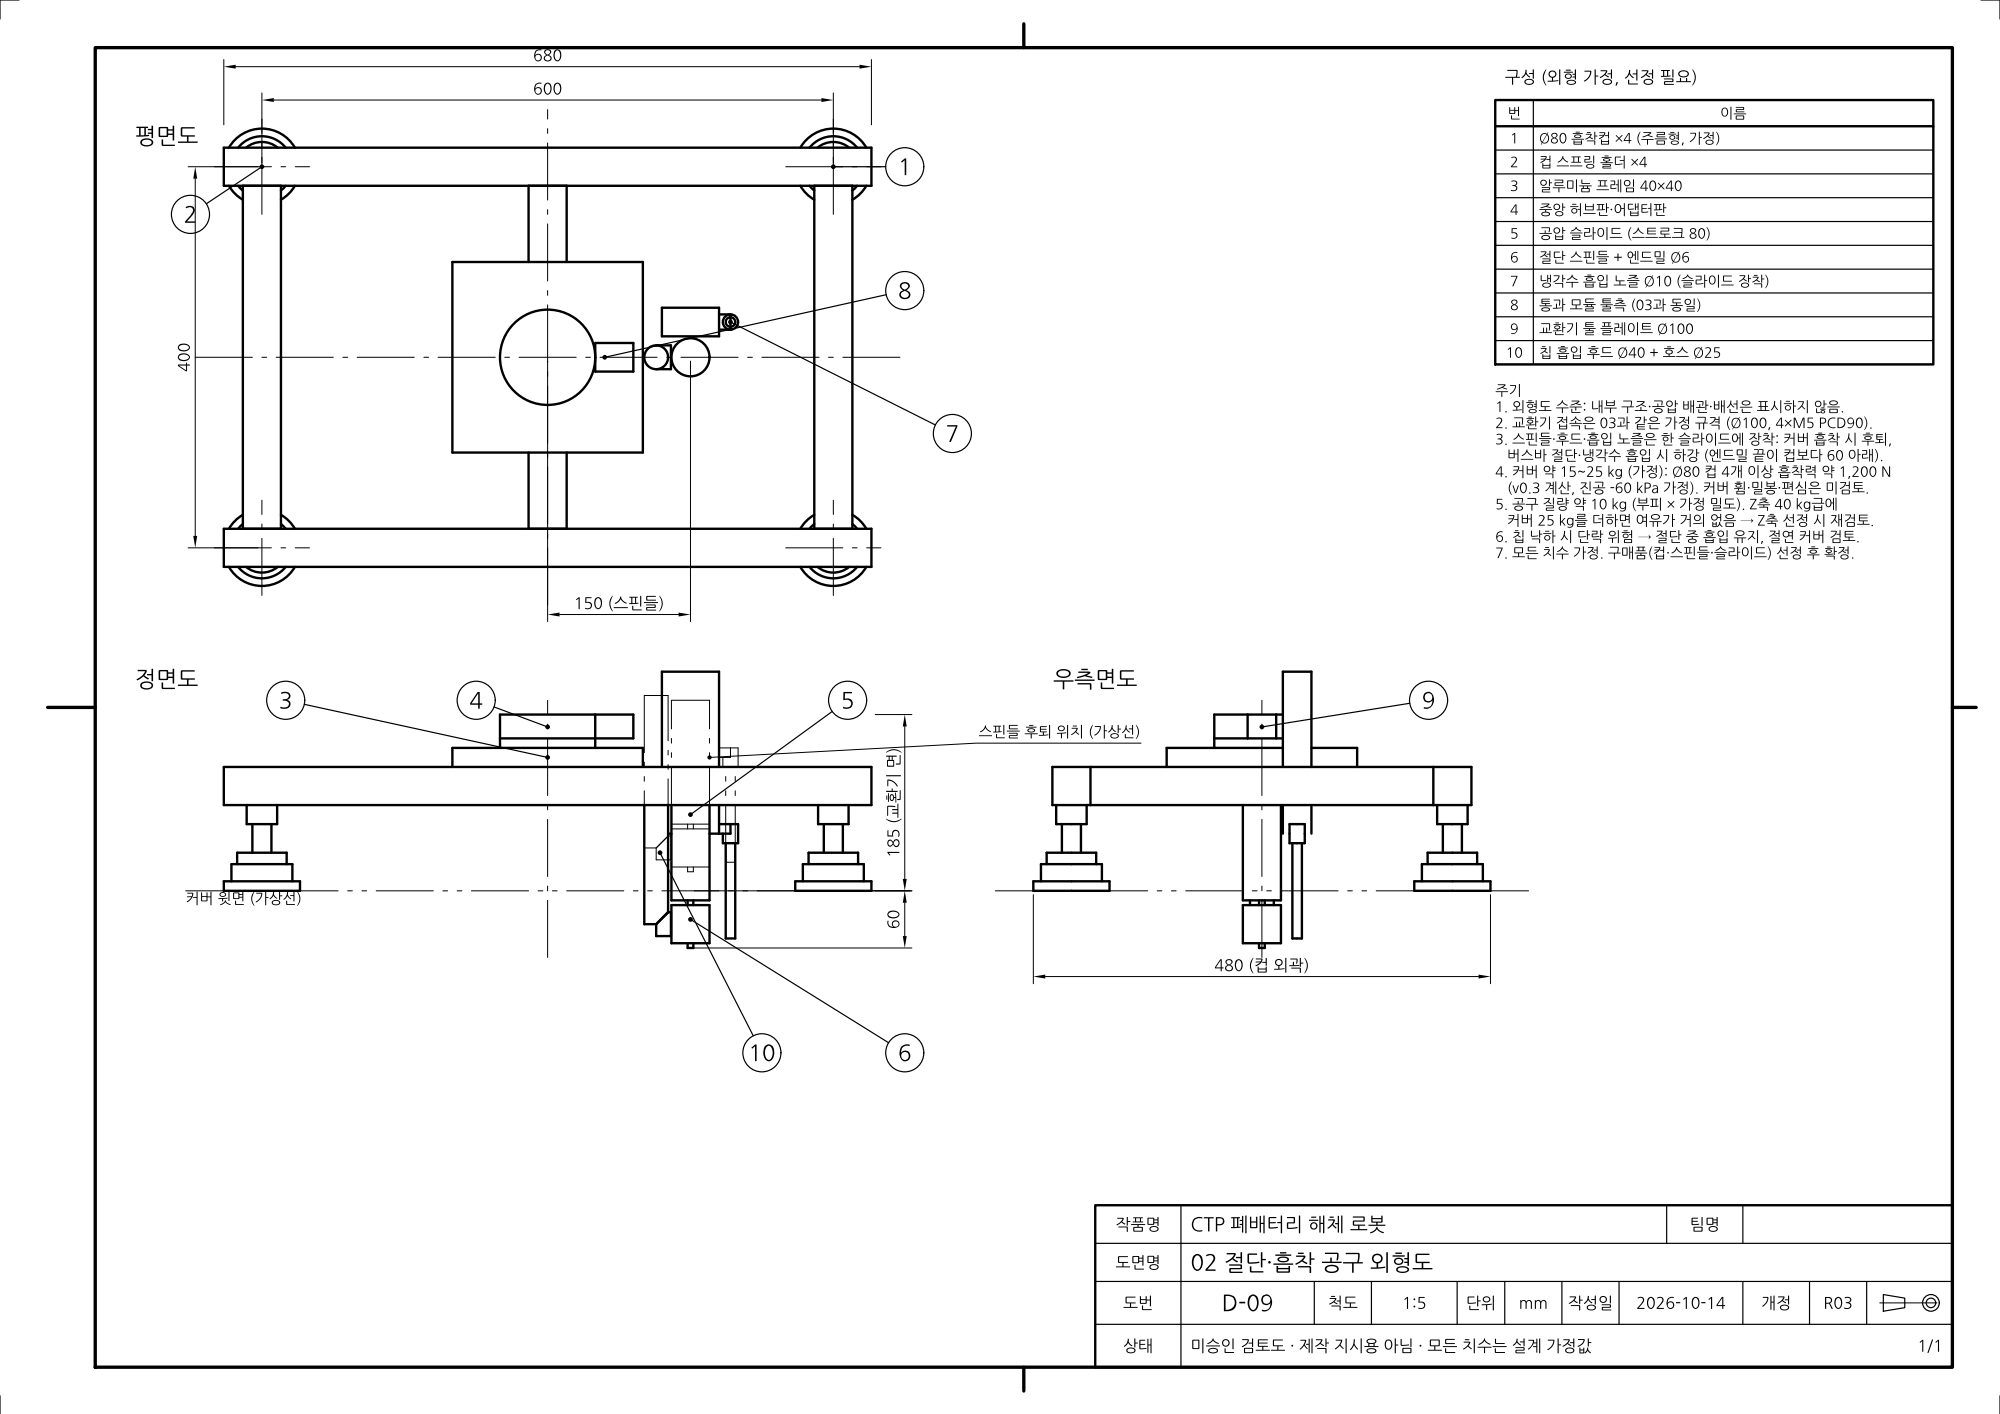
[picture p57: page 12]
