hwan94877103-cloud/Re-Cell/reports/R03_change_log.md

# CTP 폐배터리 해체 로봇 R03 - 변경·검사 기록 (2026-10-15, KS 개정·3D 뷰어 파일·해설 페이지·전체 공정 시뮬레이션·공정 순서 그림 포함)

기준: 가상 CTP 팩. 모든 치수와 배치는 설계 가정값이며, 실물·구매품 확인 전에는 제작 지시용이 아님.
KS 참고 자료: 2025 국가기술자격 CAD 실기시험용 KS 기계제도 규격 (발췌본, 이하 규격집). KS 원문 대조는 안 함.

## 1. 도면 세트 (A3, 12장)

| 도번 | 장수 | 내용 | 척도 |
|---|---|---|---|
| D-01 | 1 | 전체 구조·공정 배치도 (평면·정면·단면 B-B·참고 입체도, 구성 20개, 공정표) | 1:50 |
| D-02 | 3 | 03 셀 분리 공구 조립도 (단면 A-A·우측면·저면·입체도 / 상세·단면 B~E·접속 패턴 / 부품표 35행) | 1:2, 2:1 |
| D-03 | 2 | 셀·냉각판·가열 작업대 단면도 (단면 A-A·B-B / 코일 24구역 평면·상세 F·필링 자세·가열 원리) | 1:1, 1:2, 5:1 |
| D-04 | 5 | 03 부품도 - 규격집 형식 (노즈 / 컵 브래킷·노즐 블록 / IR 클램프·누름판 / 하우징 / 상판·어댑터판) | 1:1, 1:2, 2:1, 5:1 |
| D-09 | 1 | 02 절단·흡착 공구 외형도 | 1:5 |

- 01 나사 해체 헤드는 팀원 설계 → D-01에 외형 박스와 거치 위치만 표시.
- 모든 투상·단면은 3D 솔리드에서 직접 생성 (OCC 은선 처리, 불리언 단면).
- D-04 KS 근거표 (PDF·엑셀): 지시값마다 규격집 항 번호와 기능상 이유, 계산 검사.

## 2. 3D 변경

### KS 개정 (규격집 표 대조에서 발견, 값은 ks_spec.py)
| 항목 | 이전 | 이후 | 이유 |
|---|---|---|---|
| 누름판 볼트 | M5×18, 구멍 Ø5.5, 탭 M5 | M4×18, 구멍 Ø4.5, 탭 M4 | M5 머리 dk 최대 8.72 (16항) > 누름판 폭 8. 바닥 물림 6 = 1.5d로 좋아짐 |
| 노즐 블록 O링 홈 | Ø4/Ø7, 깊이 0.8 (규격 밖) | P6 평면 내압용: D 9.2, G 2.5 +0.25/0, H 1.4 ±0.05 (36항) | O링 03-213 추가, 압축률 26 % |
| IR 클램프 구멍 | Ø18.2 +0.1/0 | Ø18 H8 (센서 h8 가정, 틈새 0~0.054) | 조임 여유 0.5 안에서 확실히 물림 |
| 노즈 IR 구멍 | Ø18.4 | Ø19 | 클램프 볼트 여유가 있어 반경 틈 0.2로는 센서가 닿을 수 있음 |
| 피팅 포트 | 바닥 6에 M5 깊이 5 | 보스 Ø11×4 + M5 깊이 6, 기초 Ø4.2 깊이 9 | 불완전 나사부 a 2.4 (17항)를 빼면 완전 나사 2.6뿐이었음 |

### 03 공구 (R02 → R03)
| 항목 | R02 상태 | R03 처리 |
|---|---|---|
| 전압 프로브 | 제거됨 | 별도 측정대로 이동 (D-01) |
| 컵 라인 | 엘보 + 뒤 홈, 호스 0 반경 꺾임 | 니플 + 얇은 너트로 브래킷 고정. 호스는 노즈 Ø6 수직 구멍으로 위로 인출 (굽힘 R16) |
| 인서트 구멍 | Ø5.2 > 인서트 외경 | Ø4.5×8 (인서트 선정 후 확정 ※) |
| IR 클램프 | 나사·탭 없음 | 분할 클램프 + M3×30 조임 2개 + M3×25 발 나사 |
| 냉각 노즐 | PEEK에 직접 탭 | 하우징 바닥 아래 노즐 블록 2개 (M3×12, O링 P6, 바닥 공기 통로) |
| 덮개 | 체결 없이 로드셀 지지 | t10 구조 상판 + 보스 6개 (M4×20) |
| 로드셀·교환기 | 구멍 패턴 없음 | 4×M5 PCD60 / 4×M5 PCD90 (가정 ※) + 어댑터판 |
| 배관·밸브·배선 | 없음 | 진공 유닛 2개, 푸시인 피팅, 냉각 호스, IR 케이블, 통과 구멍, 툴측 통과 모듈 |

### 새로 만든 3D (모두 가정)
- 작업대 블록 (bench_r03): 셀 2열 × 12, 접착층 1, Al 냉각판 5, 비금속 상판 t4, 레이스트랙 코일 130×22 (24구역), 페라이트, 광섬유 온도 센서.
- 작업 셀 배치 (scene_r03): 펜스 5400×3000, 갠트리 이동 X 4050 / Y 1800 / Z 800, 2중 Y 브리지, 중공 Z 캐리지, 공구 거치대, 셀 측정대, 침수조, 회수함, 커버 거치대. 상부 장비는 Z 3150 위 (Z 램 최고 약 3094보다 위, 지지 구조 미표시).
- 02 공구 외형: Ø80 컵 4개 (600×400), 한 슬라이드에 절단 스핀들·칩 흡입 후드·냉각수 흡입 노즐.

## 3. 검사·계산 (CAD 상, 검증 아님)
- 03 공구: 솔리드 79개 유효, 정지 상태 겹침 0건. 정비 공구 접근 외곽 21곳 중 1곳 막힘 (냉각 호스 L 분리 후 접근).
- 가정 셀 기준 최소 틈: 컵-자기 단자 2.92, 컵-잔여 버스바 4.67, 컵-이웃 셀 5.25 mm.
- 필링: 셀 X- 아래 모서리 기준 회전 시 3.15°에서 블록 경계 부재 접촉 (가정 형상).
- 질량 (가정 포함): 03 분리 공구 3.38 kg, 이동 스택 6.60 kg. 02 공구 약 10 kg.
- 체결 하중 수계산: 볼트 1개 최대 하중은 보증 하중의 0.5~4.4 %. 실제로는 PEEK 크리프·열에 의한 예압 감소가 지배 요인이며 미검증.
- 도면 검사: DXF 12개 감사 오류 0 (글꼴 malgun.ttf), D-04 치수 72개 모두 솔리드 치수와 일치, 노즈 구멍 표 위치·깊이 일치, D-01·D-02·D-03·D-09 치수 = 모델 매개변수, 풍선 35/35, 부품표 수량 = 모델 수량.
- KS 검사: 계산 27항목 모두 기준 만족, 도면 DXF 글자에 지시값 모두 있음, 3D 구멍 지름·위치·깊이 = 지시값.
- 확인 못 한 것: ZYXCAD·AutoCAD에서 직접 열기, KS 원문 대조, 가공성·공차 누적 해석.
- 미검증: 실물 조립, 필링 동작, 강도, 열, 진공 유지, 전기 절연, 비상 대응.

## 4. 공정 영상
- 41초, 1280×720, MP4. 수정된 배치로 다시 렌더. 개념 애니메이션이며 시뮬레이션 결과가 아님.
- 순서: 03 공구 자동 교환 → 대상 셀로 이동 → 흡착 → 구역 가열 → 필링 (0→3°) → 들어 올림 → 측정대로 이송.

## 5. 3D 뷰어용 파일 (2026-10-15)
- 조립체 7개마다 STEP 옆에 같은 이름의 .glb, .stl 추가 (mesh_export.py).
  - GLB: 색·부품 구분, Y-up, 단위 m, 부품 1개 = 메시 1개(면 병합), 비금속 재질값(metallic 0, roughness 0.6). 펜스 반투명.
  - STL: 바이너리 한 덩어리, 단위 mm, Z-up. 전체 조립·배치도 STL은 펜스 제외.
- STEP·GLB 부품 이름을 영문으로 바꿈 (예: 000_03-001_nose_PEEK). 형상은 그대로.
- 확인: Khronos glTF 검증기 7개 모두 오류·경고 0, STL 헤더·삼각형 수·치수 범위, VTK로 다시 읽어 방향·색 확인, STEP 98개 다시 읽기 유효(솔리드 1353개), 전체 조립 정지 겹침 0.
- 확인 못 함: Windows 3D 뷰어·슬라이서에서 직접 열기.
- 전달: 패키지 ZIP(약 38 MiB)이 업로드 한도 30 MiB를 넘어 part1(00_ALL)·part2(D-01~D-09)로 나눔. 같은 폴더에 풀면 CTP_R03_package 하나로 합쳐짐.

## 6. 남은 결정·작업
1. 노즐 위치: v0.3 "노즈 양옆 30°" 대신 바닥 아래 수직 노즐 블록 승인 여부.
2. 컵 배치는 단자 안쪽 끝 |X| ≥ 57.1 mm 가정에 의존.
3. 패드 압축 해제 필요성 (가설): 패드 마찰 예시 약 400 N vs 이상 흡착력 약 57 N.
4. 로드셀 범위 선정, 호스·케이블이 로드셀을 가로지르는 영향. 로드셀·교환기 중심 맞춤(스피곳/핀)은 선정 후 제조사 규격으로.
5. Z축 40 kg급: 02 약 10 kg + 커버 25 kg + 마스터·기울임축 → 여유 거의 없음.
6. 필링 3.15° 한계: 블록 경계 부재와의 틈 5 mm (가정)에 의존 → 실제 팩 구조 확인 필요.
7. 비금속 상판 강도·내열·절연, 코일 간격·주파수, 접착 분리 온도·시간은 시험·해석 전 미확정.
8. 구매품 선정 (※): 컵, 니플·너트, M3 인서트, IR 센서(외경 공차), 진공 유닛, 피팅(나사 길이), O링 재질, 로드셀, 교환기, 통과 모듈, 02 컵·스핀들·슬라이드.
9. 품번은 R02 순서(노즈 = 03-001)를 따름 - v0.3 예시표와 다름. 표제란 팀명 기입.

## 7. 도면 해설 페이지 (2026-10-15)
- claude.ai 아티팩트 '도면 해설' (https://claude.ai/artifact/KWPR8XJtnth5XHJ5x6aUXb, 비공개): D-01~D-04, D-09 12장.
- 빨간 번호(도면에 있는 번호·기호 그대로, 없는 곳만 가·나·다)를 누르면 도면이 그 위치로 확대되고, 같은 번호가 3D 그림에도 표시됨. D-01은 공정 순서 단계별 표시.
- 3D 그림은 같은 CAD 모델에서 렌더 (반단면·층 분리 포함). 번호 위치는 도면 스크립트의 풍선·투상 좌표에서 계산.
- 소스: R03/explain (content.py 설명 글, scenes.py 3D, build.py, page.html).

## 8. 공정 시뮬레이션 (2026-10-15, 해설 페이지의 '공정 시뮬레이션' 탭)
- 실제 CAD 모델(scene_r03·bench_r03·tool03_r03)을 내보낸 3D(sim/scene.json)로 03 공구 셀 분리 공정을 브라우저에서 계산하며 재생. 영상이 아님.
- 계산하는 것 (모두 가정 모델):
  - 축 이동: 사다리꼴 속도(XY 400 mm/s, Z 200 mm/s), 이동 높이 = 경로 아래 가장 높은 장비 + 50 mm + 매달린 길이.
  - 열: 셀마다 냉각판·접착층·셀 바닥·셀 몸통 4점 열회로(24셀), 코일은 대상 구역만, 이웃 셀 냉각 공기.
  - 접착: 강도 400 N ÷ (1 + e^((T − 연화 온도)/6)), 당김은 한계까지만 올리고 가열 유지(v0.3 원칙), 필링은 바깥쪽 아래 모서리 기준 회전.
  - 비상: 셀 온도 80 °C 이상 또는 0.5 °C/s 넘는 상승 3초 → 가열 정지, 공구에 잡힌 셀이면 침수조로.
- 사용자가 바꿀 수 있는 값: 코일 출력, 냉각판 상한, 접착 연화 온도, 당김 한계, 필링 각도, IR 한계, 패드 압축 해제 여부, 가상 이상 발열.
- 기본값 결과 (가정): 첫 셀 가열·필링 47초, 이웃 셀 34~36초(예열 효과), 셀 1개 사이클 65~89초, 셀 바닥 추정 최고 92~94 °C, 이웃 셀 접착층 최고 58~59 °C.
- 시뮬레이션이 드러낸 설계 문제:
  1. 회수함 낙하: Z 최저(기울임축 Z 1164)에서도 셀 바닥 809 mm → 회수함 바닥(40)까지 약 0.77 m 떨어뜨려야 함. 회수함 받침을 올리거나 방식 변경 필요.
  2. 셀 바닥 온도: 접착층 바로 위라 셀 바닥이 접착층과 거의 같이 뜨거워짐(가정 주의 80 °C 초과). IR(셀 윗면)로는 바닥 온도를 볼 수 없음.
  3. 패드 압축을 풀지 않으면(예시 마찰 404 N) 300초 안에 분리 실패.
  4. 당김 한계가 이상 흡착력(56.5 N)보다 크면 컵이 먼저 떨어짐.
  5. 블록 안(공구에 안 잡힌) 셀의 이상 발열은 옮길 방법이 없음 → 대응 미정.
- 확인: 헤드리스 Chromium에서 3사이클·비상(운반 중/흡착 중)·패드 미해제·흡착 풀림·B열 대칭·모바일·다크 모드·three.js r147/r128 모두 오류 없이 동작.
- 확인 못 함: 실제 열전달·접착 분리 온도·흡착 유지·강도·절연(모든 물리값이 가정).
- 소스: R03/sim (export_scene.py, sim.js, sim.css, sim.html), R03/explain/make_page.py로 합침.

## 9. 전체 공정 시뮬레이션 + 공정 순서 그림 + 단계별 STEP (2026-10-15)
- 요청: 01·02 STEP을 보고서 공정 순서 그림에 쓰고, ZIP·해설 페이지·시뮬레이션에 모두 반영. 01은 외형 원기둥 그대로.
- 가정 형상 추가 (process_r03.py): 가상 커버 2200×1600(판 3, 플랜지 60, 높이 40, 약 25 kg 가정), 나사 38개(피치 약 200),
  실링 절개선(가장자리 25 mm 안쪽), 전장품 240×400×50, 냉각수 포트 2개, 대상 블록 버스바 연결부 44곳, 공구 거치 위치.
- 시뮬레이션 확장 (sim/sim.js): 01→02→01→02→01→02→03 공구 교환(거치대에서 잠금 1초 가정), 4~7단계 동작
  (나사 6초/개, 실링 20 mm/s, 커버 흡착 인양·90° 회전·거치대, 배선 4곳, 버스바 44곳, 전장품, 냉각수 60초+퍼지 30초),
  이어서 9~10단계(셀 24개). 단계 버튼으로 바로 가기, 이동 높이에 거치 중인 공구·커버·전장품 반영, Z축 하중 표시.
- 공정 순서 그림 (process_figs.py, explain/capture_process.py): 시뮬레이션 상태를 정해진 순간까지 계산 후 고정 시점 렌더,
  13장(2400×1500). 한 장 모음 가로 4×3(PNG·PDF), 세로 3×4 (process_storyboard.py).
- 단계별 STEP (process_steps_r03.py): 그림과 같은 순간의 상태(poses/*.json)로 CadQuery 조립을 다시 만들어 13개 저장.
  다시 읽기 유효, 정지 상태 겹침 검사(움직이는 쪽 vs 나머지, 가상 공정 물체 vs 고정 장면).
- 해설 페이지: '공정 순서' 탭(그림 카드, 크게 보기, 원본 PNG, '이 장면부터 시뮬레이션'), D-01 공정 단계 선택 시 해당 그림.
- 기본값 실행 결과 (가정): 4단계 13.0분, 5단계 5.3분, 6단계 0.8분, 7단계 2.0분(공구 교환 7번 112초 포함),
  셀 24개 약 24분(평균 61초/개). 전체 약 46분.
- 드러난 문제 (가정 배치 기준):
  1. 커버 거치대에 놓은 커버가 공구 거치대 다리 2개(각 13,050 mm³)·거치 중인 02 흡착컵 2개(각 6,489 mm³)와 겹침.
     거치대(1400×2000)가 커버(2150×1550)보다 작고, 거치대 중심 X 4450이 갠트리 X 끝 4400보다 바깥.
  2. 실링 절개 7.4 m 중 약 175 mm는 갠트리 행정 밖 (엔드밀이 공구 중심에서 150 mm, 노즐·호스를 커버 밖으로 두는 방향 기준).
  3. 커버 인양 Z축 하중 약 38.2 kg / 40 kg급 (96%).
  4. 전장품 회수함 낙하 약 0.70 m, 셀 회수함 낙하 약 0.77 m.
  5. 실링 절개 때 흡착컵-커버 윗면 틈 19.5 mm (커버 높이 약 55 mm 이상이면 접촉).
  6. 공구 교환 7번 → 배선+전장품(01), 버스바+냉각수(02)로 묶으면 5번 (순서 변경 가능 여부 확인 필요).
- 고친 것: 나사 3D의 나사부가 팩 프레임 안으로 들어가던 것(구멍 미모델링) → 플랜지 두께까지만.
  시뮬레이션에서 단계 이동 후 다음 셀 지정이 사라지던 것, 그래프 빈 상태 글자 겹침.
- 확인 못 함: 실제 커버·나사·실링·전장품·포트 형상, 01 실제 형상, 실링 절개 공구 세부, 모든 물리값(가정).
- 전달: 패키지 ZIP 4개 (part1 00_ALL 21.8 MiB, part2 D-01~D-09 15.7 MiB, part3 공정 그림·한 장 모음·01/02 STEP 9.1 MiB,
  part4 단계별 STEP 18.9 MiB). 같은 폴더에 풀면 CTP_R03_package 하나로 합쳐짐. 해설 페이지는 같은 주소에 4판으로 갱신.
- 확인: 헤드리스 Chromium에서 4~10단계와 셀 24개까지 끝까지 실행(오류 0), 단계 바로 가기 6개, 그림 장면 바로 가기 13개 중 대표
  (5-2·비상), 공정 순서 탭(그림 13장 로드, 크게 보기, 내려받기 링크), D-01 단계 그림, 모바일 가로 넘침 0, 다크 모드,
  three.js r128 대체 경로. STEP 13개 ZIP에서 꺼내 다시 읽기 유효.

## 10. 해설 보완 + 해설 페이지 한 파일 HTML (2026-10-15)
- 시뮬레이션에서 드러난 문제를 도면 번호 설명에 연결 (모두 가정 배치 기준):
  D-01 14 커버 거치대(커버보다 작고, 공구 거치대 다리·거치 중인 02와 겹침, 중심이 갠트리 밖), 11·12·13 회수함(전장품 0.70 m·셀 0.77 m 낙하),
  10 비상 침수조(블록에 붙어 있는 셀은 옮길 방법 없음), 5·6·7 갠트리와 D-09 1 흡착컵(커버 인양 Z 하중 약 38 kg = 40 kg급 96%,
  3 mm 알루미늄 커버면 약 29 kg으로 40 kg 초과), D-02 15 IR 센서(윗면만 측정, 바닥 약 95 °C일 때 윗면 30 °C대),
  D-03 4 패드(압축 해제 안 하면 분리 실패)·5 접착층(셀 바닥 약 95 °C, 가정 주의 80 °C 초과).
- 빠진 설명 추가: 02 엔드밀로 실링 절개(가정, 세부 미정)와 행정 밖 약 175 mm·컵-커버 틈 19.5 mm, 01이 배선 제거·전장품 분리도 맡음,
  D-01 공정 단계를 누르면 그 단계 그림이 나온다는 안내, 냉각수 노즐 흡입·퍼지.
- 단정 표현 완화: D-02 1 노즈 "이웃 셀·단자와 닿지 않음" → 가정 셀 치수, CAD 정지 상태 기준이며 실물 미확인.
- 내려받기: 도면 12장 PDF, 공정 개념 영상, 도번별 PDF, D-04 KS 근거표, 공정 그림 원본·한 장 모음. claude.ai 화면에서는 일반 링크가 막혀서
  downloads 기능(보는 사람이 저장 확인)으로 내려받고, 기능이 없으면 링크를 숨김. 숨김 처리 규칙을 페이지에 직접 넣음.
- 한 파일 HTML (explain/make_standalone.py → CTP_R03_explainer.html, 약 8 MiB): 그림은 data URI, three.js r147과 시뮬레이션 장면을
  파일 안에 넣어 인터넷 없이 열림. 내려받기 링크는 패키지 폴더 상대 경로(ZIP 4개를 한 폴더에 풀었을 때 동작).
- 확인: 네트워크를 막고 file://로 열어 도면 12장·3D 그림·공정 그림 13장 표시, 크게 보기, 시뮬레이션(장면 바로 가기, 첫 셀까지 실행),
  모바일·다크 모드 확인. 해설 페이지(호스팅)도 내려받기 링크 응답·탭·시뮬레이션 다시 확인.
